valeb/Projekt/Bilder/DSC_0028.JPG

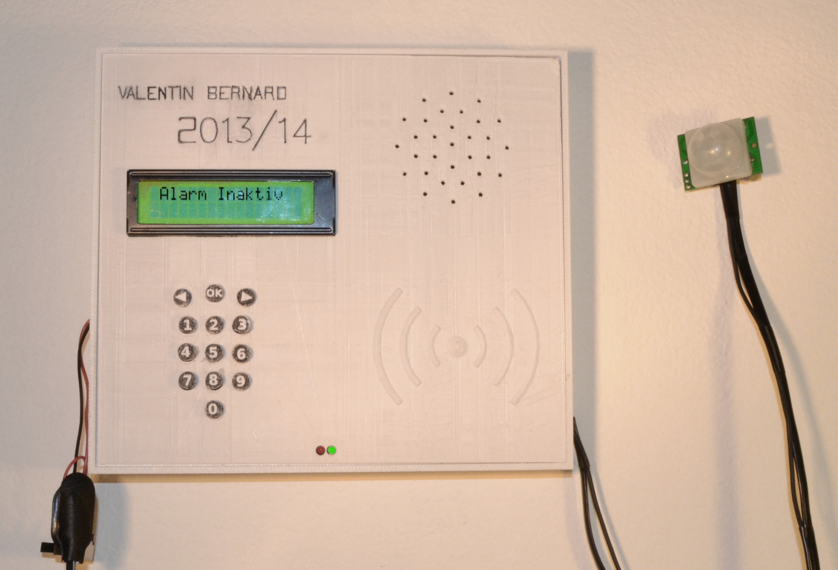
Bilder/DSC_0028.JPG
