valeb/Projekt/Bilder/MFRC522_Kit.JPG

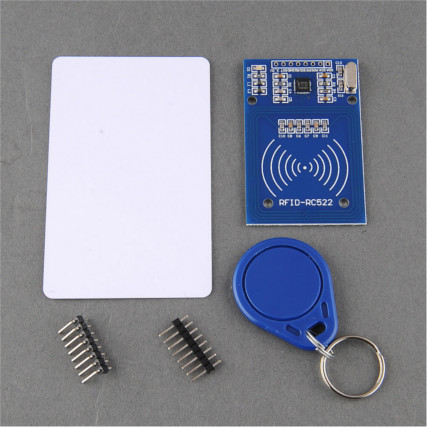
Bilder/MFRC522_Kit.JPG
