valeb/Projekt/README.md

Projekt
=======

Maturaprojekt von Valetnin Bernard, 5AEL Gewerbeoberschule Meran, SJ 2013/14
Alarmanlage mit RFID-Deaktivierung
