valeb/Projekt/Links.txt

RFID teuer: http://id-innovations.com/httpdocs/Modules%28non%20write%29.htm

RFID billig: http://www.dhgate.com/product/hot-sale-rc522-card-read-antenna-rfid-reader/169091775.html#s1-3-1|2641187833

Audio Generieren: http://www.engineersgarage.com/embedded/pic-microcontroller-projects/How-to-Generate-Sound-Using-PWM-With-PIC-Microcontroller

Bewegungsmelder: http://www.dhgate.com/product/wholesale-arduino-sensitive-pir-body-movement/131228033.html#s1-3-1|3856376912

Lichtschranke: http://www.conrad.de/ce/de/product/191710/Conrad-IR-Lichtschranke-Sender-EmpfaengerBausatz-12-15-VDC-Reichweite-max-5-m;jsessionid=CFABC5CF739E0C19DD2BF7DB4CFFCC95.ASTPCEN02
