valeb/Projekt/Dokumentation/Dokumentation.odt

Projektdokumentation:

Alarmanlage mit RFID-Tag

Ein Projekt von Valentin Bernard
GOB Meran 2013/14

# Projektbeschreibung

## Ziel des Projekts

Im Rahmen des Fachs Technisches Zeichnen und Projektieren muss jeder Schüler der Elektronik-Fachrichtung der Gewerbeoberschule Meran in der fünften Klasse ein selbst gewähltes Abschluss- projekt realisieren. Ich habe mich für eine Alarmanlage entschieden.

Ziel des Projekts war es, eine Anlage zu entwickeln, welche das Eindringen einer Person in einen Raum erkennt und dies akustisch meldet. Dabei sollte sich die Anlage per Knopfdruck von jedem aktivieren lassen, aber nur die Eingabe eines Passcodes oder das Annähern eines RFID-Tags sollten sie deaktivieren können.

## Erster Entwurf

### Hardware

Im erstem Entwurf war eine Anlage, bestehend aus einer Zentrale und diversen angeschlossenen Sensoren vorgesehen. Als Sensoren waren handelsübliche Infrarot-Bewegungsmelder oder Lichtschranken vorgesehen..

Die Zentrale sollte aus einer Platine in einem 3D-gedruckten Gehäuse bestehen, welche mehrere Eingänge für Sensoren, ein Tastenfeld für die Eingabe des Deaktivierungscodes (1-9 und „Enter“), einen Taster für die Aktivierung der Anlage, ein RFID-Lesegerät, einen Lautsprecher sowie eine rote und eine grüne LED zur Statusanzeige beinhalten sollte. Ein LCD-Bildschirm war lediglich als Zusatzfunktion geplant.

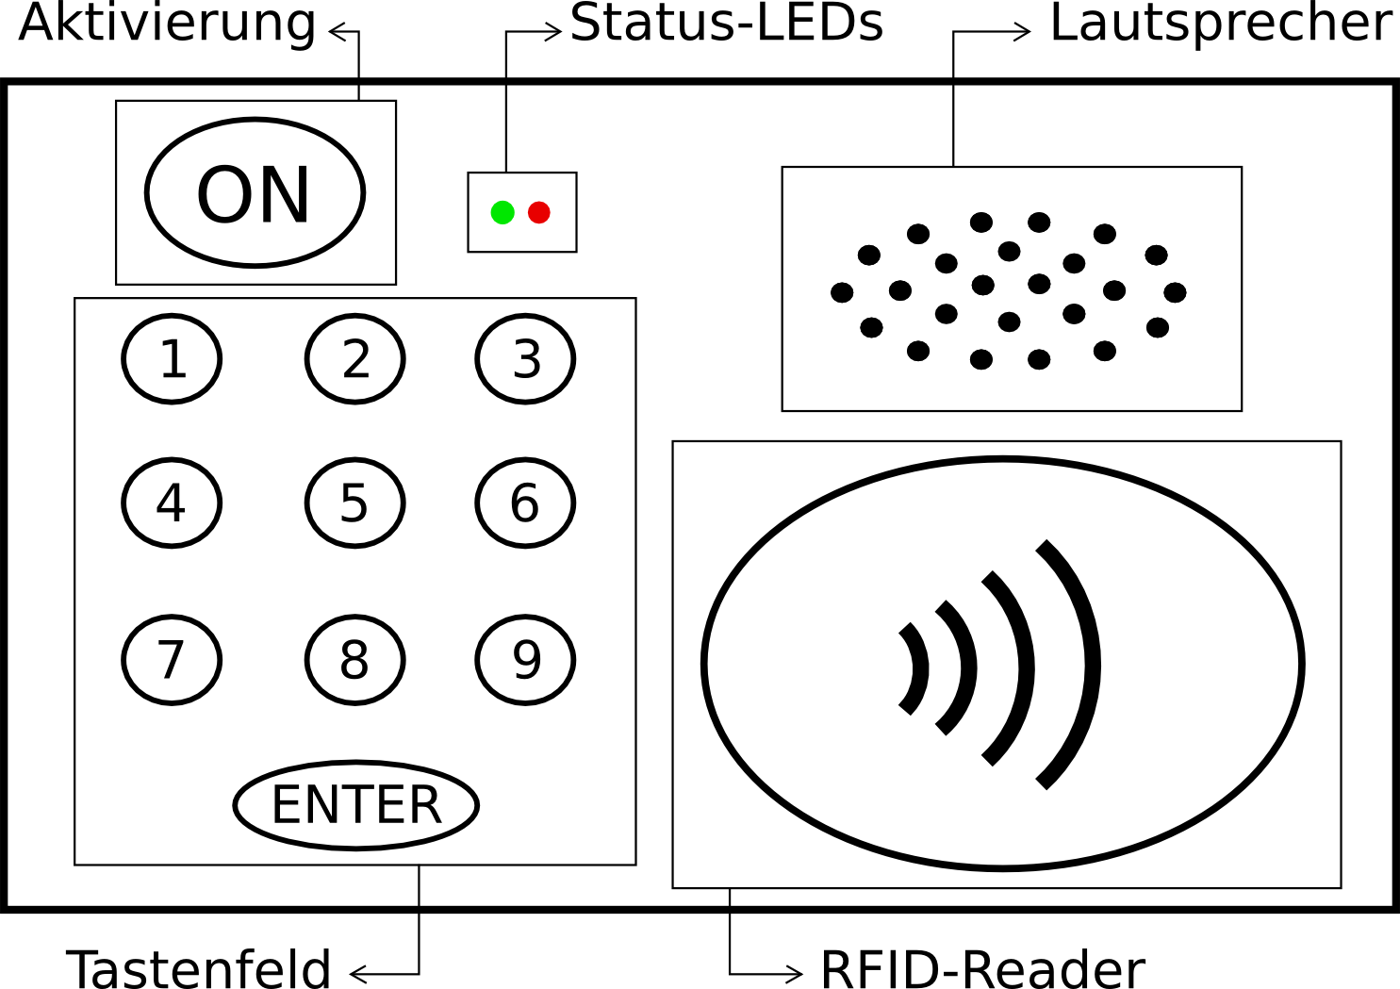
[picture p3: figure]

Abbildung 1: Erster Hardware-Entwurf

### Software

Die Alarmanlage sollte, nach der Aktivierung durch einen Knopfdruck, ständig sämtliche Sensoreingänge kontrollieren. Sobald ein Sensor aktiviert wird, sollte ein Alarm ausgegeben werden. Nach 5 Minuten ohne Sensorsignal sollte sich der Alarm wieder ausschalten, um unnötige Lärmbelästigung zu vermeiden.

Die Deaktivierung der Anlage sollte über die Eingabe eines selbst gewählten Passworts oder über ein RFID-Tag erfolgen, welches vom eingebauten RFID-Lesegerät erkannt wird. Das gewählte Passwort sollte nach Ausfall der Stromversorgung erhalten bleiben.

Die Status-LEDs sollten den Zustand der Anlage anzeigen: Rot für „Aktiv“, grün für „Inaktiv“. Dies war im ersten Entwurf die einzige Form der Visualisierung des Zustands.

### Zusatzfunktionen

Im ersten Entwurf war vorgesehen, nach Realisierung der Grundfunktionen weitere Zusatzfunktionen zu implementiert sofern dafür noch Zeit zur Verfügung stand. Die angedachten Funktonen waren: die Aktivierung des Alarms nach mehrmaliger Falscheingabe des Codes, Deaktivierung über Funk oder sogar die Versendung eines Alarm-SMS über ein GSM-Modul.

## Realisiertes Projekt

Die realisierte Anlage entspricht in großen Teilen dem ersten Entwurf, jedoch unterscheidet sie sich in einigen Details, auf welche im Folgenden grob eingegangen wird.

### Funktionsbeschreibung

Die Funktion der Anlage entspricht der Aufgabenstellung. Die Anlage erkennt, solange sie aktiviert ist, das Eintreten einer Person oder eines Tiers in einen Raum mit Hilfe eines Bewegungsmelders und gibt darauf hin über einen Lautsprecher einen relativ lauten akustischen Alarm aus. Die Aktivierung erfolgt, wie vorgesehen, per Knopfdruck, und die Deaktivierung erfolgt per Eingabe des selbst gewählten Passwortes. Die Deaktivierung mit RFID-Tag funktioniert aus bisher ungeklärten Gründen noch nicht, Näheres dazu im Kapitel „Software – RDIF“(S.??). Die Anlage benötigt eine externe Gleichstromversorgung von 9-12V.

Von den Zusatzfunktionen wurde bisher keine implementiert, jedoch könnte mit der bestehenden Hardware die Funktion „Aktivierung durch Falscheingabe“ realisiert werden. Nachdem nur ein Prototyp der Platine gefertigt wurde, ist es unmöglich weitere Funktionen hinzuzufügen, da diese eine Erweiterung der Hardware voraussetzen.

### Hardware

Die Hardware der Anlage unterscheidet sich in einigen Punkten vom ersten Entwurf. Ein Unterschied besteht darin, das lediglich ein Sensoranschluss auf der Platine vorgesehen ist, nämlich der für den Infrarot-Bewegungsmelder. Außerdem wurde Der LCD-Bildschirm bereits in die erste Version integriert, um eine zusätzliche Vereinfachung der Bedienung zu erzielen. Weitere kleinere Änderungen betreffen die Ergänzung einer Vor- und einer Zurück-Taste sowie die Verschmelzung des Aktivieren-Knopfs mit der OK-Taste. Der Rest der Hardware entspricht dem ersten Entwurf.

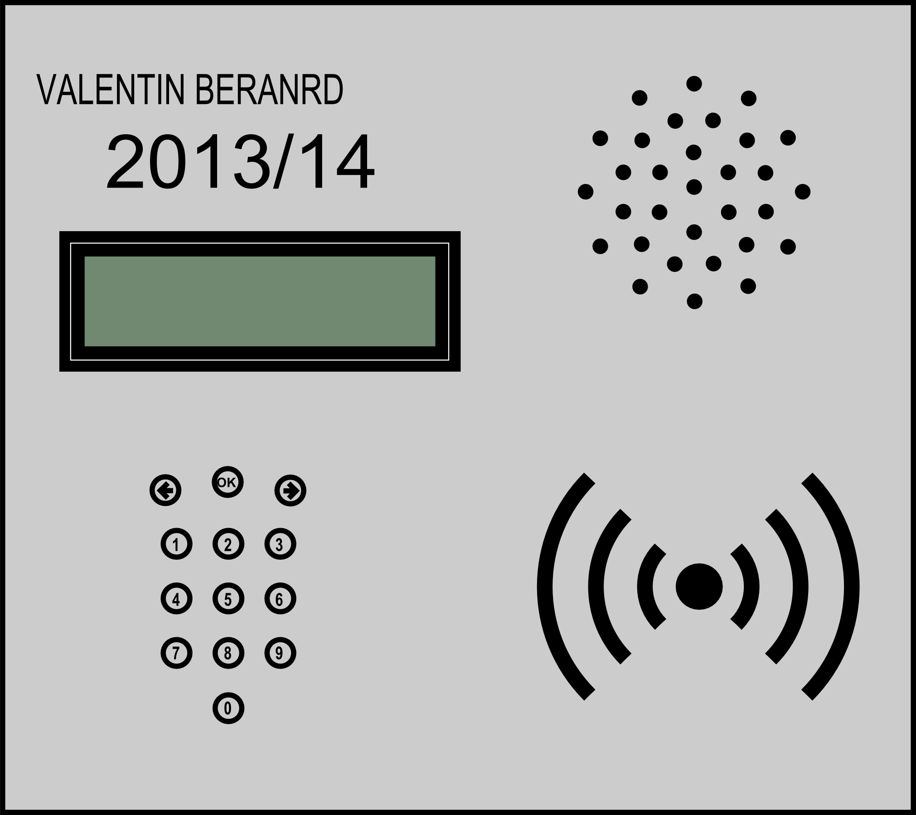
[picture p4: figure]

Abbildung 2: Gehäusedeckel

Abbildung 3: Platinen und Lautsprecher

Abbildung 3: Gehäusedeckel

### Software

Die Alarmanlage wertet, solange sie aktiv ist, ständig den angeschlossenen Bewegungsmelder aus. Wird dieser ausgelöst wird über den eingebauten Lautsprecher ein Alarm ausgegeben welcher wie geplant nach 5 Minuten ohne Bewegung verstummt.

Die Deaktivierung über das Passwort sowie die Möglichkeit der Abänderung desselben wurde erfolgreich implementiert, jedoch wird das Passwort bei Unterbrechung der Stromversorgung auf den Standartwert zurückgesetzt. Die Deaktivierung über ein RFID-Tag bereit einige Probleme, doch die Kommunikation mit dem Lesegerät über die SPI-Schnittstelle funktioniert einwandfrei. Das Problem liegt nur noch beim Übermitteln der richtigen Befehle an das Lesegerät.

# Technische Details

## Hardware

### Schaltplan

Der Schaltplan für das Projekt wurde mit Eagle™ 6.5.0 erstellt. Die meisten Bauteile waren in der Standardbibliothek zu finden, für den Mikrocontroller wurde zusätzlich eine Bibliothek von Motorola verwendet.

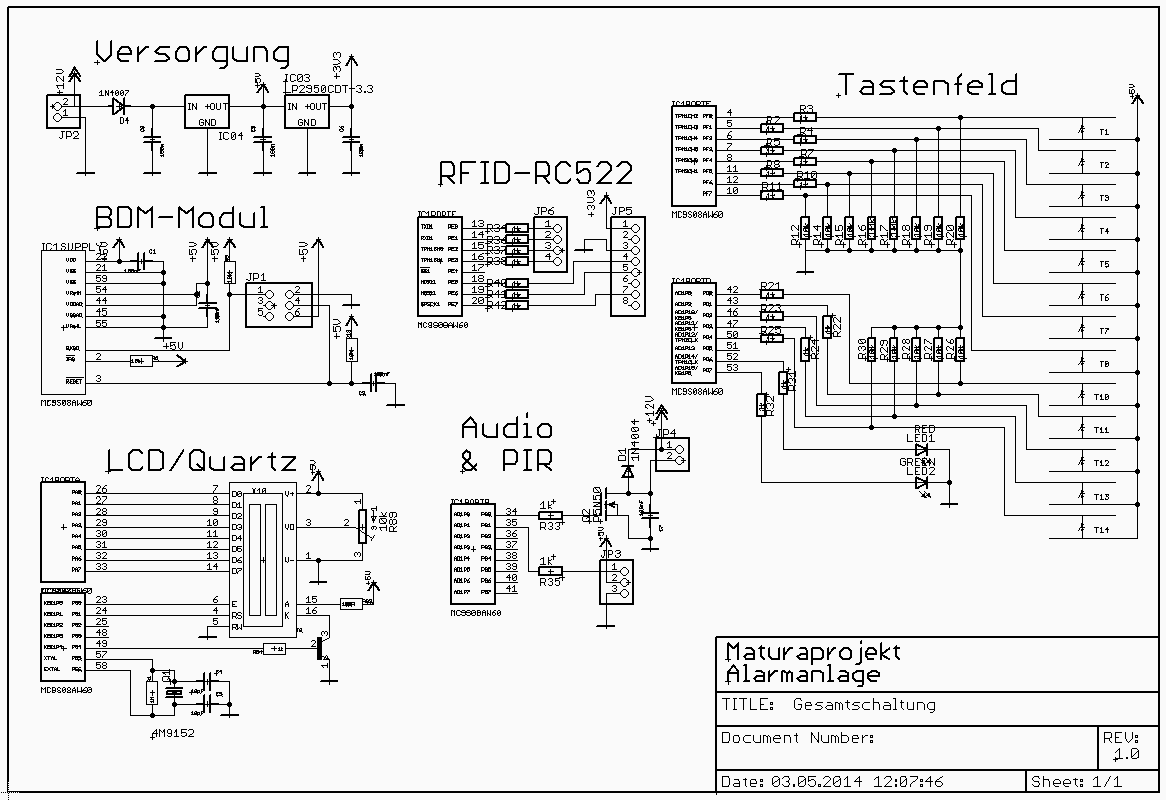
[picture p5: figure]

Abbildung 4: Vollständiger Schaltplan Ein Ausdruck in besserer Qualität befindet sich in den Anlagen

Die Planung der Schaltung erwies sich bei diesem Projekt als nicht sonderlich aufwendig, da der selbe Controller und das selbe LCD-Display verwendet werden wie auf dem Demoboard, weshalb die entsprechenden Schaltblöcke direkt vom Demoboard übernommen werden konnten. Der Rest der Schaltung besteht großteils aus Tastern und Steckerleisten. Der einzige Schaltblock der einige Entwicklungsarbeit erforderte war jener zur Ausgabe des Alarms über einen Lautsprecher.

### Schaltung Lautsprecher

Die Schaltung für die Ausgabe des Alarms besteht aus einem Mosfet, einem Freilaufdiode und einer Klemme mit 2 Anschlüssen für den Lautsprecher. Außerdem wurde ein Kondensator zur Abrundung des Rechtecksignals eingebaut.

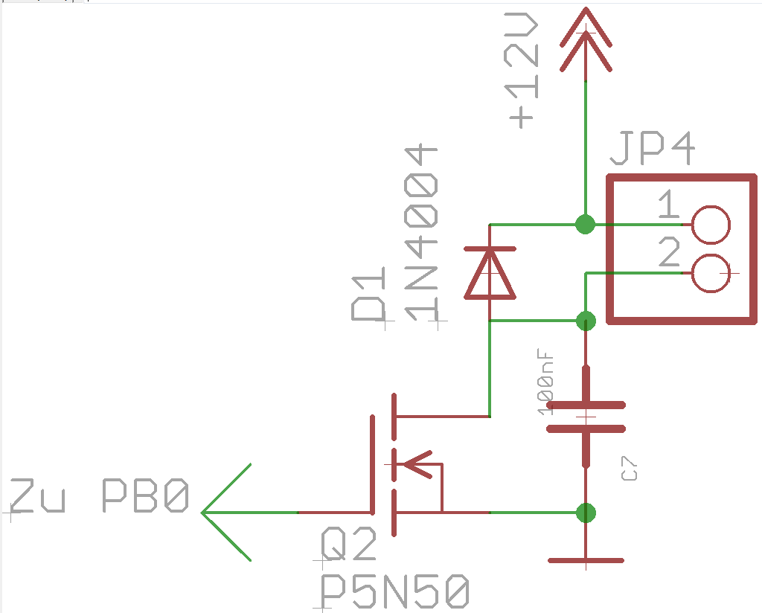
[picture p6: figure]

Abbildung 5: Noch mal machen

Als Mosfet ist im Moment der P5N50D eingezeichnet, jedoch ist dies nicht das geeignete Bauteil. Benötigt wird ein Logic-Level-Mosfet wie z.B der P60N06L. Da dieser die selbe Pinbelegung wie der P5N50D aufweist kann er ohne Änderung der Platine direkt eingebaut werden.

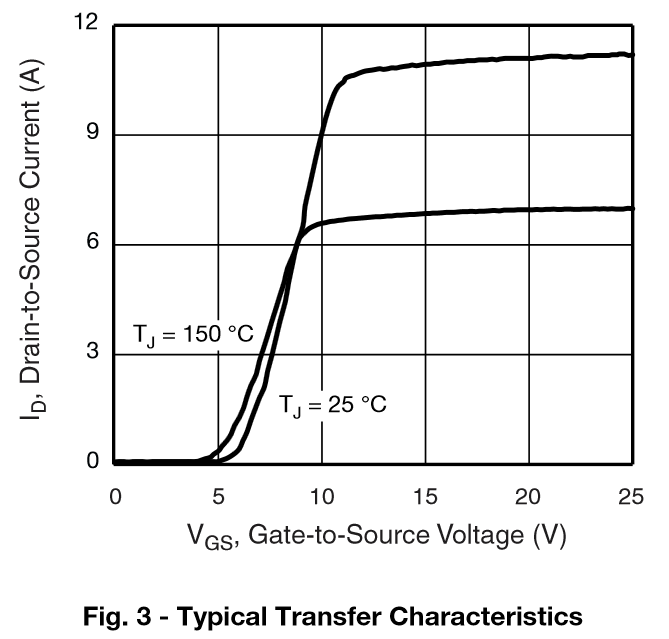
[picture p7: figure]

Abbildung 6: P5N50D

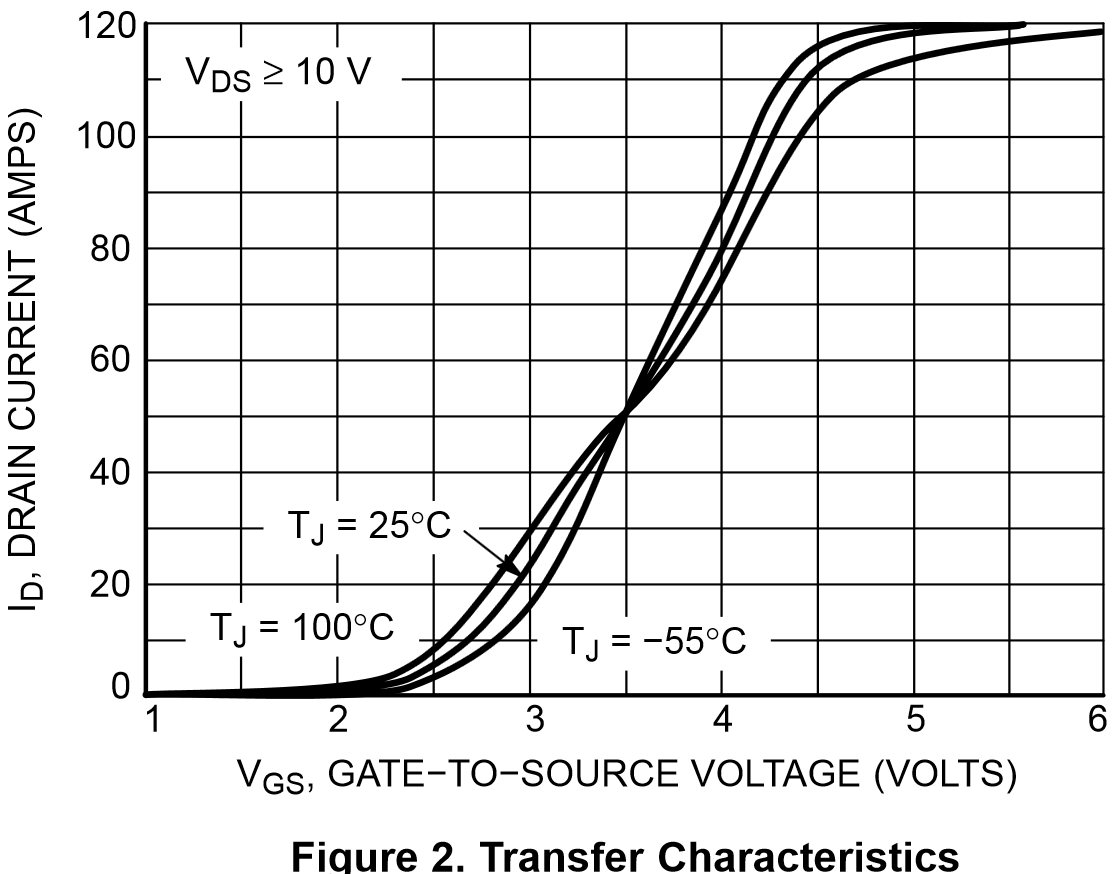
[picture p8: figure]

Abbildung 7: P60N06L

Aus den Transfer-Charakteristiken ist ganz klar ersichtlich dass der P5N50D für diese Schaltung ungeeignet ist, da der Mikrocontroller ledicglich eine Spannung von 5V am Gate anlegt. Der P60N06L ist hingegen ideal für den Zweck.

Die eingezeichnete Diode 1N4004 ist ebenfalls nicht das aktuell verwendete Bauteil. Stadtessen wird die Shottky-Diode 1N5819 verwendet, da diese im Gegensatz zur 1N4004 bei Frequenzen in Hörbereich besser funktioniert. Jedoch sollte die Schaltung auch mit der 1N4004 funktionieren.

Der verwendete Lautsprecher ist ein alter ausgebauter Lautsprecher mit einen Innenwiderstand von 8Ω und einer Nennleistung von 3W. Eigentlich kann aber jeder beliebige Lautsprecher verwendet werden, wenn seine Kennwerte in ungefähr dem selben Bereich liegen.

### Bauteile

Sämtliche für die Erstellung des Projekts nötigen Bauteile können online bestellt werden. Zum Großteil sind es Standardbauteile wie Widerstände, Kondensatoren, Taster, Steckerleisten usw. Die Spannungsversorgung wird von einem 5V und einen 3,3V-Spannungsregler übernommen, dazu wird eine externe 9-12V Quelle benötigt.

#### Mikrocontroller

Als Mikrocontroller wird der Motorola MC9S08AW32 zusammen mit einem 4,9252MHz Schwingquarz verwendet. Der Controller hat eine ausreichende Anzahl von Ports und seine Rechenleistung ist für dieses Projekt mehr als ausreichend.

#### LCD-Display

Der verwendete LCD-Bildschirm MBCF162D6B ist zweizeilig und alphanumerisch und wird über acht Datenleitungen, 2 Versorgungsleitungen und 4 Steuerleitungen angesteuert.

#### Bewegungsmelder

Der verwendete Bewegungsmelder ist ein Passiv-Infrarot-Bewegungsmelder. Er benötigt eine Versorgungsspannung von 5V und gibt bei jeder Aktivierung einen 5V-Puls mit fester Länge aus.

#### RFID-Lesegerät

Das verwendete RFID-Lesegreät basiert auf dem RFID-Chip MFRC522 von MIFARE®. Auf der verwendeten Reader-Platine ist die Antenne bereits aufgebaut und die SPI-Schnittstelle des RFID-Chips kann direkt verwendet werden.

Das Gerät wurde gewählt da es in einem für Arduino konzipierten Kit erhältlich ist, welches neben der Reader-Platine auch noch ein RFID-Tag sowie eine RFID-Karte beinhaltet. Das ganze Kit kostet je nach Bezugsquelle 4-7€, also inklusive Lieferung um die 11€.

Der verwendete Chip, der MFRC522, ist ein read/write-IC für 13,56MHz-RFID. Er benötigt eine 3,3V-Stromversorgung und ist in der Lage mit wenig externen Beschaltung eine RFID-Antenne zu betreiben. Der Chip unterstützt diverse Interfaces, nämlich I²C, UART und SPI, jedoch sind auf der gekauften Platine nur für SPI die Aus-und Eingänge an die Steckleiste geführt.

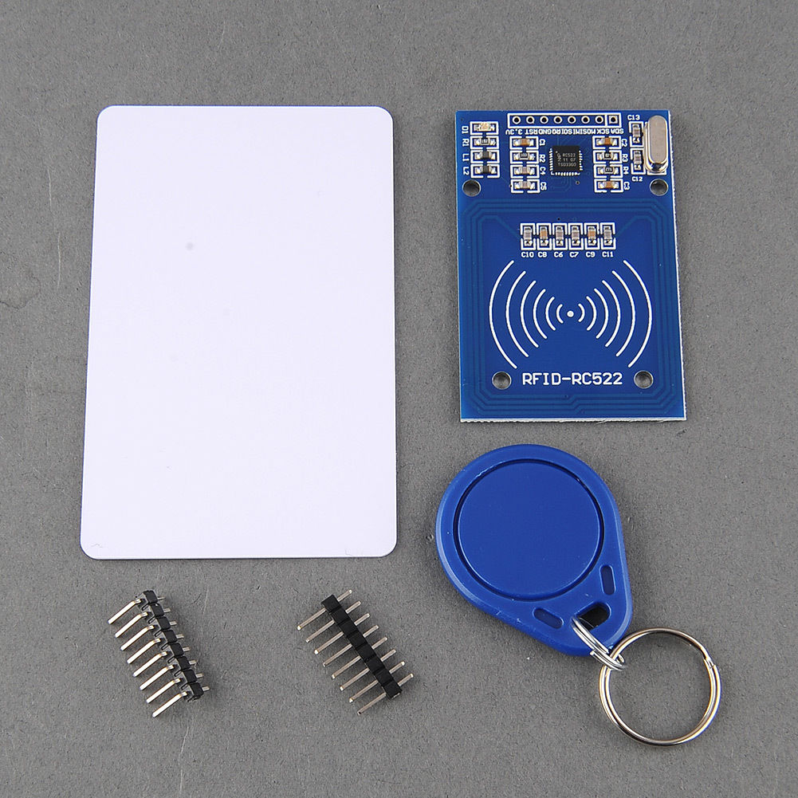
[picture p9: figure]

Abbildung 8: Inhalt des RFID-Kits

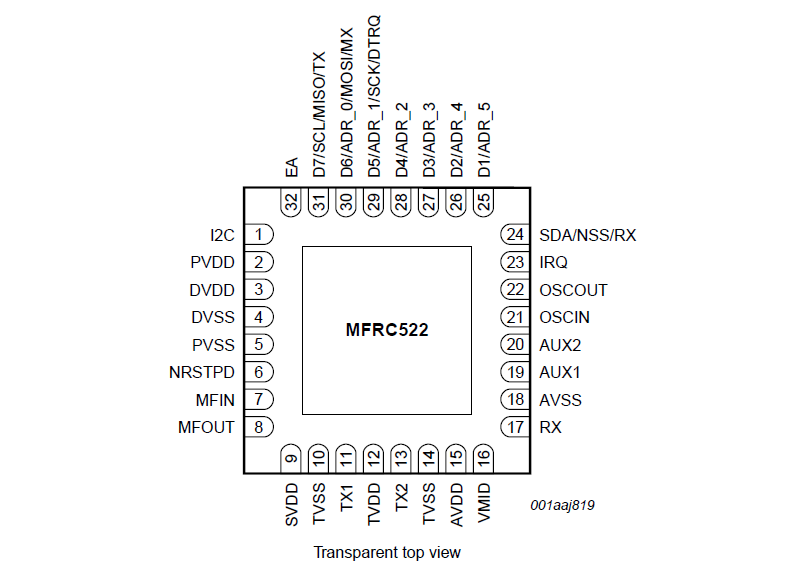
[picture p10: figure]

Abbildung 9: Pinning Configuration MFRC522

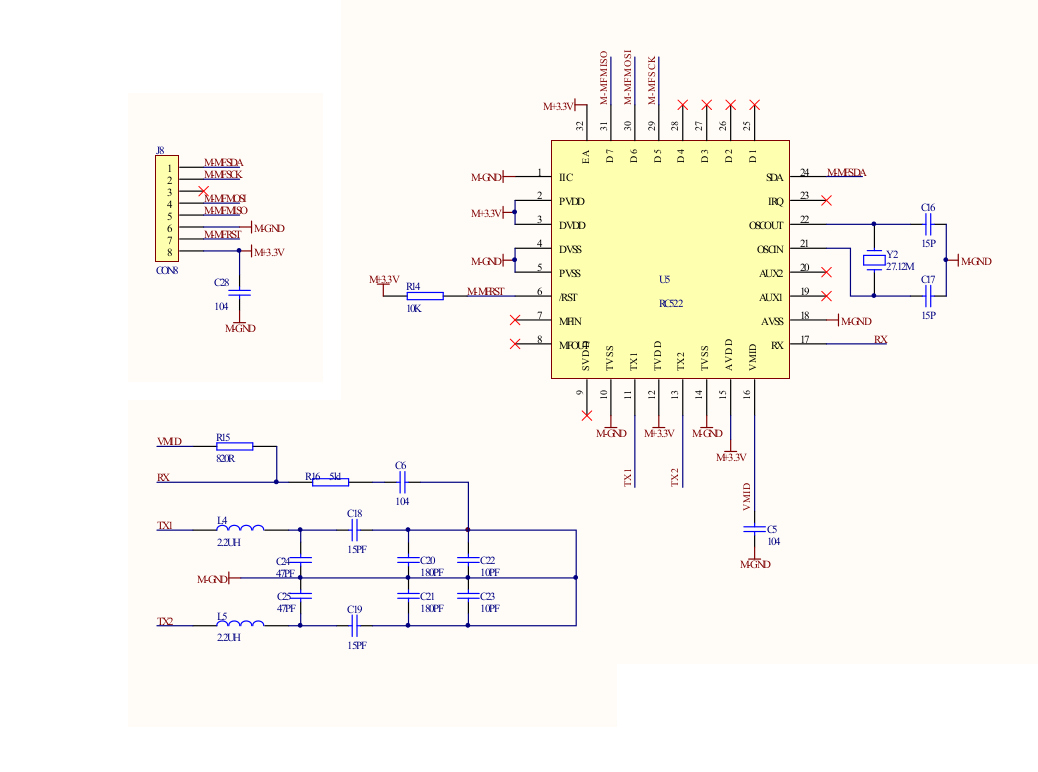
[picture p11: figure]

Abbildung 10: RFID-Lesegerät Vollständige Schaltung

### Vollständige Bauteilliste

### Board

Ebenfalls mit Eagle™ 6.5.0 wurde aus dem Schaltplan das Board, also die Platine erstellt. Diese misst 4025x3300mil, also 10,224x8,382cm. Die Board-Datei wurde anschließend eingeschickt und maschinell gefertigt.

(Foto Board)

#### Fehler in der ersten Version

Diese Version hat einige minimale Fehler, welche auf der Platine durch geschicktes Löten und Verkabeln ausgebessert wurden. Es wurde ein falsches Packpage für den 3,3V-Spannungsregler verwendet, wodurch dieser schräg aufgelötet werden musste.

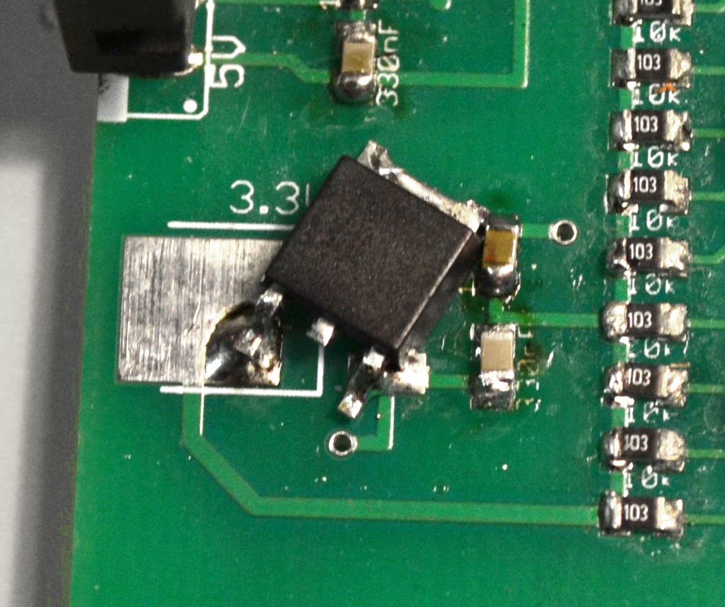
[picture p12: figure]

Abbildung 11: Kreativ aufgelöteter 3,3V-Regler

Auch wurde wegen eines Fehlers in dem im Internet gefundenen Schaltplan des RFID-Lesegeräts die Stiftleiste die zum Gerät führt falsch verbunden. Daher konnte zur Verbindung mit dem Lesegerät nicht wie vorgesehen ein Flachbandkabel verwendet werden. Stadtessen musste das Lesegerät durch ein selbst erstelltes überkreuztes Kabel verbunden werden.

Außerdem wurde für den Chip-Select-Anschluss des Lesegeräts kein Anschluss auf dem Stecker vorgesehen da beabsichtigt wurde diesen direkt auf 'Low' zu legen (Masse). Später stellte sich heraus dass der Chip-Select-Pin zwischen jeder Datenübertragung auf 'High' gesetzt werden muss. Zum Glück konnte jedoch einer der sicherheitshalber zusätzlich ausgeführten Ausgänge des Mikrocontrollers verwendet werden.

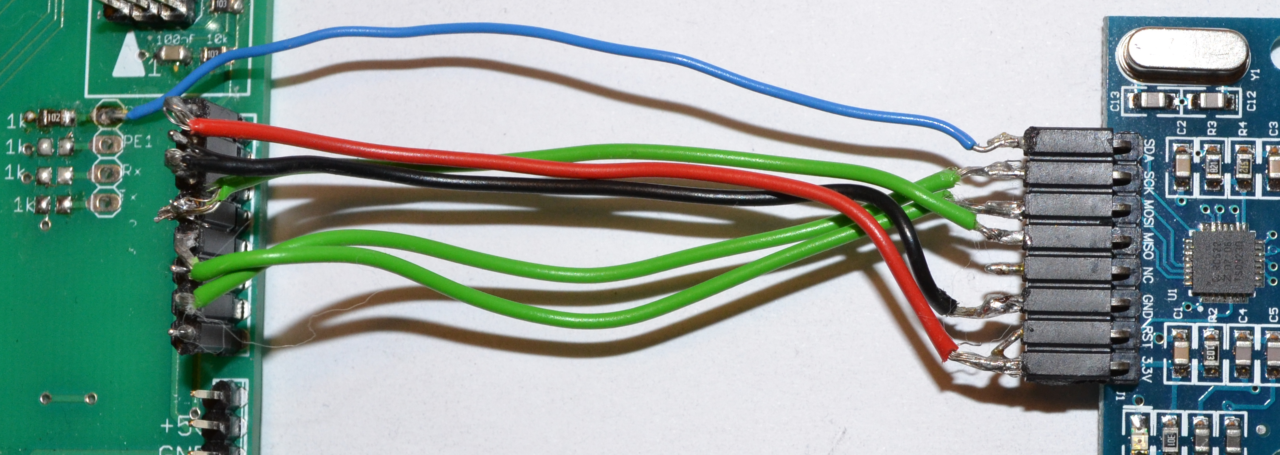
[picture p13: figure]

Abbildung 12: Verkabelung und Zusatzleitung für Chip-Select (Blau)

#### Board Version zwei

Aufgrund des geringen Einflusses der Fehler auf die Funktionstüchtigkeit des Projekts wurde entschieden, keine zweite Version der Platine zu fertigen. In einer zweiten Version hätten neben der Behebung der beschriebenen Fehler die Schaltung um ein GSM- oder ein Funkmodul erweitert werden können, um eine der im ersten Entwurf vorgesehenen Zusatzfunktionen zu realisieren. Aus Zeitmangel wurde darauf verzichtet.

### Gehäuse

Das Gehäuse der Alarmanlage wurde mit der CAD-Software VariCAD™ gezeichnet und mit dem schuleigenen 3D-Drucker gefertigt. Innerhalb der Hülle befinden sich die Platine, der Lautsprecher und das RFID-Lesegreät. Der Bewegungsmelder wird zusätzlich angeschlossen.

(Bilder Hülle 3D)

## Software

Die gesamte Software für die Anlage wurde in der Programmiersprache Assembler geschrieben. Dazu wurde die Programmierumgebung Codewarrior™ von Freescale verwendet. Natürlich wäre eine Programmierung in C ebenso möglich gewesen.

### Grundstruktur

Das Programm besteht aus einer Schrittkette mit drei Schritten: „Inaktiv“, „Aktiv“ und „Alarm“. Zusätzlich kann vom Schritt „Inaktiv“ in den Schritt „Change_PW“ gesprungen werden, um das Passwort zu ändern.

Im Schritt „Inaktiv“ kann die Schaltung per Knopfdruck aktiviert werden. Außerdem kommt man durch drücken der Vor-Taste in den Schritt „Change_PW“. Solange die Anlage inaktiv ist blinkt die grüne LED.

Sobald die Anlage in den Schritt „Aktiv“ wechselt, wird ununterbrochen der Bewegungsmelder ausgemessen, um bei eventueller Auslösung desselben in den Schritt „Alarm“ zu springen. Außerdem kann man durch eine Passworteingabe oder durch das Annähern des RFID-Tags in den Schritt „Inaktiv“ zurückkehren. Im aktiven Zustand blinkt die rote LED.

In letzten Schritt, „Alarm“, wird über den eingebauten Lautsprecher der Alarm ausgegeben. Auch hier kann über das Passwort oder das RFD-Tag zu „Inaktiv“ zurückgesprungen werden. Zusätzlich kehrt die Anlage automatisch in den Schritt „Aktiv“ zurück wenn der Bewegungsmelder 5 Minuten lang kein Signal gibt. Die rote LED leuchtet bei ausgelöstem Alarm durchgehend.

(Foto Schrittkette)

### Bewegungsmelder

Die Routine zum Auslesen des Bewegungsmelders wird in den Schritten „Aktiv“ und „Alarm“ aufgerufen. Sie wertet die vom Sensor ausgegebenen Pulse aus und gibt durch Setzen von drei Flags bekannt, wenn eine Bewegung erfasst wurde.

Damit der Alarm nicht durch einen eventuell fehlerhaft ausgegebenen Puls des Bewegungsmelders ausgelöst wird, ist es zur Aktivierung des Alarms nötig, dass mindestens 3 Pulse in Folge auftreten. Dabei wird bei jedem hereinkommenden Puls eines der drei Flags gesetzt. Wenn alle drei Flags gesetzt sind, löst die Software den Alarm aus. Vergeht zu viel Zeit zwischen zwei Pulsen werden alle Flags wieder gelöscht.

### Tonausgabe

Der Alarmton wird über einen Rechteckimpuls ausgegeben, welcher einen Mosfet durchschaltet. Die Frequenz wird von einem Timer-Interrupt festgelegt, in dem die Wartezeit (in Clock-zyklen) bis zum nächsten Interrupt festgelegt werden kann. Bei gegebener Clockfrequenz von 4,9152 MHz lässt sich die Frequenz des Rechteckimpulses aus der eingegeben Zahl der Warte-Zyklen folgendermaßen berechnen:

f = {f rsub{C}} over {2*Zahl} = 4,9152 over {2*Zahl}
Daher ergibt sich die Zahl, welche man zum Erreichen einer bestimmten Frequenz im Timerinterrupt als Wartezeit eingeben muss, aus der Formel

Zahl = {f rsub{C}} over {2*f} = 4,9152 over {2*f}

Der Faktor zwei im Nenner kommt daher, dass das Programm im Timer-Interrupt dem eines Blinklichts entspricht, d.h. bei jedem Interrupt wird das Output-Pin abwechselnd ein-und ausgeschaltet. Die Frequenz des Rechtecks ist damit halb so groß wie die Interrupt-Frequenz.

Die Software zur Tonausgabe arbeitet in einem einstellbaren Rhytmus fortlaufend eine Look-up-Table mit Zahlen ab, welche vom Timerinterrupt als Wartezeiten verwendet werden. Als Alarm werden lediglich zwei Töne abwechselnd ausgegeben, doch das selbe Programm kann auch zur Ausgabe von einfachen Melodien verwendet werden.

(Flussdiagramm?)

### Passwort

Das Programm für die Passwort-Eingabe kann in den Schritten „Aktiv“ und „Ausgelöst“ durch die Taste „OK“ aufgerufen werden. Auf dem LCD-Bildschirm wird bei Eingabe einer Zahl ein Sternchen ausgegeben. Mit einem weiteren klick auf OK bestätigt der Nutzer die Vollendung der Eingabe, worauf entweder in den Schritt „Inaktiv“ zurückgesprungen wird, oder für einige Sekunden der Textzug „FALSCHE EINGABE“ erscheint.

Die Passwort-Überprüfung geht softwaremäßig folgendermaßen von statten: zehn in der E-RAM aufeinander folgende Variablen beinhalten das Passwort. Dabei beinhalten beispielsweise bei einem Passwort mit sechs Stellen die ersten sechs Variablen je eine Zahl des Passwortes, während die restlichen vier $FF enthalten. Bei jeder Zahleneingabe überprüft das Programm die Übereinstimmung der Eingabe mit der Variablen an der jeweiligen Stelle. Sobald ein Fehler festgestellt wird, wird ein Fehler-Flag gesetzt. Beendet der Nutzer durch das OK die Eingabe wird nun überprüft, ob die nächste Variable $FF enthält. Tut sie dies nicht, war die Passworteingabe zu kurz und es wird ebenfalls das Fehler-Flag gesetzt. Ist an dieser Stelle im Programm nun kein Fehler-Flag gesetzt, bedeutet das, dass die Eingabe korrekt war. Die Anlage springt dann in den inaktiven Zustand.

(Flussdiagramm?)

#### Ändern des Passwortes

Zum Ändern des Passwortes muss im „Inaktiv“-Schritt die Vorwärts-Taste gedrückt werden. Die Schrittkette springt daraufhin in den „Passwort ändern“-Schritt, den der Nutzer erst verlassen kann wenn er mindestens ein Passwort der Länge '1' eingegeben hat. Mit OK bestätigt er die Eingabe und kehrt in den „Inaktiv“-Schritt zurück.

Die Passwort-Änderung funktioniert ähnlich wie die Passwort-Kontrolle, nur dass bei jeder Eingabe des Benutzers nicht der eingegebene Wert mit der Variablen verglichen wird, sondern die Variable mit dem eingegebenen Wert überschrieben wird. Bein Klick auf das OK werden die restlichen Variablen mit $FF überschrieben. Damit kann das neue Passwort verwendet werden.

(Flussdiagramm?)

### RFID

Die Erkennung eines RFID-Tags erfolgt über das angeschlossen RFID-Lesegerät, welches mit dem Mikrocontroller über SPI kommuniziert. Dabei wird in den Schritten „Aktiv“ und „Alarm“ an das Gerät eine Anfrage gesendet um zu erfahren ob sich ein RFID-Tag im Bereich der Antenne befindet. Ist dies der Fall, wird die Anlage auf „Inaktiv“ gesetzt.

#### SPI-Initialisierung

Die SPI-Schnittstelle wird als Master bei XYZ kHz konfiguriert, die Übertragung erfolgt Active-High und das Most-Significant-Byte wird als erstes gesendet.

Init_SPI

mov #%01011100,SPI1C1 ; SPI Aktiviert als Master

; ||||||||

; |||||||└───── Shifter directiom. 0 = 7..0

; ||||||└────── SS Output enable = 0

; |||||└─────── Clock Pahse, 0 = Middle o. Cycle

; ||||└──────── Clock Polarity 0 = Active High

; |||└───────── MSTR, 1 = Master

; ||└────────── Transmit Interrupt enable

; |└─────────── SPI enable

; └──────────── Interrupt enable

mov #%00000000,SPI1C2

; ||||||||

; |||||||└───── Bidirectional enable

; ||||||└────── SPI Stop in Wait mode

; |||||└─────── nc

; ||||└──────── Bidirectional, Output enable

; |||└───────── Mode-Fault enable

; ||└────────── nc

; |└─────────── nc

; └──────────── nc

mov #%00110000,SPI1BR ; Stellt den SPI_Clock ein

; ||||||||

; |||||||└───── )

; ||||||└────── > Timer Scaler 2..256 (2)

; |||||└─────── )

; ||||└──────── n.c

; |||└───────── )

; ||└────────── > Timer Prescaler 1..8

; |└─────────── )

; └──────────── n.c

rts

#### SPI-Kommunikation

Die gesamte Kommunikation mit dem RFID-Chip läuft über zwei Software Routinen ab: eine Schreib-und eine Leseroutine.

Die Lese-Routine benötigt lediglich eine Adresse, welche sie entsprechend dem Datenblatt des RFID-Chips in das Lesen-Format umwandelt. Die umgewandelte Adresse wird an den Chip gesandt, worauf dieser den Wert an der gesendeten Adresse zurückschickt.

Write_RFID

brclr 5,SPI1S,Ende_RW

lda Adresse

lsla

AND #%01111110

sta SPI1D

bclr 3,PORTE

S1Delay

brclr 7,SPI1S,S1Delay

lda SPI1D

lda Daten

sta SPI1D

S2Delay

brclr 7,SPI1S,S2Delay

lda SPI1D

bset 3,PORTE

Ende_RW

rts

Die Schreibroutine hingegen benötigt eine Adresse und ein Datenbyte. Wieder wird die Adresse laut Datenblatt umgewandelt, diesmal in das Schreiben-Format. Die Adresse wird als erstes gesendet, anschließend folgt das Datenbyte, worauf im RFID-Chip der Wert an der Adresse mit dem Datenbyte überschrieben wird.

Read_RFID

brclr 5,SPI1S,Ende_RW

lda Adresse

lsla

AND #%01111110

ORA #%10000000

sta SPI1D

bclr 3,PORTE

S3Delay

brclr 7,SPI1S,S3Delay

lda SPI1D

lda #$00

sta SPI1D

S4Delay

brclr 7,SPI1S,S4Delay

lda SPI1D

sta Daten

bset 3,PORTE

rts

Diese beiden Softwareteile, die das Kernstück der Kommunikation bilden, funktionieren einwandfrei. Jedoch ist es bisher nicht möglich vom RFID-Lesegerät irgendwelche Daten zu erhalten die auf die Erkennung des RFID-Tags hinweisen.

Zur Erkennung eines Tags wird 26H in den FOFO-Buffer des RFID-Lesegeräts.....

# Kostenberechnung
