valeb/Projekt/Dokumentation/Gantt-Diagramm-Plan.pdf

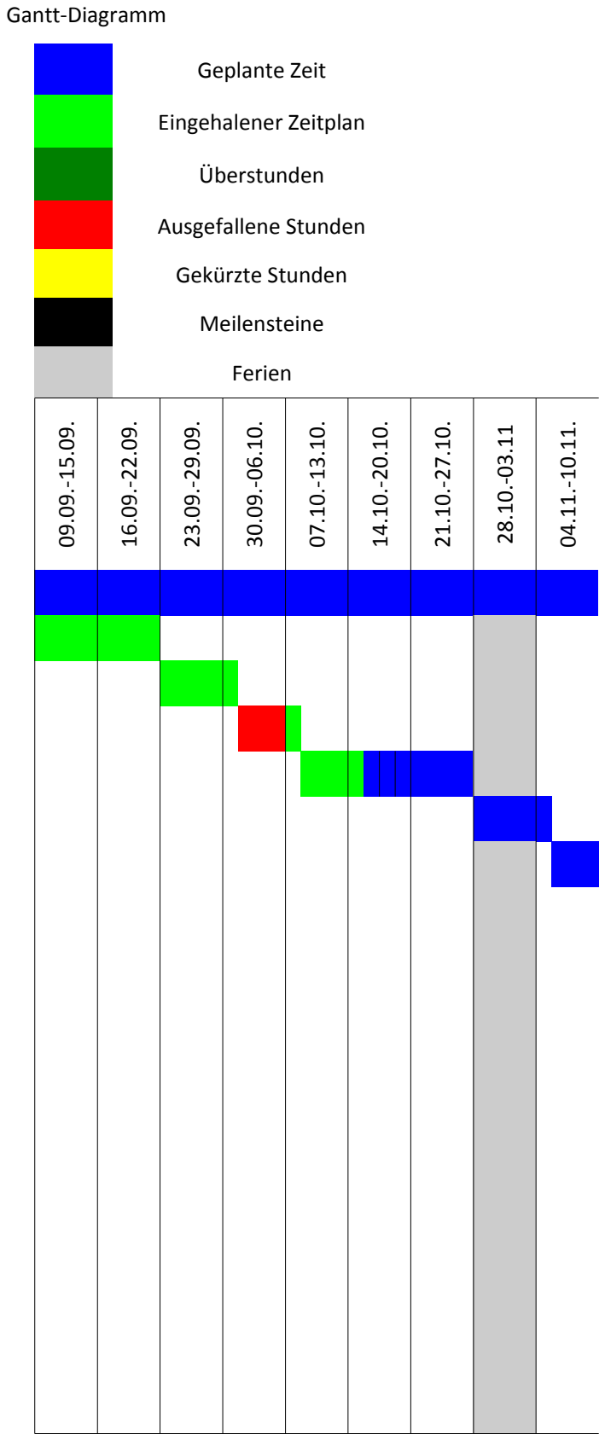
[picture p14: figure]
Gantt-Diagramm; Geplante Zeit; Überstunden; Ausgefallene Stunden; Gekürzte Stunden; Meilensteine; Ferien; Eingehalener Zeitplan

Projekt Alarmanlage | 0

Projekt
Grundplanung

Audioverstärker-Schaltung

Spannungsversorgung
Schaltung Taster-LEDs
Zusatzfunktionen planen

Sensoren Auswerten
Alarm Ausgeben
Anlage Aktivieren und Deaktivieren

Platine löten und testen
Fehler ausbessern
Passwort eingeben und ändern Softwarefehler ausbessern
Testphase

Bautelbestellung
Gantt-Diagramm

RFID-Tag Schaltung

Platine routen

RFID-Tag auslesen

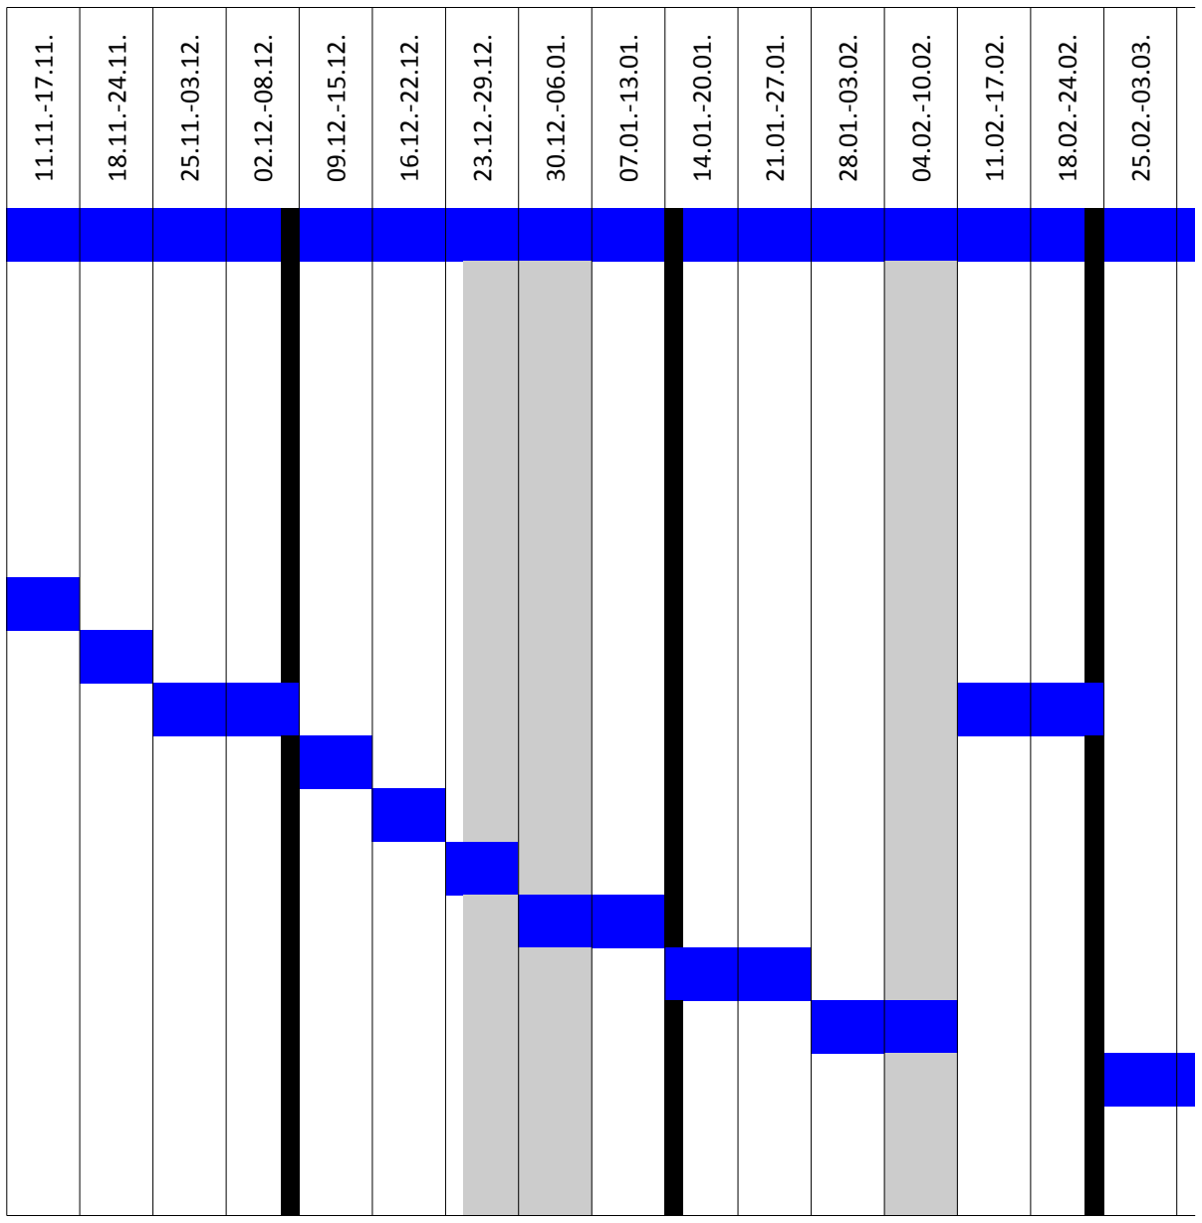
[picture p15: figure]

Abgabe Platine 1
1. Prototyp im

Haus
Abgabe Platine 2

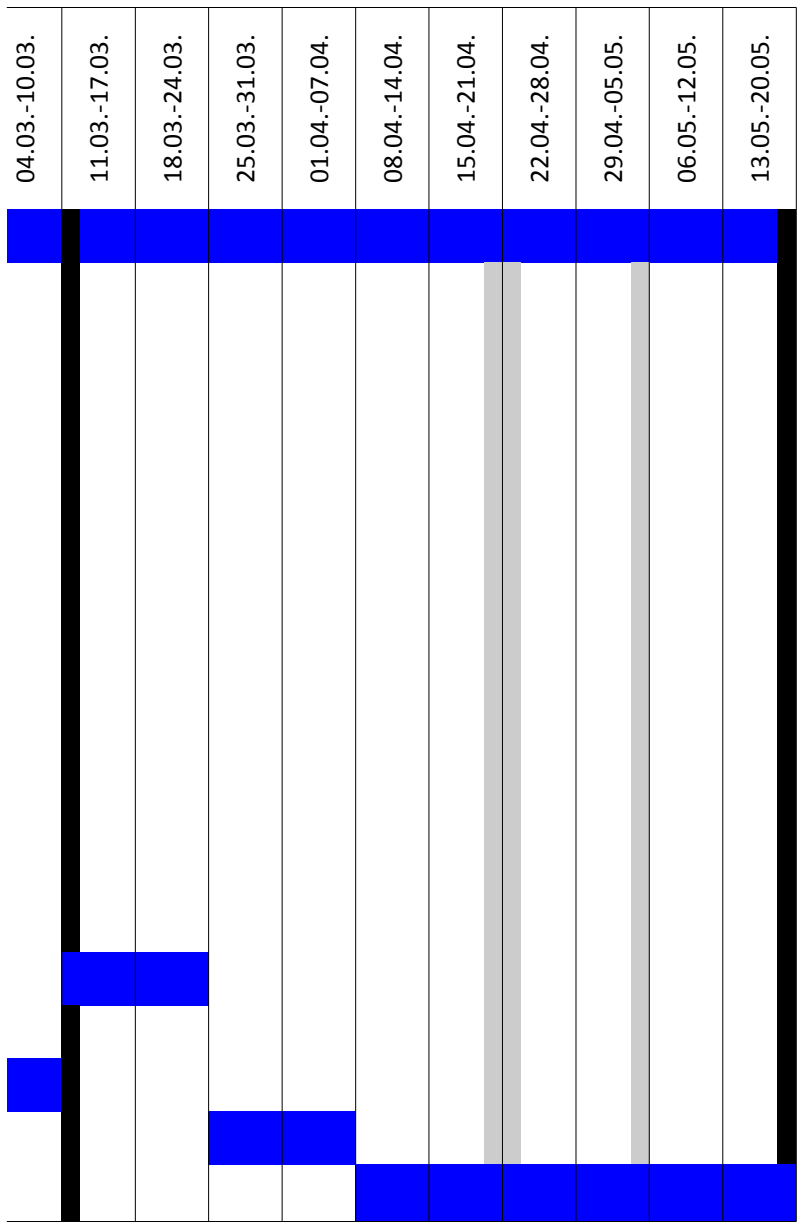
[picture p16: figure]

2. Prototyp im

Haus
Abgabe Projekt!
