valeb/Projekt/Bilder/Deckel3D.png

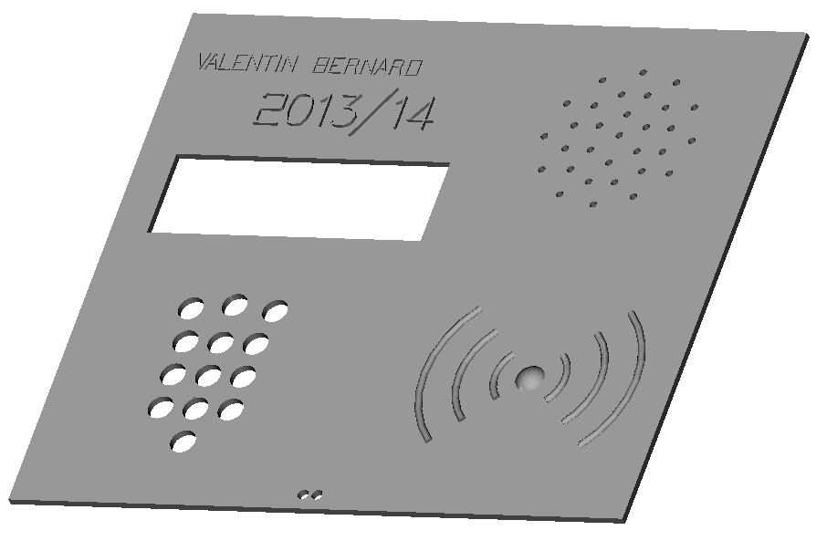
Bilder/Deckel3D.png
