valeb/Projekt/Bilder/Deckel3D_2.png

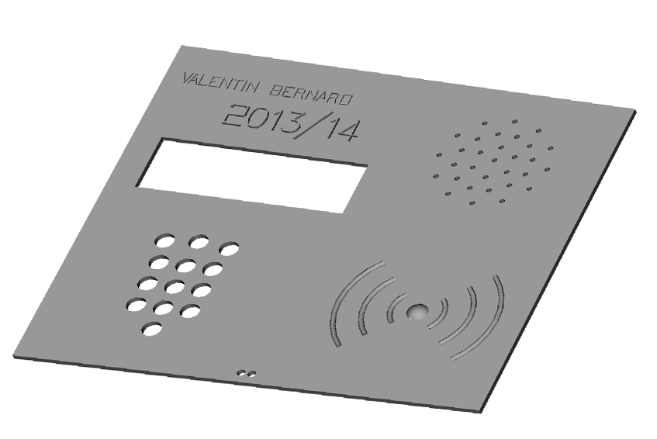
Bilder/Deckel3D_2.png
