valeb/Projekt/Bilder/Diagramm Designer/Blockschaltbild.png

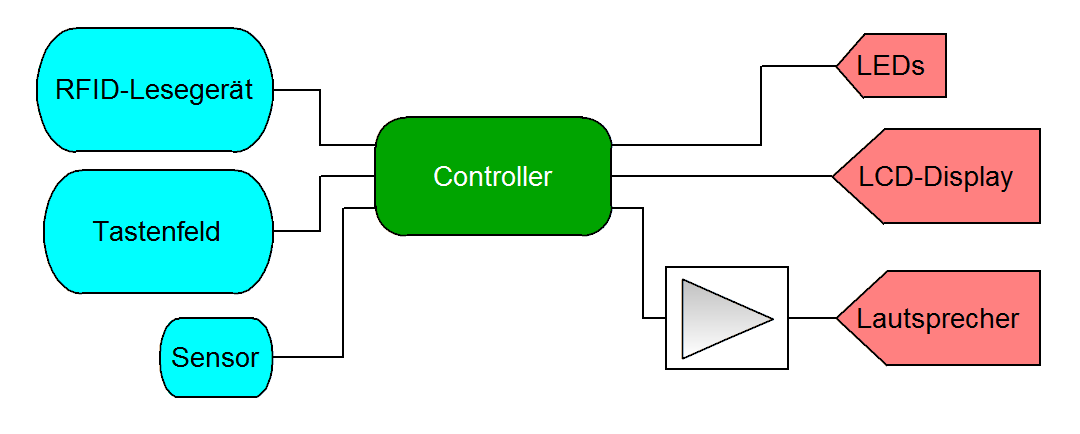
Bilder/Diagramm Designer/Blockschaltbild.png
