valeb/Projekt/Bilder/Diagramm Designer/Passwort.png

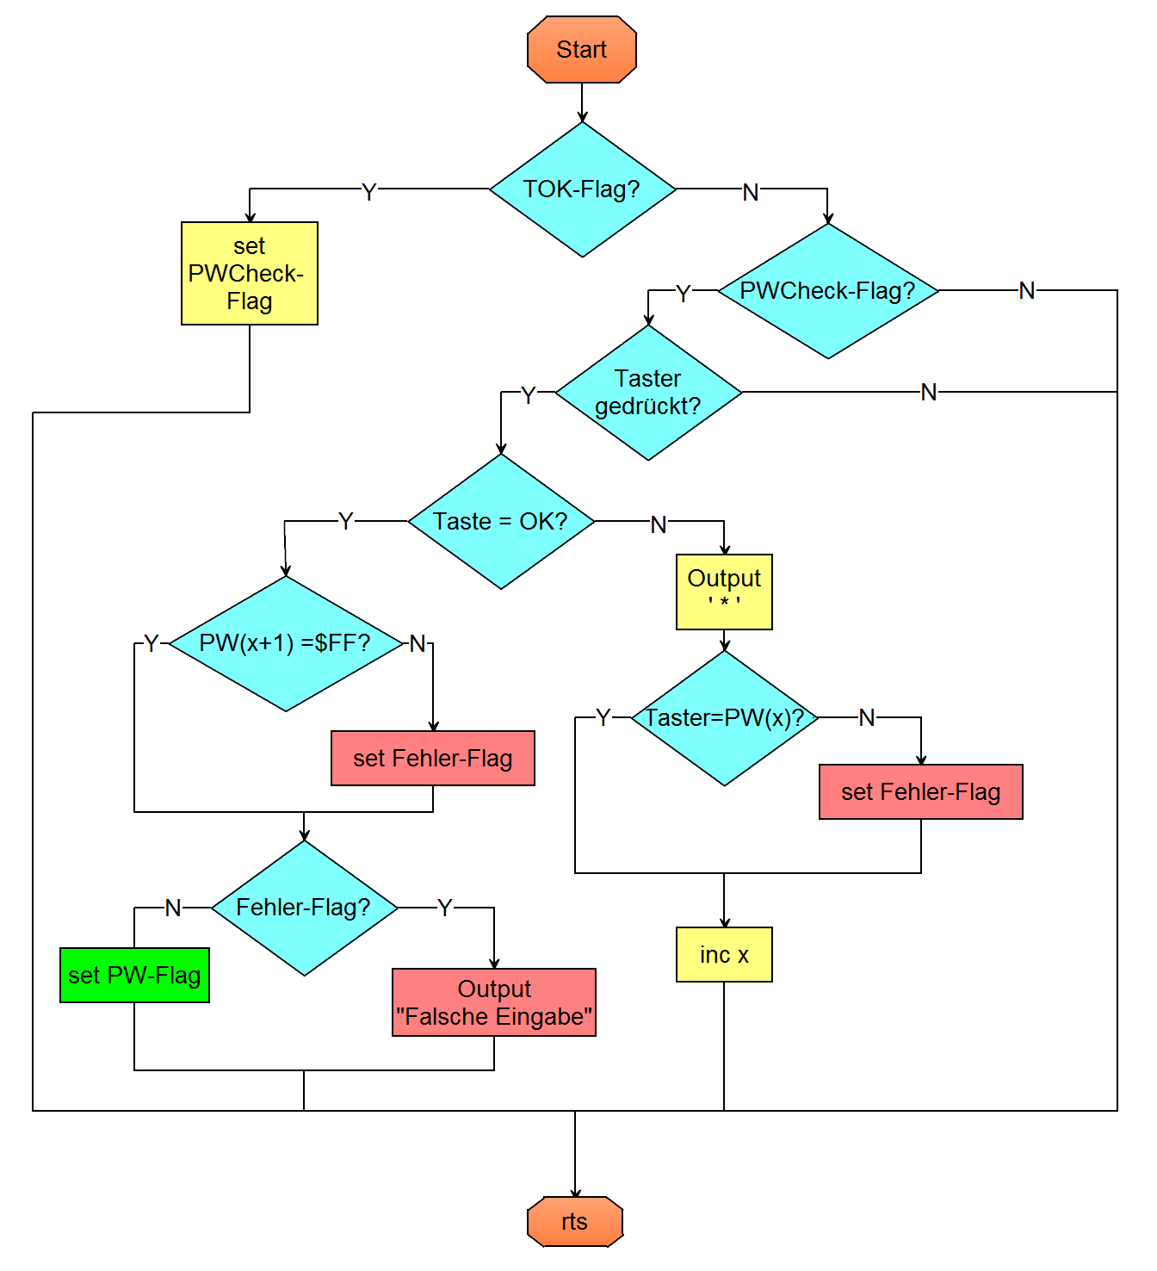
Bilder/Diagramm Designer/Passwort.png
