valeb/Projekt/Bilder/Diagramm Designer/Schrittkette.png

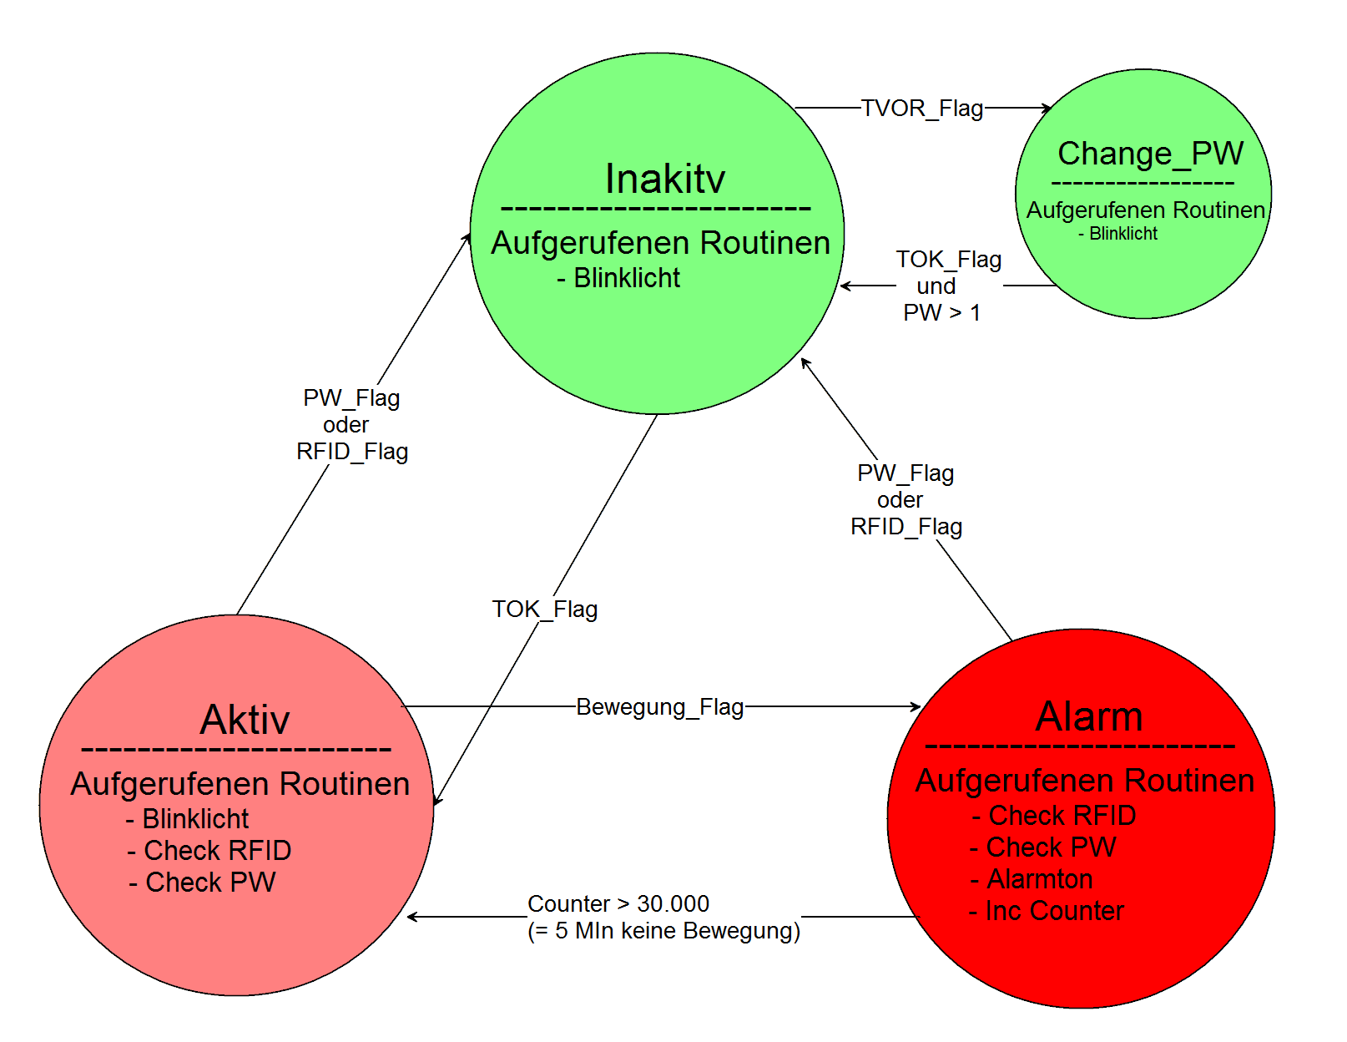
Bilder/Diagramm Designer/Schrittkette.png
