valeb/Projekt/Bilder/Diagramm Designer/Versorgungt.png

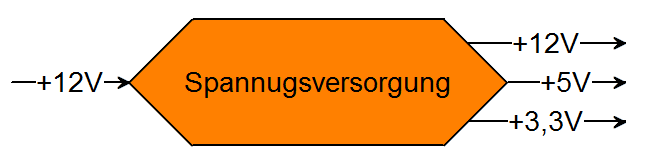
Bilder/Diagramm Designer/Versorgungt.png
