valeb/Projekt/Bilder/DSC_0081.JPG

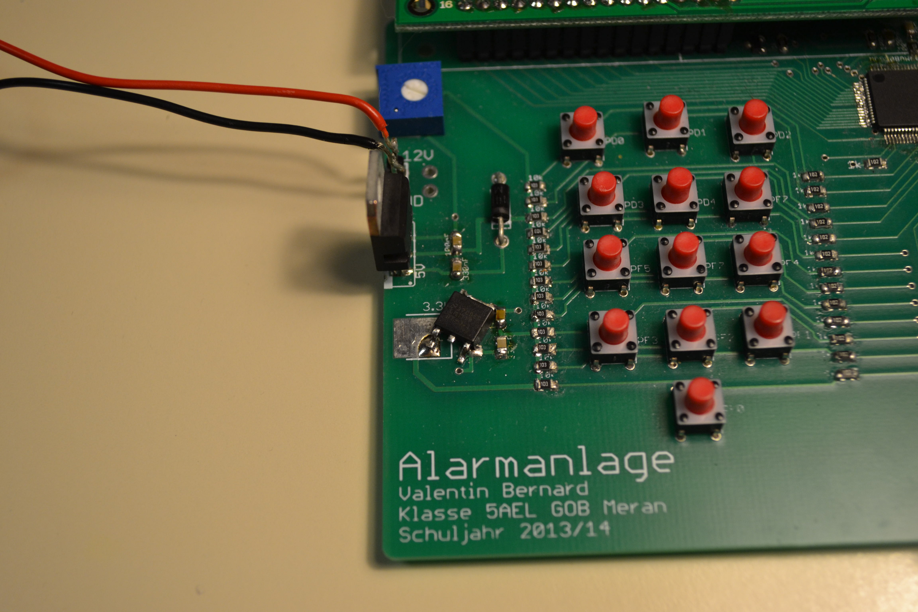
Bilder/DSC_0081.JPG
