valeb/Projekt/Bilder/DSC_0082.JPG

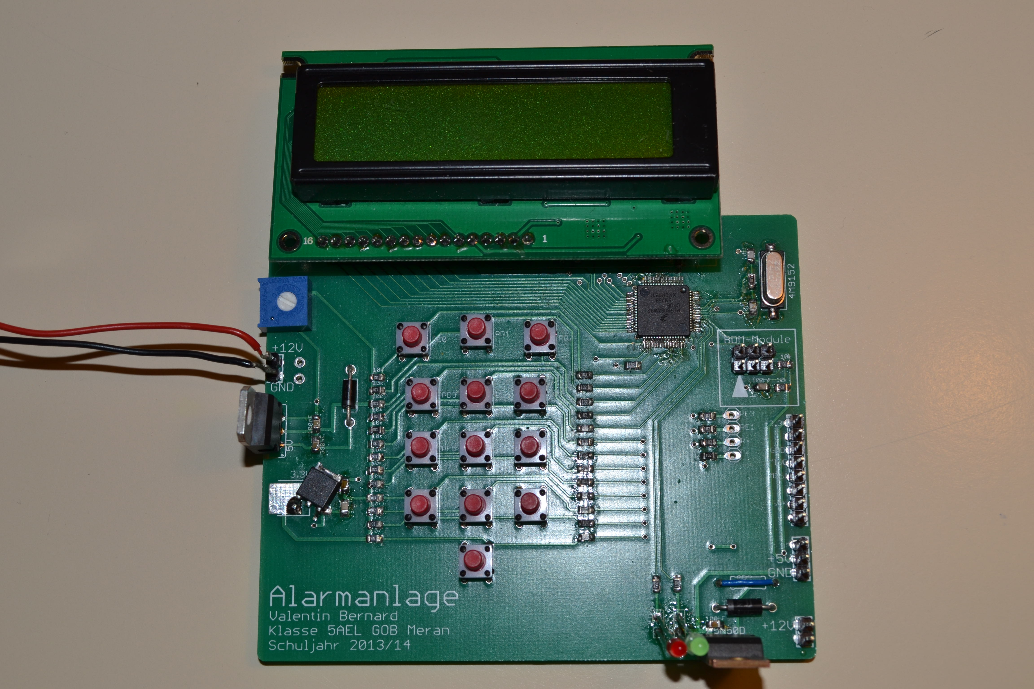
Bilder/DSC_0082.JPG
