valeb/Projekt/Bilder/DSC_0083.JPG

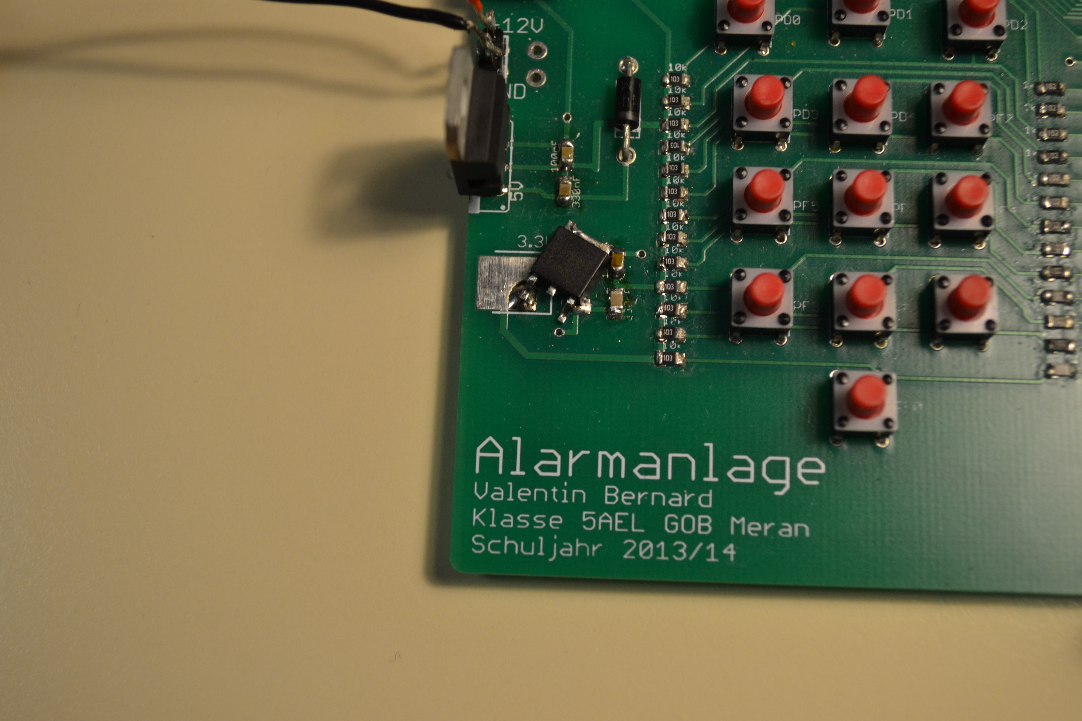
Bilder/DSC_0083.JPG
