valeb/Projekt/Bilder/Endversion.JPG

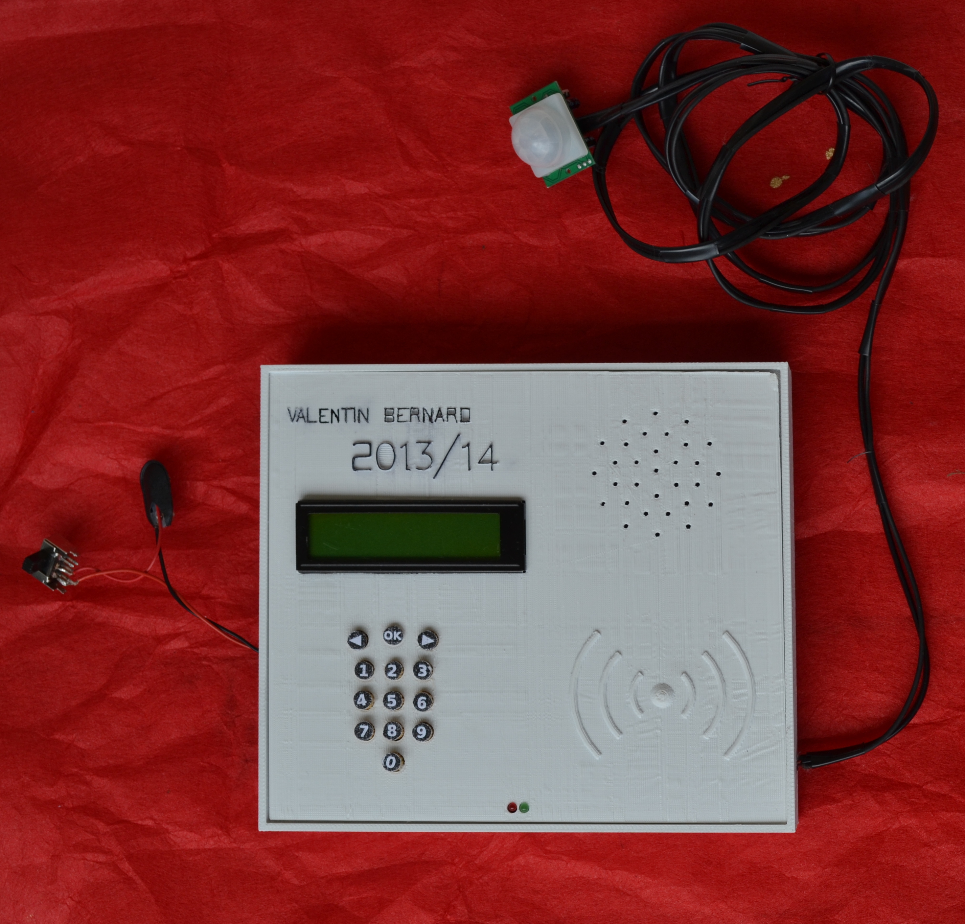
Bilder/Endversion.JPG
