valeb/Projekt/Bilder/Gantt.png

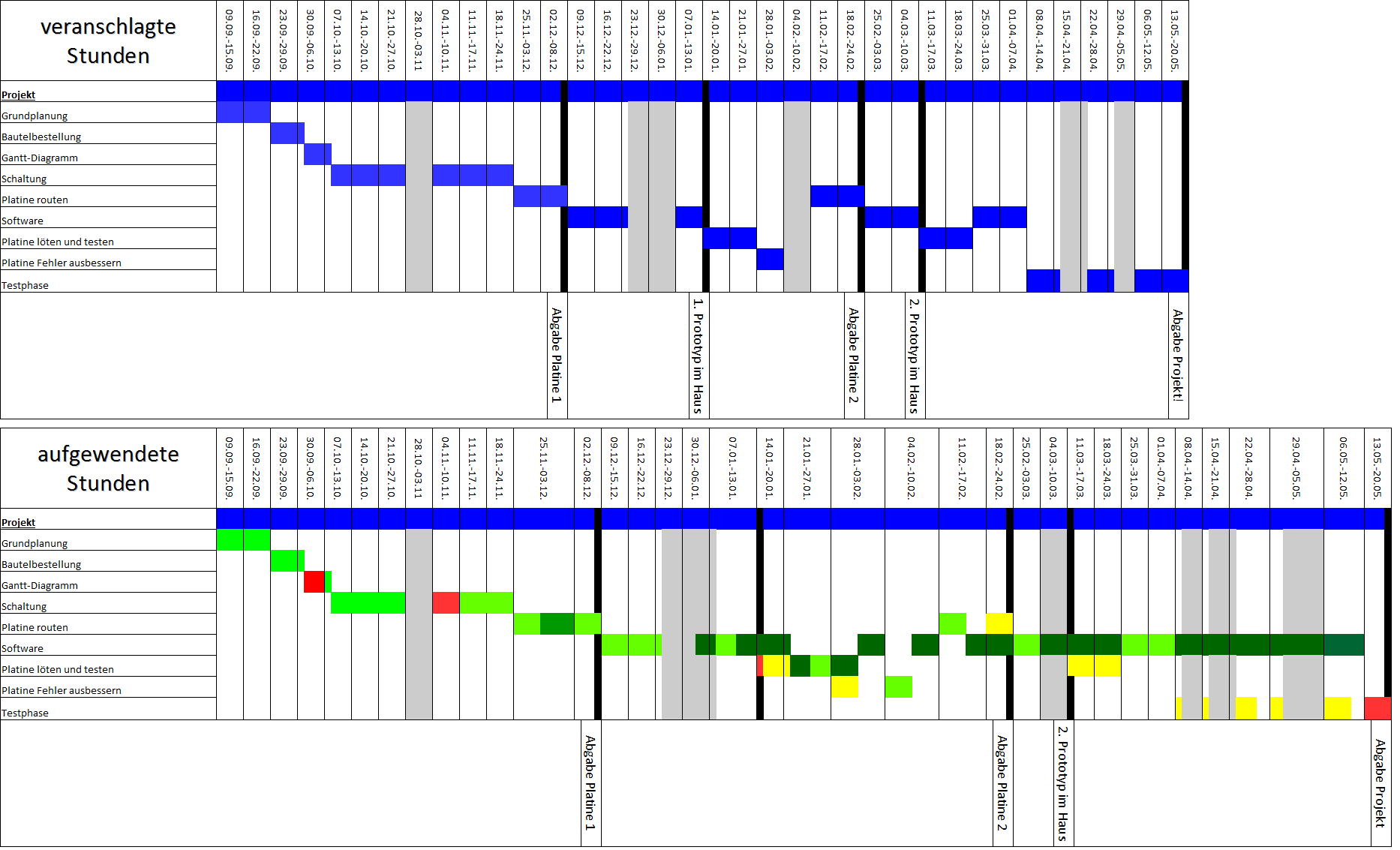
Bilder/Gantt.png
