valeb/Projekt/Bilder/Hülle3D.png

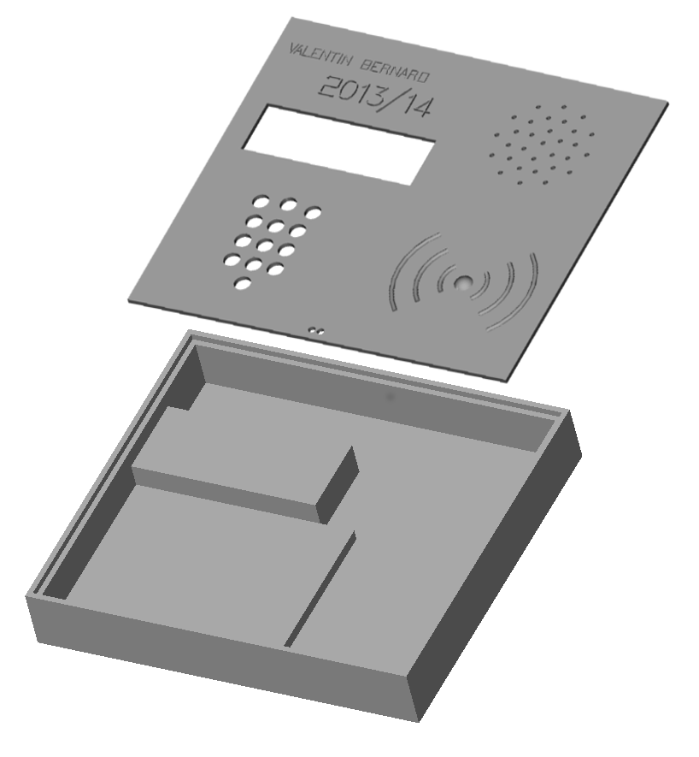
Bilder/Hülle3D.png
