valeb/Projekt/Bilder/Kosten.png

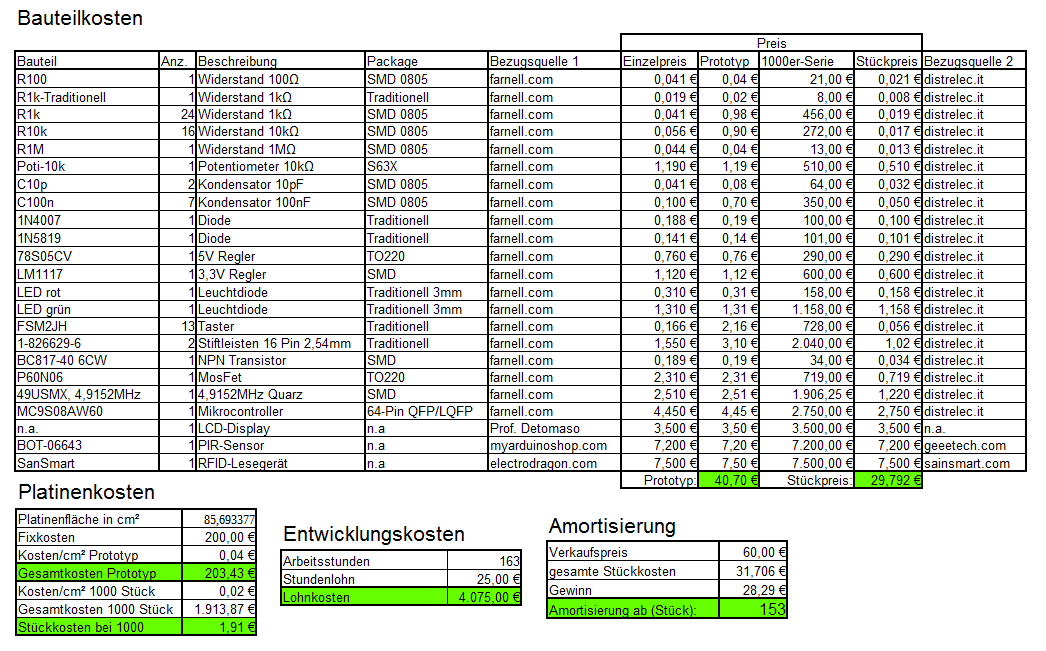
Bilder/Kosten.png
