valeb/Projekt/Bilder/Kostenrechnung.png

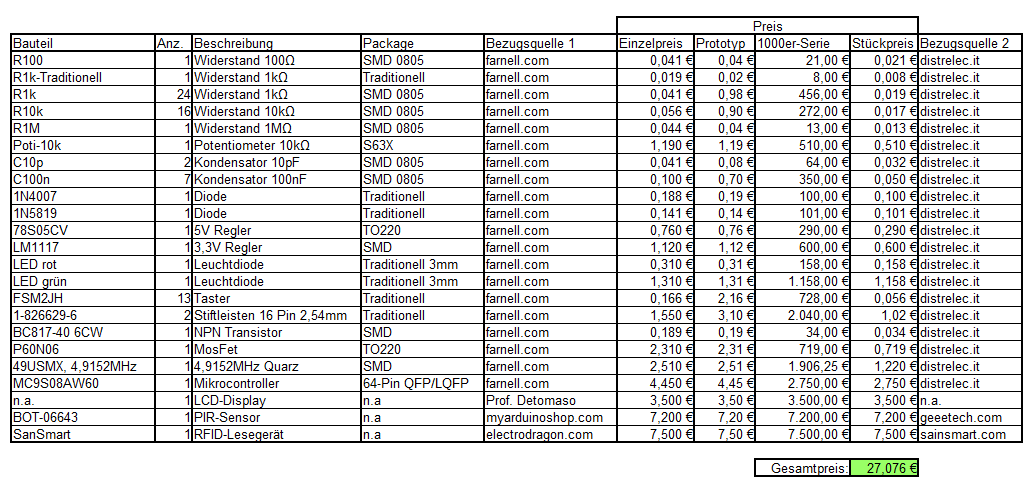
Bilder/Kostenrechnung.png
