valeb/Projekt/Bilder/Lausprecher.JPG

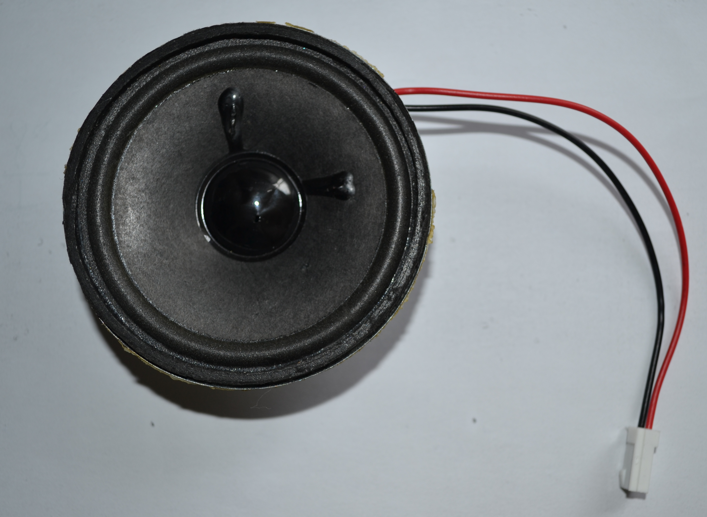
Bilder/Lausprecher.JPG
