valeb/Projekt/Bilder/Lesegerät.JPG

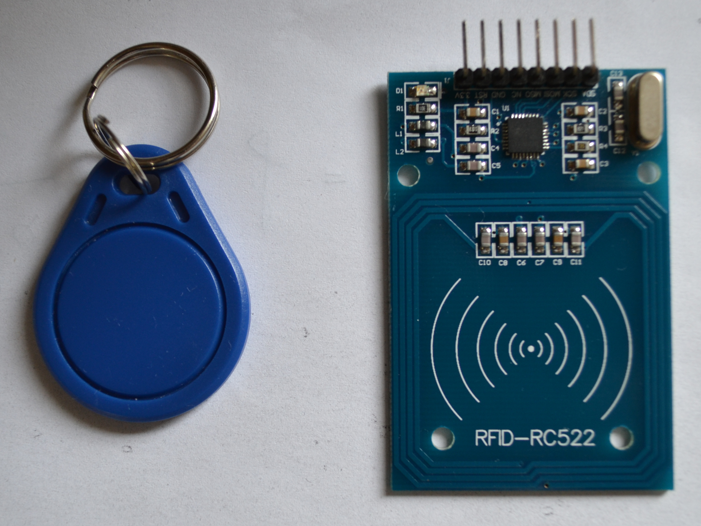
Bilder/Lesegerät.JPG
