valeb/Projekt/Bilder/MFRC522.png

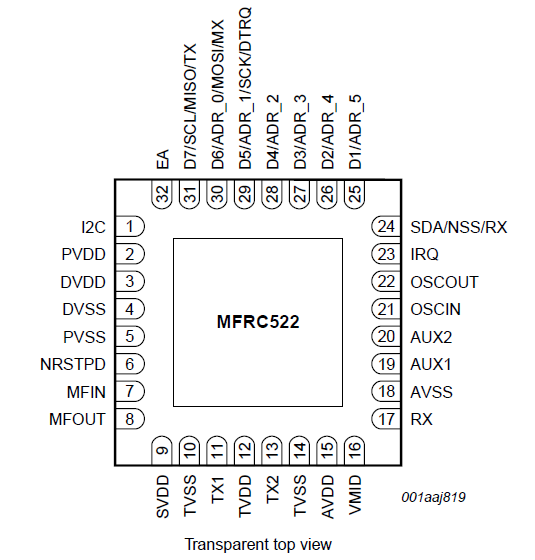
Bilder/MFRC522.png
