valeb/Projekt/Bilder/P70N04_Transfer.png

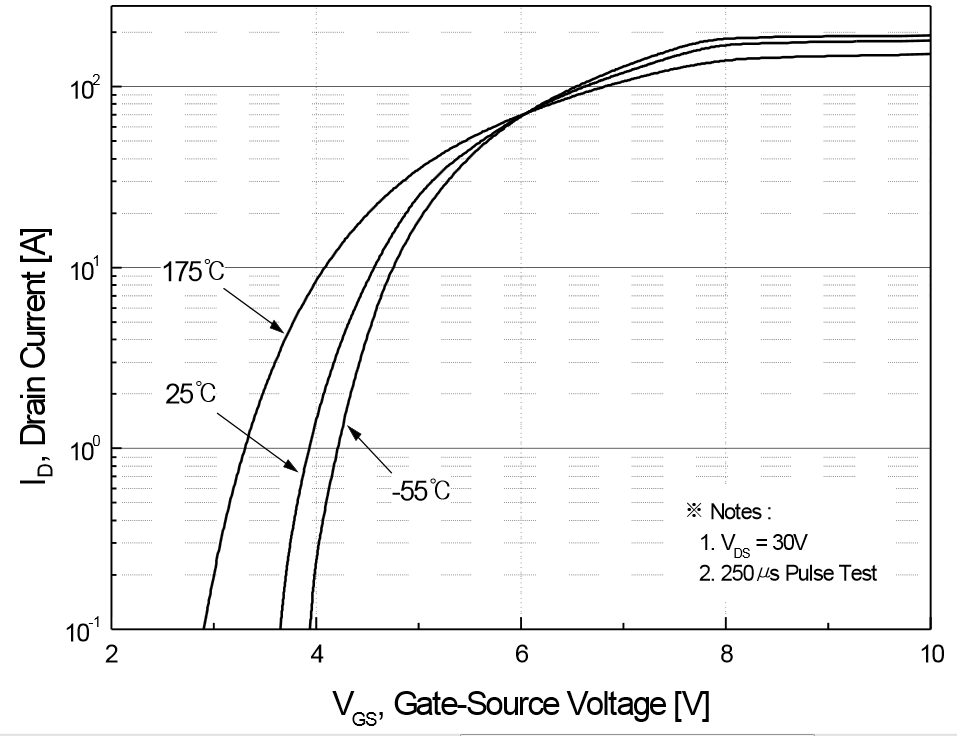
Bilder/P70N04_Transfer.png
