valeb/Projekt/Bilder/PIR.JPG

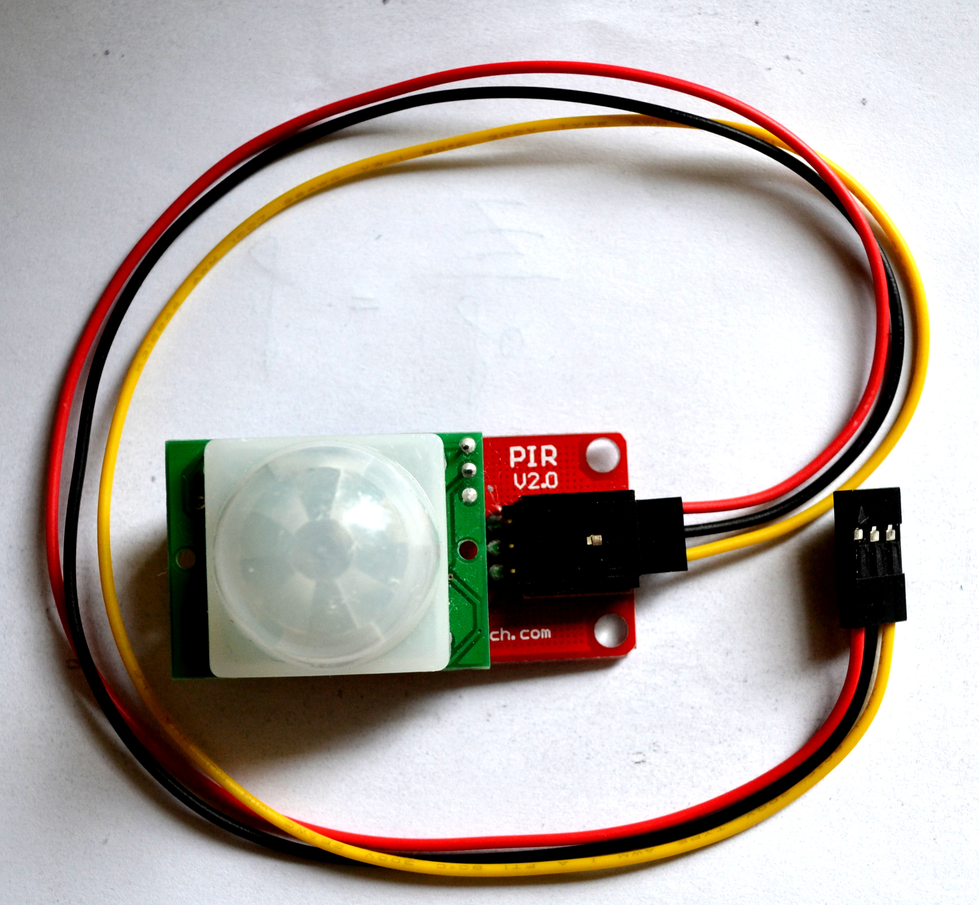
Bilder/PIR.JPG
