valeb/Projekt/Bilder/Schaltung_Audio.png

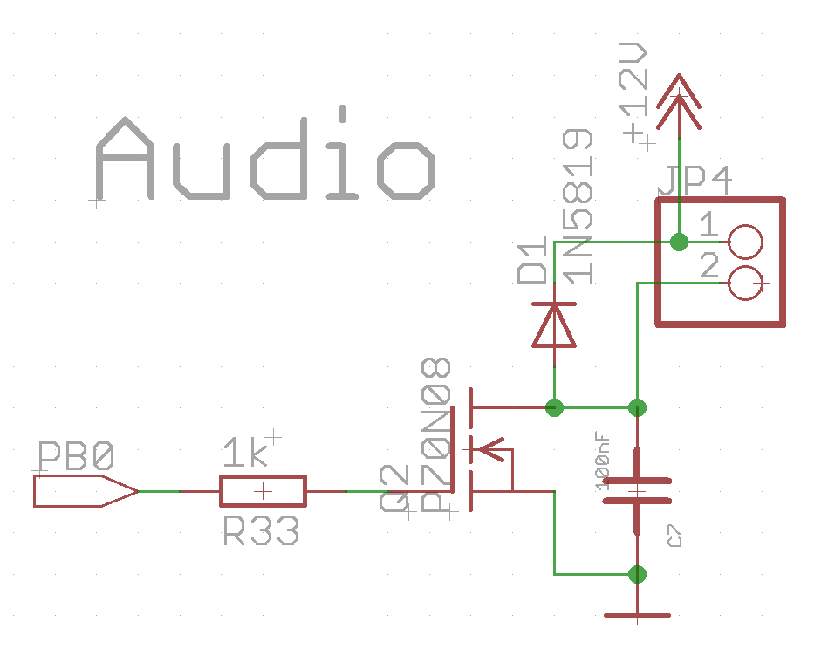
Bilder/Schaltung_Audio.png
