valeb/Projekt/Bilder/Schaltung_Controller.png

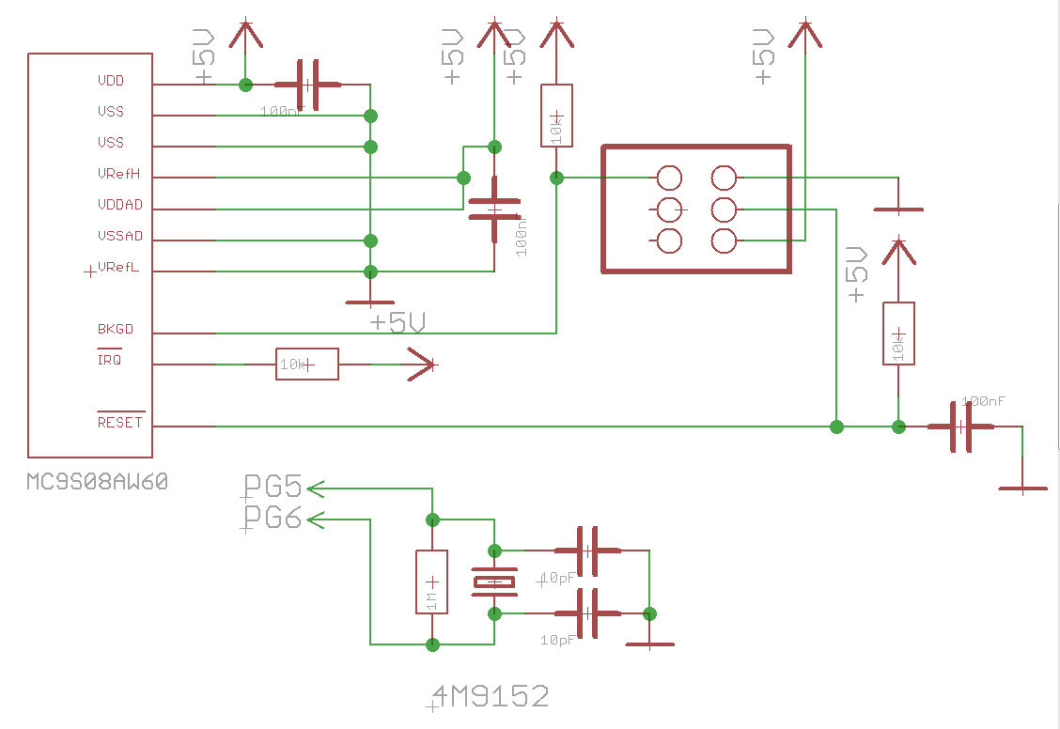
Bilder/Schaltung_Controller.png
