valeb/Projekt/Bilder/Schaltung_LCD.png

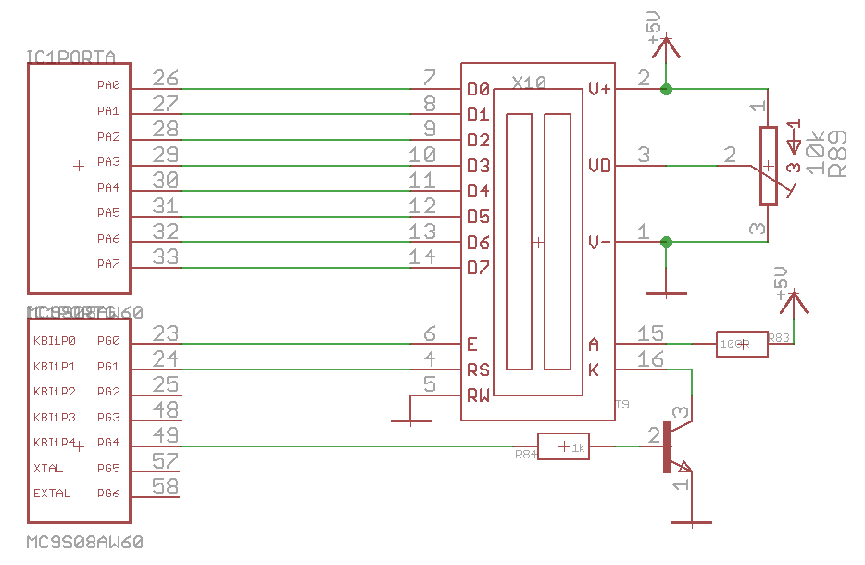
Bilder/Schaltung_LCD.png
