valeb/Projekt/Bilder/Schaltung_PIR.png

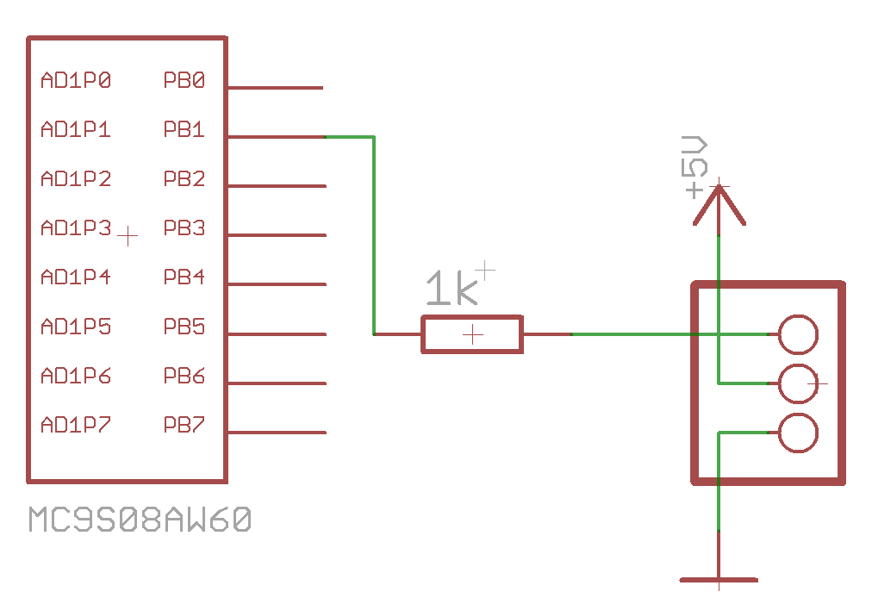
Bilder/Schaltung_PIR.png
