valeb/Projekt/Bilder/Schaltung_RFID.png

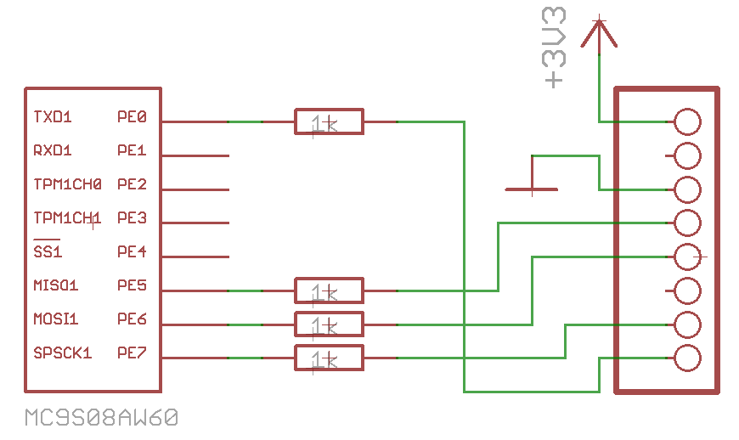
Bilder/Schaltung_RFID.png
