valeb/Projekt/Bilder/Schaltung_Taster.png

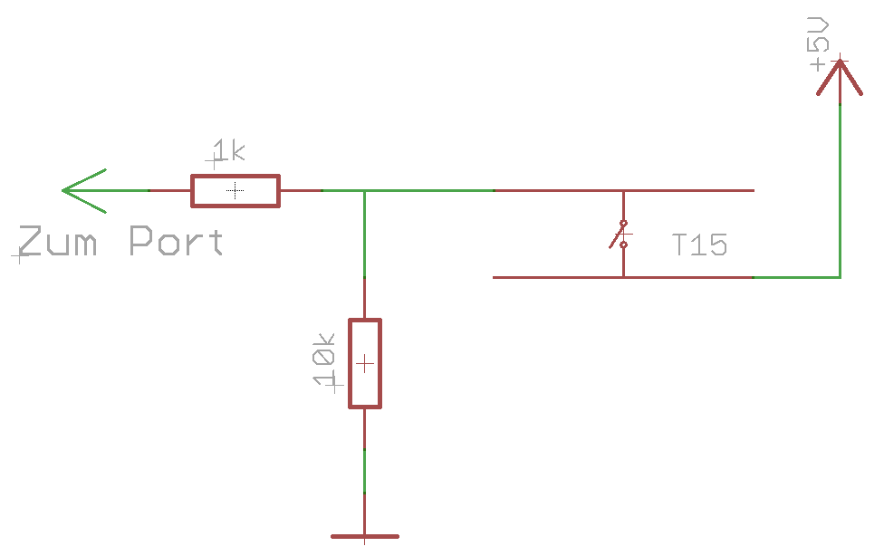
Bilder/Schaltung_Taster.png
