valeb/Projekt/Bilder/Schaltung_Versorgung.png

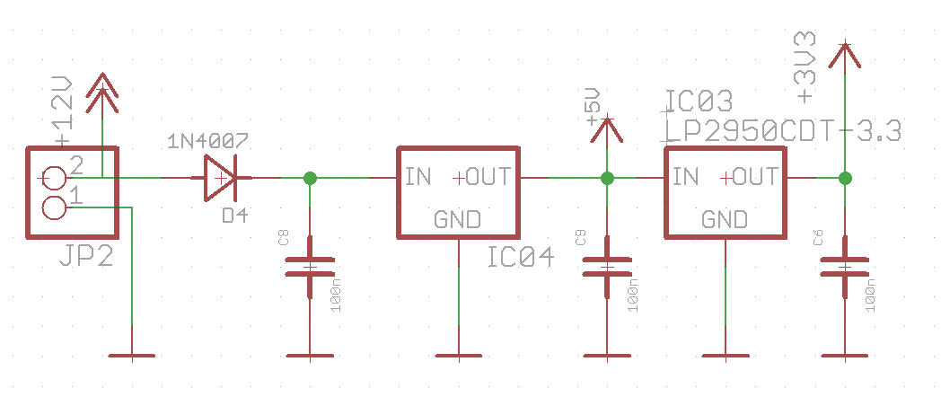
Bilder/Schaltung_Versorgung.png
