valeb/Projekt/Dokumentation/Bauteilliste.ods

Bauteilkosten
 |  |  |  |  |  |  |  |  |  |  | Entwicklungskosten |  | Amortisierung
 |  |  |  |  | Preis
Bauteil | Anz. | Beschreibung | Package | Bezugsquelle 1 | Einzelpreis | Prototyp | 1000er-Serie | Stückpreis | Bezugsquelle 2 |  | Arbeitsstunden | 163 | Verkaufspreis | 60,00 €
R100 | 1 | Widerstand 100Ω | SMD 0805 | farnell.com | 0,041 € | 0,04 € | 21,00 € | 0,021 € | distrelec.it | 0,021 € | Stundenlohn | 25,00 € | gesamte Stückkosten | 31,706 €
R1k-Traditionell | 1 | Widerstand 1kΩ | Traditionell | farnell.com | 0,019 € | 0,02 € | 8,00 € | 0,008 € | distrelec.it | 0,008 € | Lohnkosten | 4.075,00 € | Gewinn | 28,29 €
R1k | 24 | Widerstand 1kΩ | SMD 0805 | farnell.com | 0,041 € | 0,98 € | 456,00 € | 0,019 € | distrelec.it | 0,456 € |  |  | Amortisierung ab (Stück): | 153
R10k | 16 | Widerstand 10kΩ | SMD 0805 | farnell.com | 0,056 € | 0,90 € | 272,00 € | 0,017 € | distrelec.it | 0,272 €
R1M | 1 | Widerstand 1MΩ | SMD 0805 | farnell.com | 0,044 € | 0,04 € | 13,00 € | 0,013 € | distrelec.it | 0,013 € | Platinenkosten
Poti-10k | 1 | Potentiometer 10kΩ | S63X | farnell.com | 1,190 € | 1,19 € | 510,00 € | 0,510 € | distrelec.it | 0,510 €
C10p | 2 | Kondensator 10pF | SMD 0805 | farnell.com | 0,041 € | 0,08 € | 64,00 € | 0,032 € | distrelec.it | 0,064 € | Platinenfläche in cm² | 85,693377
C100n | 7 | Kondensator 100nF | SMD 0805 | farnell.com | 0,100 € | 0,70 € | 350,00 € | 0,050 € | distrelec.it | 0,350 € | Fixkosten | 200,00 €
1N4007 | 1 | Diode | Traditionell | farnell.com | 0,188 € | 0,19 € | 100,00 € | 0,100 € | distrelec.it | 0,100 € | Kosten/cm² Prototyp | 0,04 €
1N5819 | 1 | Diode | Traditionell | farnell.com | 0,141 € | 0,14 € | 101,00 € | 0,101 € | distrelec.it | 0,101 € | Gesamtkosten Prototyp | 203,43 €
78S05CV | 1 | 5V Regler | TO220 | farnell.com | 0,760 € | 0,76 € | 290,00 € | 0,290 € | distrelec.it | 0,290 € | Kosten/cm² 1000 Stück | 0,02 €
LM1117 | 1 | 3,3V Regler | SMD | farnell.com | 1,120 € | 1,12 € | 600,00 € | 0,600 € | distrelec.it | 0,600 € | Gesamtkosten 1000 Stück | 1.913,87 €
LED rot | 1 | Leuchtdiode | Traditionell 3mm | farnell.com | 0,310 € | 0,31 € | 158,00 € | 0,158 € | distrelec.it | 0,158 € | Stückkosten bei 1000 | 1,91 €
LED grün | 1 | Leuchtdiode | Traditionell 3mm | farnell.com | 1,310 € | 1,31 € | 1.158,00 € | 1,158 € | distrelec.it | 1,158 €
FSM2JH | 13 | Taster | Traditionell | farnell.com | 0,166 € | 2,16 € | 728,00 € | 0,056 € | distrelec.it | 0,728 €
1-826629-6 | 2 | Stiftleisten 16 Pin 2,54mm | Traditionell | farnell.com | 1,550 € | 3,10 € | 2.040,00 € | 1,02 € | distrelec.it | 2,040 €
BC817-40 6CW | 1 | NPN Transistor | SMD | farnell.com | 0,189 € | 0,19 € | 34,00 € | 0,034 € | distrelec.it | 0,034 €
P60N06 | 1 | MosFet | TO220 | farnell.com | 2,310 € | 2,31 € | 719,00 € | 0,719 € | distrelec.it | 0,719 €
49USMX, 4,9152MHz | 1 | 4,9152MHz Quarz | SMD | farnell.com | 2,510 € | 2,51 € | 1.906,25 € | 1,220 € | distrelec.it | 1,220 €
MC9S08AW60 | 1 | Mikrocontroller | 64-Pin QFP/LQFP | farnell.com | 4,450 € | 4,45 € | 2.750,00 € | 2,750 € | distrelec.it | 2,750 €
n.a. | 1 | LCD-Display | n.a | Prof. Detomaso | 3,500 € | 3,50 € | 3.500,00 € | 3,500 € | n.a. | 3,500 €
BOT-06643 | 1 | PIR-Sensor | n.a | myarduinoshop.com | 7,200 € | 7,20 € | 7.200,00 € | 7,200 € | geeetech.com | 7,200 €
SanSmart | 1 | RFID-Lesegerät | n.a | electrodragon.com | 7,500 € | 7,50 € | 7.500,00 € | 7,500 € | sainsmart.com | 7,500 €
 |  |  |  |  | Prototyp: | 40,70 € | Stückpreis: | 29,792 €
