valeb/Projekt/Hülle_Bernard/HБlle_Bernard.stl

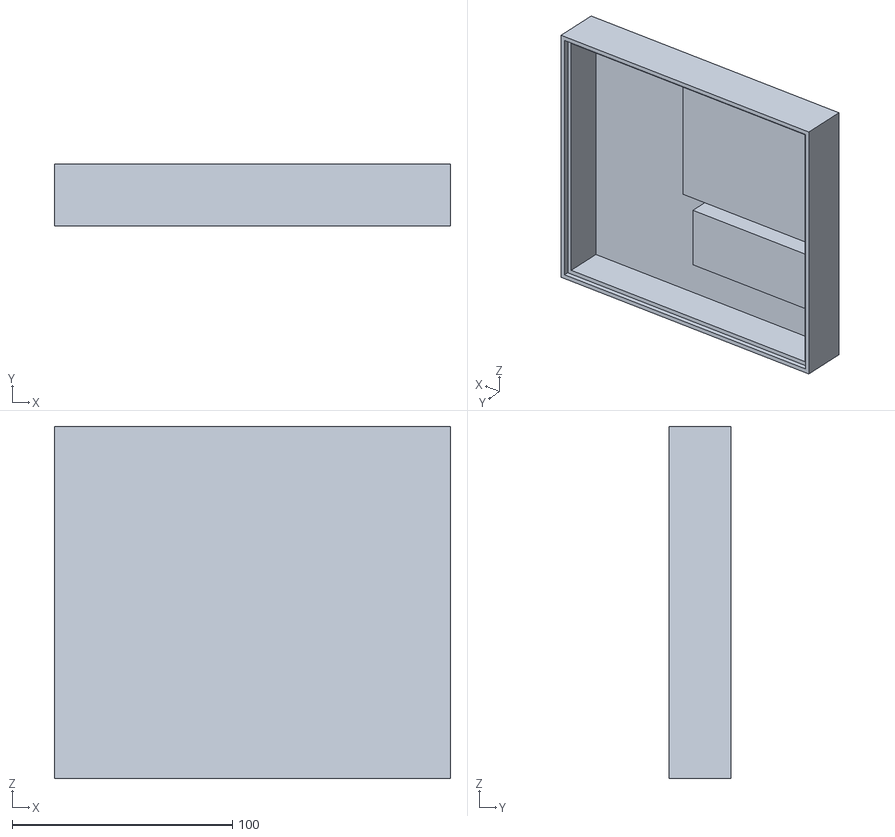
[picture p43: CAD file, 2014-04-27]
Hülle_Bernard/HБlle_Bernard.stl
180.0 x 28.0 x 160.0
