valeb/Projekt/Hülle_Bernard/AdlerSTL.stl

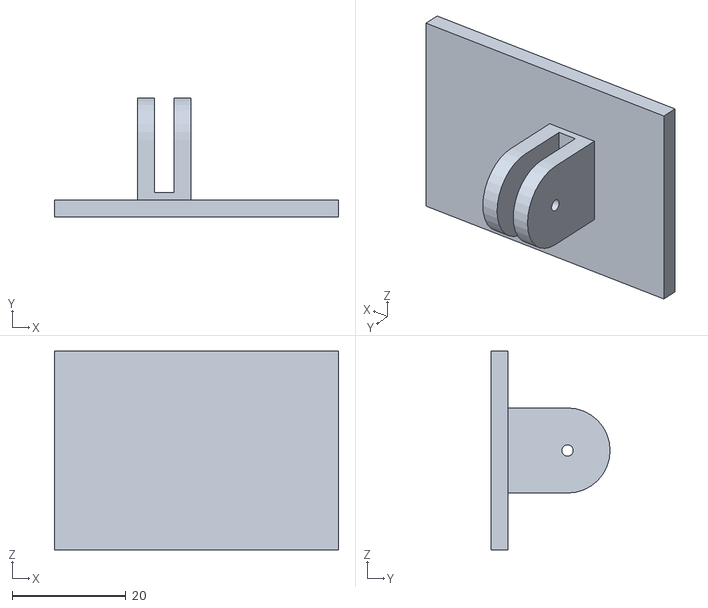
[picture p44: CAD file, 2014-04-27]
Hülle_Bernard/AdlerSTL.stl
50.0 x 21.0 x 35.0
