valeb/Projekt/Hülle_Bernard/Deckel_Bernard.stl

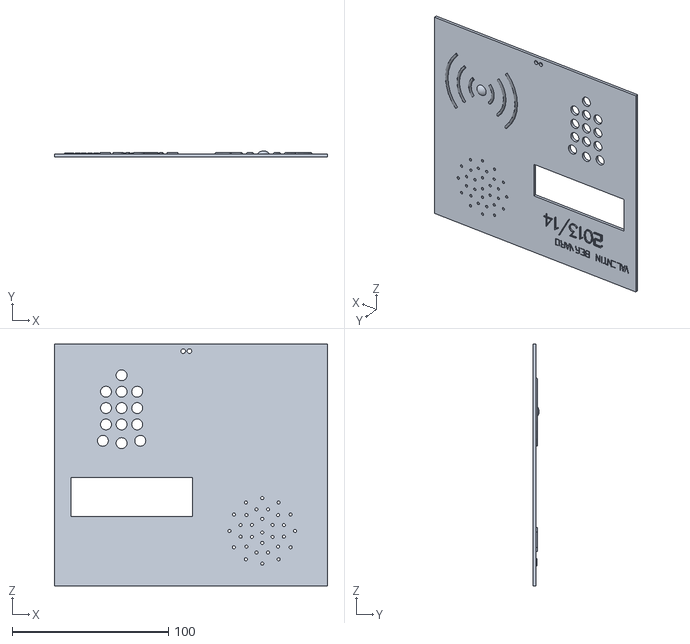
[picture p45: CAD file, 2014-04-27]
Hülle_Bernard/Deckel_Bernard.stl
175.0 x 4.00 x 155.0
