valeb/Projekt/Hülle_Bernard/Deckel.fcstd

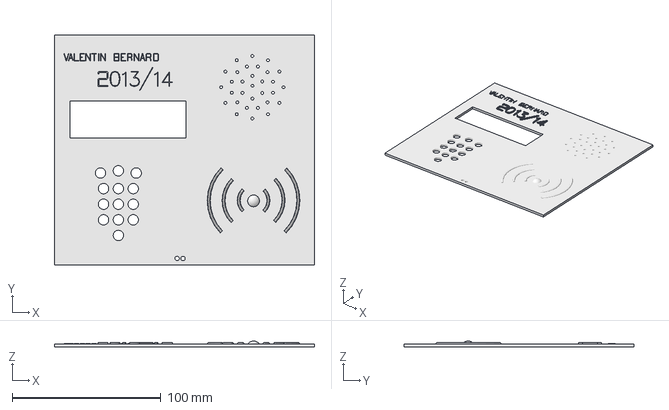
[picture p46: CAD file, 2014-04-27]
Hülle_Bernard/Deckel.fcstd
175.0 x 155.0 x 4.00 mm
