valeb/Projekt/(list of files, cad)

Other CAD files:
Datenblätter/RFID-MC522/Ú¦¦ÕÁîþöÁÕ¡ÉÕ¦äÚóæµ¿íÕØùÞÁäµûÖ/MFRC522_STC_NO12864/program_no12864/make/main.obj
Datenblätter/RFID-MC522/Ú¦¦ÕÁîþöÁÕ¡ÉÕ¦äÚóæµ¿íÕØùÞÁäµûÖ/MFRC522_STC_NO12864/program_no12864/make/key.obj
Datenblätter/RFID-MC522/Ú¦¦ÕÁîþöÁÕ¡ÉÕ¦äÚóæµ¿íÕØùÞÁäµûÖ/MFRC522_STC_NO12864/program_no12864/make/rc522.obj
Datenblätter/RFID-MC522/Ú¦¦ÕÁîþöÁÕ¡ÉÕ¦äÚóæµ¿íÕØùÞÁäµûÖ/MFRC522_STC_NO12864/program_no12864/make/STARTUP.OBJ
Hülle_Bernard/Huelle_Bernard_2.stl
Hülle_Bernard/Deckel_Bernard_2.stl
Codewarrior/Testsoftware/RFID-MC522 - Kopie/Ú¦¦ÕÁîþöÁÕ¡ÉÕ¦äÚóæµ¿íÕØùÞÁäµûÖ/MFRC522_STC_NO12864/program_no12864/make/main.obj
Codewarrior/Testsoftware/RFID-MC522 - Kopie/Ú¦¦ÕÁîþöÁÕ¡ÉÕ¦äÚóæµ¿íÕØùÞÁäµûÖ/MFRC522_STC_NO12864/program_no12864/make/STARTUP.OBJ
Codewarrior/Testsoftware/RFID-MC522 - Kopie/Ú¦¦ÕÁîþöÁÕ¡ÉÕ¦äÚóæµ¿íÕØùÞÁäµûÖ/MFRC522_STC_NO12864/program_no12864/make/rc522.obj
Codewarrior/Testsoftware/RFID-MC522 - Kopie/Ú¦¦ÕÁîþöÁÕ¡ÉÕ¦äÚóæµ¿íÕØùÞÁäµûÖ/MFRC522_STC_NO12864/program_no12864/make/key.obj
