valeb/Projekt/Datenblätter/RFID-MC522/Ú¦¦ÕÁîþöÁÕ¡ÉÕ¦äÚóæµ¿íÕØùÞÁäµûÖ/RC522_STM32/PDA_Test_RC522/user/PDA_Test_RC522.htm

# Static Call Graph for image H:\RC522_STM32\PDA_Test_RC522\user\PDA_Test_RC522.axf

#<CALLGRAPH># ARM Linker, 4.1 [Build 481]: Last Updated: Wed Oct 03 11:46:39 2012

### Maximum Stack Usage = 176 bytes + Unknown(Functions without stacksize, Cycles, Untraceable Function Pointers)

### Call chain for Maximum Stack Depth:

__rt_entry_main ⇒ main ⇒ ctrlprocess ⇒ PcdAnticoll ⇒ PcdComMF522 ⇒ ClearBitMask ⇒ WriteRawRC ⇒ SPIWriteByte

### Functions with no stack information

- __user_initial_stackheap

### Mutually Recursive functions

- NMI_Handler ⇒ NMI_Handler
- HardFault_Handler ⇒ HardFault_Handler
- MemManage_Handler ⇒ MemManage_Handler
- BusFault_Handler ⇒ BusFault_Handler
- UsageFault_Handler ⇒ UsageFault_Handler
- SVC_Handler ⇒ SVC_Handler
- DebugMon_Handler ⇒ DebugMon_Handler
- PendSV_Handler ⇒ PendSV_Handler
- SysTick_Handler ⇒ SysTick_Handler
- ADC_IRQHandler ⇒ ADC_IRQHandler

### Function Pointers

- Reset_Handler from stm32f10x.o(.text) referenced from stm32f10x.o(RESET)
- NMI_Handler from stm32f10x.o(.text) referenced from stm32f10x.o(RESET)
- HardFault_Handler from stm32f10x.o(.text) referenced from stm32f10x.o(RESET)
- MemManage_Handler from stm32f10x.o(.text) referenced from stm32f10x.o(RESET)
- BusFault_Handler from stm32f10x.o(.text) referenced from stm32f10x.o(RESET)
- UsageFault_Handler from stm32f10x.o(.text) referenced from stm32f10x.o(RESET)
- SVC_Handler from stm32f10x.o(.text) referenced from stm32f10x.o(RESET)
- DebugMon_Handler from stm32f10x.o(.text) referenced from stm32f10x.o(RESET)
- PendSV_Handler from stm32f10x.o(.text) referenced from stm32f10x.o(RESET)
- SysTick_Handler from stm32f10x.o(.text) referenced from stm32f10x.o(RESET)
- WWDG_IRQHandler from stm32f10x.o(.text) referenced from stm32f10x.o(RESET)
- PVD_IRQHandler from stm32f10x.o(.text) referenced from stm32f10x.o(RESET)
- TAMPER_IRQHandler from stm32f10x.o(.text) referenced from stm32f10x.o(RESET)
- RTC_IRQHandler from stm32f10x.o(.text) referenced from stm32f10x.o(RESET)
- FLASH_IRQHandler from stm32f10x.o(.text) referenced from stm32f10x.o(RESET)
- RCC_IRQHandler from stm32f10x.o(.text) referenced from stm32f10x.o(RESET)
- EXTI0_IRQHandler from stm32f10x.o(.text) referenced from stm32f10x.o(RESET)
- EXTI1_IRQHandler from stm32f10x.o(.text) referenced from stm32f10x.o(RESET)
- EXTI2_IRQHandler from stm32f10x.o(.text) referenced from stm32f10x.o(RESET)
- EXTI3_IRQHandler from stm32f10x.o(.text) referenced from stm32f10x.o(RESET)
- EXTI4_IRQHandler from stm32f10x.o(.text) referenced from stm32f10x.o(RESET)
- DMAChannel1_IRQHandler from stm32f10x.o(.text) referenced from stm32f10x.o(RESET)
- DMAChannel2_IRQHandler from stm32f10x.o(.text) referenced from stm32f10x.o(RESET)
- DMAChannel3_IRQHandler from stm32f10x.o(.text) referenced from stm32f10x.o(RESET)
- DMAChannel4_IRQHandler from stm32f10x.o(.text) referenced from stm32f10x.o(RESET)
- DMAChannel5_IRQHandler from stm32f10x.o(.text) referenced from stm32f10x.o(RESET)
- DMAChannel6_IRQHandler from stm32f10x.o(.text) referenced from stm32f10x.o(RESET)
- DMAChannel7_IRQHandler from stm32f10x.o(.text) referenced from stm32f10x.o(RESET)
- ADC_IRQHandler from stm32f10x.o(.text) referenced from stm32f10x.o(RESET)
- USB_HP_CAN_TX_IRQHandler from stm32f10x.o(.text) referenced from stm32f10x.o(RESET)
- USB_LP_CAN_RX0_IRQHandler from stm32f10x.o(.text) referenced from stm32f10x.o(RESET)
- CAN_RX1_IRQHandler from stm32f10x.o(.text) referenced from stm32f10x.o(RESET)
- CAN_SCE_IRQHandler from stm32f10x.o(.text) referenced from stm32f10x.o(RESET)
- EXTI9_5_IRQHandler from stm32f10x.o(.text) referenced from stm32f10x.o(RESET)
- TIM1_BRK_IRQHandler from stm32f10x.o(.text) referenced from stm32f10x.o(RESET)
- TIM1_UP_IRQHandler from stm32f10x.o(.text) referenced from stm32f10x.o(RESET)
- TIM1_TRG_COM_IRQHandler from stm32f10x.o(.text) referenced from stm32f10x.o(RESET)
- TIM1_CC_IRQHandler from stm32f10x.o(.text) referenced from stm32f10x.o(RESET)
- TIM2_IRQHandler from stm32f10x.o(.text) referenced from stm32f10x.o(RESET)
- TIM3_IRQHandler from stm32f10x.o(.text) referenced from stm32f10x.o(RESET)
- TIM4_IRQHandler from stm32f10x.o(.text) referenced from stm32f10x.o(RESET)
- I2C1_EV_IRQHandler from stm32f10x.o(.text) referenced from stm32f10x.o(RESET)
- I2C1_ER_IRQHandler from stm32f10x.o(.text) referenced from stm32f10x.o(RESET)
- I2C2_EV_IRQHandler from stm32f10x.o(.text) referenced from stm32f10x.o(RESET)
- I2C2_ER_IRQHandler from stm32f10x.o(.text) referenced from stm32f10x.o(RESET)
- SPI1_IRQHandler from stm32f10x.o(.text) referenced from stm32f10x.o(RESET)
- SPI2_IRQHandler from stm32f10x.o(.text) referenced from stm32f10x.o(RESET)
- USART1_IRQHandler from stm32f10x.o(.text) referenced from stm32f10x.o(RESET)
- USART2_IRQHandler from stm32f10x.o(.text) referenced from stm32f10x.o(RESET)
- USART3_IRQHandler from stm32f10x.o(.text) referenced from stm32f10x.o(RESET)
- EXTI15_10_IRQHandler from stm32f10x.o(.text) referenced from stm32f10x.o(RESET)
- RTCAlarm_IRQHandler from stm32f10x.o(.text) referenced from stm32f10x.o(RESET)
- USBWakeUp_IRQHandler from stm32f10x.o(.text) referenced from stm32f10x.o(RESET)
- __main from __main.o(!!!main) referenced from stm32f10x.o(.text)

### Global Symbols

__main (Thumb, 8 bytes, Stack size 0 bytes, __main.o(!!!main))

[Calls]

- >> __scatterload
- >> __rt_entry

__scatterload (Thumb, 0 bytes, Stack size unknown bytes, __scatter.o(!!!scatter))

[Called By]

- >> __main

__scatterload_rt2 (Thumb, 44 bytes, Stack size unknown bytes, __scatter.o(!!!scatter), UNUSED)

[Calls]

- >> __rt_entry

__scatterload_rt2_thumb_only (Thumb, 0 bytes, Stack size unknown bytes, __scatter.o(!!!scatter), UNUSED)

__scatterload_null (Thumb, 0 bytes, Stack size unknown bytes, __scatter.o(!!!scatter), UNUSED)

__scatterload_copy (Thumb, 26 bytes, Stack size unknown bytes, __scatter_copy.o(!!handler_copy), UNUSED)

[Calls]

- >> __scatterload_copy

[Called By]

- >> __scatterload_copy

__scatterload_zeroinit (Thumb, 28 bytes, Stack size unknown bytes, __scatter_zi.o(!!handler_zi), UNUSED)

__rt_lib_init (Thumb, 0 bytes, Stack size unknown bytes, libinit.o(.ARM.Collect$$libinit$$00000000))

[Stack]

- Max Depth = 8 + Unknown Stack Size
- Call Chain = __rt_lib_init ⇒ _fp_init

[Calls]

- >> _fp_init

[Called By]

- >> __rt_entry_li

__rt_lib_init_alloca_1 (Thumb, 0 bytes, Stack size unknown bytes, libinit2.o(.ARM.Collect$$libinit$$0000002A))

__rt_lib_init_argv_1 (Thumb, 0 bytes, Stack size unknown bytes, libinit2.o(.ARM.Collect$$libinit$$00000028))

__rt_lib_init_atexit_1 (Thumb, 0 bytes, Stack size unknown bytes, libinit2.o(.ARM.Collect$$libinit$$00000017))

__rt_lib_init_clock_1 (Thumb, 0 bytes, Stack size unknown bytes, libinit2.o(.ARM.Collect$$libinit$$0000001D))

__rt_lib_init_cpp_1 (Thumb, 0 bytes, Stack size unknown bytes, libinit2.o(.ARM.Collect$$libinit$$0000002E))

__rt_lib_init_exceptions_1 (Thumb, 0 bytes, Stack size unknown bytes, libinit2.o(.ARM.Collect$$libinit$$0000002C))

__rt_lib_init_fp_trap_1 (Thumb, 0 bytes, Stack size unknown bytes, libinit2.o(.ARM.Collect$$libinit$$0000001B))

__rt_lib_init_getenv_1 (Thumb, 0 bytes, Stack size unknown bytes, libinit2.o(.ARM.Collect$$libinit$$0000001F))

__rt_lib_init_heap_1 (Thumb, 0 bytes, Stack size unknown bytes, libinit2.o(.ARM.Collect$$libinit$$00000006))

__rt_lib_init_lc_collate_1 (Thumb, 0 bytes, Stack size unknown bytes, libinit2.o(.ARM.Collect$$libinit$$0000000D))

__rt_lib_init_lc_ctype_1 (Thumb, 0 bytes, Stack size unknown bytes, libinit2.o(.ARM.Collect$$libinit$$0000000F))

__rt_lib_init_lc_monetary_1 (Thumb, 0 bytes, Stack size unknown bytes, libinit2.o(.ARM.Collect$$libinit$$00000011))

__rt_lib_init_lc_numeric_1 (Thumb, 0 bytes, Stack size unknown bytes, libinit2.o(.ARM.Collect$$libinit$$00000013))

__rt_lib_init_lc_time_1 (Thumb, 0 bytes, Stack size unknown bytes, libinit2.o(.ARM.Collect$$libinit$$00000015))

__rt_lib_init_rand_1 (Thumb, 0 bytes, Stack size unknown bytes, libinit2.o(.ARM.Collect$$libinit$$0000000A))

__rt_lib_init_return (Thumb, 0 bytes, Stack size unknown bytes, libinit2.o(.ARM.Collect$$libinit$$0000002F))

__rt_lib_init_signal_1 (Thumb, 0 bytes, Stack size unknown bytes, libinit2.o(.ARM.Collect$$libinit$$00000019))

__rt_lib_init_stdio_1 (Thumb, 0 bytes, Stack size unknown bytes, libinit2.o(.ARM.Collect$$libinit$$00000021))

__rt_lib_init_user_alloc_1 (Thumb, 0 bytes, Stack size unknown bytes, libinit2.o(.ARM.Collect$$libinit$$00000008))

__rt_lib_shutdown (Thumb, 0 bytes, Stack size unknown bytes, libshutdown.o(.ARM.Collect$$libshutdown$$00000000))

[Called By]

- >> __rt_exit_ls

__rt_lib_shutdown_fp_trap_1 (Thumb, 0 bytes, Stack size unknown bytes, libshutdown2.o(.ARM.Collect$$libshutdown$$00000006))

__rt_lib_shutdown_heap_1 (Thumb, 0 bytes, Stack size unknown bytes, libshutdown2.o(.ARM.Collect$$libshutdown$$0000000E))

__rt_lib_shutdown_return (Thumb, 0 bytes, Stack size unknown bytes, libshutdown2.o(.ARM.Collect$$libshutdown$$0000000F))

__rt_lib_shutdown_signal_1 (Thumb, 0 bytes, Stack size unknown bytes, libshutdown2.o(.ARM.Collect$$libshutdown$$00000009))

__rt_lib_shutdown_stdio_1 (Thumb, 0 bytes, Stack size unknown bytes, libshutdown2.o(.ARM.Collect$$libshutdown$$00000003))

__rt_lib_shutdown_user_alloc_1 (Thumb, 0 bytes, Stack size unknown bytes, libshutdown2.o(.ARM.Collect$$libshutdown$$0000000B))

__rt_entry (Thumb, 0 bytes, Stack size unknown bytes, rtentry.o(.ARM.Collect$$rtentry$$00000000))

[Called By]

- >> __scatterload_rt2
- >> __main

__rt_entry_presh_1 (Thumb, 0 bytes, Stack size unknown bytes, rtentry2.o(.ARM.Collect$$rtentry$$00000002))

__rt_entry_sh (Thumb, 0 bytes, Stack size unknown bytes, rtentry4.o(.ARM.Collect$$rtentry$$00000004))

[Stack]

- Max Depth = 8 + Unknown Stack Size
- Call Chain = __rt_entry_sh ⇒ __user_setup_stackheap

[Calls]

- >> __user_setup_stackheap

__rt_entry_li (Thumb, 0 bytes, Stack size unknown bytes, rtentry2.o(.ARM.Collect$$rtentry$$0000000A))

[Stack]

- Max Depth = 8 + Unknown Stack Size
- Call Chain = __rt_entry_li ⇒ __rt_lib_init ⇒ _fp_init

[Calls]

- >> __rt_lib_init

__rt_entry_postsh_1 (Thumb, 0 bytes, Stack size unknown bytes, rtentry2.o(.ARM.Collect$$rtentry$$00000009))

__rt_entry_main (Thumb, 0 bytes, Stack size unknown bytes, rtentry2.o(.ARM.Collect$$rtentry$$0000000D))

[Stack]

- Max Depth = 176 + Unknown Stack Size
- Call Chain = __rt_entry_main ⇒ main ⇒ ctrlprocess ⇒ PcdAnticoll ⇒ PcdComMF522 ⇒ ClearBitMask ⇒ WriteRawRC ⇒ SPIWriteByte

[Calls]

- >> exit
- >> main

__rt_entry_postli_1 (Thumb, 0 bytes, Stack size unknown bytes, rtentry2.o(.ARM.Collect$$rtentry$$0000000C))

__rt_exit (Thumb, 0 bytes, Stack size unknown bytes, rtexit.o(.ARM.Collect$$rtexit$$00000000))

[Called By]

- >> exit

__rt_exit_ls (Thumb, 0 bytes, Stack size unknown bytes, rtexit2.o(.ARM.Collect$$rtexit$$00000003))

[Calls]

- >> __rt_lib_shutdown

__rt_exit_prels_1 (Thumb, 0 bytes, Stack size unknown bytes, rtexit2.o(.ARM.Collect$$rtexit$$00000002))

__rt_exit_exit (Thumb, 0 bytes, Stack size unknown bytes, rtexit2.o(.ARM.Collect$$rtexit$$00000004))

[Calls]

- >> _sys_exit

Reset_Handler (Thumb, 4 bytes, Stack size 0 bytes, stm32f10x.o(.text))

NMI_Handler (Thumb, 2 bytes, Stack size 0 bytes, stm32f10x.o(.text))

[Calls]

- >> NMI_Handler

[Called By]

- >> NMI_Handler

[Address Reference Count : 1]

- stm32f10x.o(RESET)

HardFault_Handler (Thumb, 2 bytes, Stack size 0 bytes, stm32f10x.o(.text))

[Calls]

- >> HardFault_Handler

[Called By]

- >> HardFault_Handler

[Address Reference Count : 1]

- stm32f10x.o(RESET)

MemManage_Handler (Thumb, 2 bytes, Stack size 0 bytes, stm32f10x.o(.text))

[Calls]

- >> MemManage_Handler

[Called By]

- >> MemManage_Handler

[Address Reference Count : 1]

- stm32f10x.o(RESET)

BusFault_Handler (Thumb, 2 bytes, Stack size 0 bytes, stm32f10x.o(.text))

[Calls]

- >> BusFault_Handler

[Called By]

- >> BusFault_Handler

[Address Reference Count : 1]

- stm32f10x.o(RESET)

UsageFault_Handler (Thumb, 2 bytes, Stack size 0 bytes, stm32f10x.o(.text))

[Calls]

- >> UsageFault_Handler

[Called By]

- >> UsageFault_Handler

[Address Reference Count : 1]

- stm32f10x.o(RESET)

SVC_Handler (Thumb, 2 bytes, Stack size 0 bytes, stm32f10x.o(.text))

[Calls]

- >> SVC_Handler

[Called By]

- >> SVC_Handler

[Address Reference Count : 1]

- stm32f10x.o(RESET)

DebugMon_Handler (Thumb, 2 bytes, Stack size 0 bytes, stm32f10x.o(.text))

[Calls]

- >> DebugMon_Handler

[Called By]

- >> DebugMon_Handler

[Address Reference Count : 1]

- stm32f10x.o(RESET)

PendSV_Handler (Thumb, 2 bytes, Stack size 0 bytes, stm32f10x.o(.text))

[Calls]

- >> PendSV_Handler

[Called By]

- >> PendSV_Handler

[Address Reference Count : 1]

- stm32f10x.o(RESET)

SysTick_Handler (Thumb, 2 bytes, Stack size 0 bytes, stm32f10x.o(.text))

[Calls]

- >> SysTick_Handler

[Called By]

- >> SysTick_Handler

[Address Reference Count : 1]

- stm32f10x.o(RESET)

ADC_IRQHandler (Thumb, 0 bytes, Stack size 0 bytes, stm32f10x.o(.text))

[Calls]

- >> ADC_IRQHandler

[Called By]

- >> ADC_IRQHandler

[Address Reference Count : 1]

- stm32f10x.o(RESET)

CAN_RX1_IRQHandler (Thumb, 0 bytes, Stack size 0 bytes, stm32f10x.o(.text))
[Address Reference Count : 1]

- stm32f10x.o(RESET)

CAN_SCE_IRQHandler (Thumb, 0 bytes, Stack size 0 bytes, stm32f10x.o(.text))
[Address Reference Count : 1]

- stm32f10x.o(RESET)

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

- stm32f10x.o(RESET)

TIM4_IRQHandler (Thumb, 0 bytes, Stack size 0 bytes, stm32f10x.o(.text))
[Address Reference Count : 1]

- stm32f10x.o(RESET)

USART1_IRQHandler (Thumb, 0 bytes, Stack size 0 bytes, stm32f10x.o(.text))
[Address Reference Count : 1]

- stm32f10x.o(RESET)

USART2_IRQHandler (Thumb, 0 bytes, Stack size 0 bytes, stm32f10x.o(.text))
[Address Reference Count : 1]

- stm32f10x.o(RESET)

USART3_IRQHandler (Thumb, 0 bytes, Stack size 0 bytes, stm32f10x.o(.text))
[Address Reference Count : 1]

- stm32f10x.o(RESET)

USBWakeUp_IRQHandler (Thumb, 0 bytes, Stack size 0 bytes, stm32f10x.o(.text))
[Address Reference Count : 1]

- stm32f10x.o(RESET)

USB_HP_CAN_TX_IRQHandler (Thumb, 0 bytes, Stack size 0 bytes, stm32f10x.o(.text))
[Address Reference Count : 1]

- stm32f10x.o(RESET)

USB_LP_CAN_RX0_IRQHandler (Thumb, 0 bytes, Stack size 0 bytes, stm32f10x.o(.text))
[Address Reference Count : 1]

- stm32f10x.o(RESET)

WWDG_IRQHandler (Thumb, 0 bytes, Stack size 0 bytes, stm32f10x.o(.text))
[Address Reference Count : 1]

- stm32f10x.o(RESET)

__user_initial_stackheap (Thumb, 0 bytes, Stack size unknown bytes, stm32f10x.o(.text))

[Called By]

- >> __user_setup_stackheap

NVIC_PriorityGroupConfig (Thumb, 10 bytes, Stack size 0 bytes, main.o(.text), UNUSED)

NVIC_Init (Thumb, 92 bytes, Stack size 16 bytes, main.o(.text), UNUSED)

NVIC_SetVectorTable (Thumb, 12 bytes, Stack size 0 bytes, main.o(.text), UNUSED)

NVIC_SystemLPConfig (Thumb, 24 bytes, Stack size 0 bytes, main.o(.text), UNUSED)

SysTick_CLKSourceConfig (Thumb, 24 bytes, Stack size 0 bytes, main.o(.text), UNUSED)

RCC_DeInit (Thumb, 50 bytes, Stack size 0 bytes, main.o(.text), UNUSED)

[Called By]

- >> RCC_Configuration

RCC_HSEConfig (Thumb, 48 bytes, Stack size 0 bytes, main.o(.text), UNUSED)

RCC_GetFlagStatus (Thumb, 42 bytes, Stack size 0 bytes, main.o(.text), UNUSED)

[Called By]

- >> RCC_Configuration
- >> RCC_WaitForHSEStartUp

RCC_WaitForHSEStartUp (Thumb, 38 bytes, Stack size 12 bytes, main.o(.text), UNUSED)

[Calls]

- >> RCC_GetFlagStatus

RCC_AdjustHSICalibrationValue (Thumb, 16 bytes, Stack size 0 bytes, main.o(.text), UNUSED)

RCC_HSICmd (Thumb, 6 bytes, Stack size 0 bytes, main.o(.text), UNUSED)

[Called By]

- >> RCC_Configuration

RCC_PLLConfig (Thumb, 16 bytes, Stack size 0 bytes, main.o(.text), UNUSED)

[Called By]

- >> RCC_Configuration

RCC_PLLCmd (Thumb, 6 bytes, Stack size 0 bytes, main.o(.text), UNUSED)

[Called By]

- >> RCC_Configuration

RCC_SYSCLKConfig (Thumb, 14 bytes, Stack size 0 bytes, main.o(.text), UNUSED)

[Called By]

- >> RCC_Configuration

RCC_GetSYSCLKSource (Thumb, 10 bytes, Stack size 0 bytes, main.o(.text), UNUSED)

[Called By]

- >> RCC_Configuration

RCC_HCLKConfig (Thumb, 14 bytes, Stack size 0 bytes, main.o(.text), UNUSED)

[Called By]

- >> RCC_Configuration

RCC_PCLK1Config (Thumb, 14 bytes, Stack size 0 bytes, main.o(.text), UNUSED)

[Called By]

- >> RCC_Configuration

RCC_PCLK2Config (Thumb, 16 bytes, Stack size 0 bytes, main.o(.text), UNUSED)

[Called By]

- >> RCC_Configuration

RCC_ITConfig (Thumb, 18 bytes, Stack size 0 bytes, main.o(.text), UNUSED)

RCC_USBCLKConfig (Thumb, 6 bytes, Stack size 0 bytes, main.o(.text), UNUSED)

RCC_ADCCLKConfig (Thumb, 14 bytes, Stack size 0 bytes, main.o(.text), UNUSED)

RCC_LSEConfig (Thumb, 26 bytes, Stack size 0 bytes, main.o(.text), UNUSED)

RCC_LSICmd (Thumb, 6 bytes, Stack size 0 bytes, main.o(.text), UNUSED)

RCC_RTCCLKConfig (Thumb, 10 bytes, Stack size 0 bytes, main.o(.text), UNUSED)

RCC_RTCCLKCmd (Thumb, 6 bytes, Stack size 0 bytes, main.o(.text), UNUSED)

RCC_GetClocksFreq (Thumb, 134 bytes, Stack size 8 bytes, main.o(.text), UNUSED)

RCC_AHBPeriphClockCmd (Thumb, 18 bytes, Stack size 0 bytes, main.o(.text), UNUSED)

RCC_APB2PeriphClockCmd (Thumb, 18 bytes, Stack size 0 bytes, main.o(.text))

[Called By]

- >> RC522_IO_Init

RCC_APB1PeriphClockCmd (Thumb, 18 bytes, Stack size 0 bytes, main.o(.text), UNUSED)

RCC_APB2PeriphResetCmd (Thumb, 18 bytes, Stack size 0 bytes, main.o(.text), UNUSED)

[Called By]

- >> TIM_DeInit
- >> GPIO_AFIODeInit
- >> GPIO_DeInit

RCC_APB1PeriphResetCmd (Thumb, 18 bytes, Stack size 0 bytes, main.o(.text), UNUSED)

[Called By]

- >> TIM_DeInit

RCC_BackupResetCmd (Thumb, 6 bytes, Stack size 0 bytes, main.o(.text), UNUSED)

RCC_ClockSecuritySystemCmd (Thumb, 6 bytes, Stack size 0 bytes, main.o(.text), UNUSED)

RCC_MCOConfig (Thumb, 6 bytes, Stack size 0 bytes, main.o(.text), UNUSED)

RCC_ClearFlag (Thumb, 12 bytes, Stack size 0 bytes, main.o(.text), UNUSED)

RCC_GetITStatus (Thumb, 16 bytes, Stack size 0 bytes, main.o(.text), UNUSED)

RCC_ClearITPendingBit (Thumb, 6 bytes, Stack size 0 bytes, main.o(.text), UNUSED)

GPIO_DeInit (Thumb, 150 bytes, Stack size 4 bytes, main.o(.text), UNUSED)

[Calls]

- >> RCC_APB2PeriphResetCmd

GPIO_AFIODeInit (Thumb, 20 bytes, Stack size 4 bytes, main.o(.text), UNUSED)

[Calls]

- >> RCC_APB2PeriphResetCmd

GPIO_Init (Thumb, 252 bytes, Stack size 20 bytes, main.o(.text))

[Stack]

- Max Depth = 20
- Call Chain = GPIO_Init

[Called By]

- >> RC522_IO_Init

GPIO_StructInit (Thumb, 16 bytes, Stack size 0 bytes, main.o(.text), UNUSED)

GPIO_ReadInputDataBit (Thumb, 14 bytes, Stack size 0 bytes, main.o(.text))

[Called By]

- >> SPIReadByte

GPIO_ReadInputData (Thumb, 6 bytes, Stack size 0 bytes, main.o(.text), UNUSED)

GPIO_ReadOutputDataBit (Thumb, 14 bytes, Stack size 0 bytes, main.o(.text), UNUSED)

GPIO_ReadOutputData (Thumb, 6 bytes, Stack size 0 bytes, main.o(.text), UNUSED)

GPIO_SetBits (Thumb, 4 bytes, Stack size 0 bytes, main.o(.text))

[Called By]

- >> PcdReset
- >> ReadRawRC
- >> SPIReadByte
- >> WriteRawRC
- >> SPIWriteByte

GPIO_ResetBits (Thumb, 4 bytes, Stack size 0 bytes, main.o(.text))

[Called By]

- >> PcdReset
- >> ReadRawRC
- >> SPIReadByte
- >> WriteRawRC
- >> SPIWriteByte

GPIO_WriteBit (Thumb, 10 bytes, Stack size 0 bytes, main.o(.text), UNUSED)

GPIO_Write (Thumb, 4 bytes, Stack size 0 bytes, main.o(.text), UNUSED)

GPIO_PinLockConfig (Thumb, 16 bytes, Stack size 0 bytes, main.o(.text), UNUSED)

GPIO_EventOutputConfig (Thumb, 22 bytes, Stack size 8 bytes, main.o(.text), UNUSED)

GPIO_EventOutputCmd (Thumb, 6 bytes, Stack size 0 bytes, main.o(.text), UNUSED)

GPIO_PinRemapConfig (Thumb, 82 bytes, Stack size 20 bytes, main.o(.text), UNUSED)

GPIO_EXTILineConfig (Thumb, 34 bytes, Stack size 8 bytes, main.o(.text), UNUSED)

GPIO_ETH_MediaInterfaceConfig (Thumb, 6 bytes, Stack size 0 bytes, main.o(.text), UNUSED)

FLASH_SetLatency (Thumb, 14 bytes, Stack size 0 bytes, main.o(.text), UNUSED)

[Called By]

- >> RCC_Configuration

FLASH_HalfCycleAccessCmd (Thumb, 18 bytes, Stack size 0 bytes, main.o(.text), UNUSED)

FLASH_PrefetchBufferCmd (Thumb, 18 bytes, Stack size 0 bytes, main.o(.text), UNUSED)

[Called By]

- >> RCC_Configuration

FLASH_Unlock (Thumb, 12 bytes, Stack size 0 bytes, main.o(.text), UNUSED)

FLASH_UnlockBank1 (Thumb, 12 bytes, Stack size 0 bytes, main.o(.text), UNUSED)

FLASH_Lock (Thumb, 12 bytes, Stack size 0 bytes, main.o(.text), UNUSED)

FLASH_LockBank1 (Thumb, 12 bytes, Stack size 0 bytes, main.o(.text), UNUSED)

FLASH_GetBank1Status (Thumb, 34 bytes, Stack size 0 bytes, main.o(.text), UNUSED)

[Called By]

- >> FLASH_WaitForLastBank1Operation
- >> FLASH_WaitForLastOperation

FLASH_WaitForLastOperation (Thumb, 34 bytes, Stack size 4 bytes, main.o(.text), UNUSED)

[Calls]

- >> FLASH_GetBank1Status

[Called By]

- >> FLASH_UserOptionByteConfig
- >> FLASH_ReadOutProtection
- >> FLASH_EnableWriteProtection
- >> FLASH_ProgramOptionByteData
- >> FLASH_ProgramHalfWord
- >> FLASH_ProgramWord
- >> FLASH_EraseOptionBytes
- >> FLASH_EraseAllPages
- >> FLASH_ErasePage

FLASH_ErasePage (Thumb, 56 bytes, Stack size 16 bytes, main.o(.text), UNUSED)

[Calls]

- >> FLASH_WaitForLastOperation

FLASH_EraseAllPages (Thumb, 52 bytes, Stack size 12 bytes, main.o(.text), UNUSED)

[Calls]

- >> FLASH_WaitForLastOperation

FLASH_WaitForLastBank1Operation (Thumb, 34 bytes, Stack size 4 bytes, main.o(.text), UNUSED)

[Calls]

- >> FLASH_GetBank1Status

[Called By]

- >> FLASH_EraseAllBank1Pages

FLASH_EraseAllBank1Pages (Thumb, 52 bytes, Stack size 12 bytes, main.o(.text), UNUSED)

[Calls]

- >> FLASH_WaitForLastBank1Operation

FLASH_GetReadOutProtectionStatus (Thumb, 14 bytes, Stack size 0 bytes, main.o(.text), UNUSED)

[Called By]

- >> FLASH_EraseOptionBytes

FLASH_EraseOptionBytes (Thumb, 108 bytes, Stack size 16 bytes, main.o(.text), UNUSED)

[Calls]

- >> FLASH_GetReadOutProtectionStatus
- >> FLASH_WaitForLastOperation

FLASH_ProgramWord (Thumb, 64 bytes, Stack size 20 bytes, main.o(.text), UNUSED)

[Calls]

- >> FLASH_WaitForLastOperation

FLASH_ProgramHalfWord (Thumb, 48 bytes, Stack size 20 bytes, main.o(.text), UNUSED)

[Calls]

- >> FLASH_WaitForLastOperation

FLASH_ProgramOptionByteData (Thumb, 62 bytes, Stack size 20 bytes, main.o(.text), UNUSED)

[Calls]

- >> FLASH_WaitForLastOperation

FLASH_EnableWriteProtection (Thumb, 154 bytes, Stack size 28 bytes, main.o(.text), UNUSED)

[Calls]

- >> FLASH_WaitForLastOperation

FLASH_ReadOutProtection (Thumb, 154 bytes, Stack size 16 bytes, main.o(.text), UNUSED)

[Calls]

- >> FLASH_WaitForLastOperation

FLASH_UserOptionByteConfig (Thumb, 74 bytes, Stack size 20 bytes, main.o(.text), UNUSED)

[Calls]

- >> FLASH_WaitForLastOperation

FLASH_GetUserOptionByte (Thumb, 8 bytes, Stack size 0 bytes, main.o(.text), UNUSED)

FLASH_GetWriteProtectionOptionByte (Thumb, 6 bytes, Stack size 0 bytes, main.o(.text), UNUSED)

FLASH_GetPrefetchBufferStatus (Thumb, 14 bytes, Stack size 0 bytes, main.o(.text), UNUSED)

FLASH_ITConfig (Thumb, 18 bytes, Stack size 0 bytes, main.o(.text), UNUSED)

FLASH_GetFlagStatus (Thumb, 28 bytes, Stack size 0 bytes, main.o(.text), UNUSED)

FLASH_ClearFlag (Thumb, 6 bytes, Stack size 0 bytes, main.o(.text), UNUSED)

FLASH_GetStatus (Thumb, 34 bytes, Stack size 0 bytes, main.o(.text), UNUSED)

TIM_DeInit (Thumb, 304 bytes, Stack size 4 bytes, main.o(.text), UNUSED)

[Calls]

- >> RCC_APB1PeriphResetCmd
- >> RCC_APB2PeriphResetCmd

TIM_TimeBaseInit (Thumb, 114 bytes, Stack size 12 bytes, main.o(.text), UNUSED)

TIM_OC1Init (Thumb, 106 bytes, Stack size 12 bytes, main.o(.text), UNUSED)

TIM_OC2Init (Thumb, 116 bytes, Stack size 12 bytes, main.o(.text), UNUSED)

TIM_OC3Init (Thumb, 112 bytes, Stack size 12 bytes, main.o(.text), UNUSED)

TIM_OC4Init (Thumb, 174 bytes, Stack size 12 bytes, main.o(.text), UNUSED)

TIM_SetIC4Prescaler (Thumb, 18 bytes, Stack size 0 bytes, main.o(.text), UNUSED)

[Called By]

- >> TIM_ICInit

TIM_SetIC3Prescaler (Thumb, 16 bytes, Stack size 0 bytes, main.o(.text), UNUSED)

[Called By]

- >> TIM_ICInit

TIM_SetIC2Prescaler (Thumb, 18 bytes, Stack size 0 bytes, main.o(.text), UNUSED)

[Called By]

- >> TIM_PWMIConfig
- >> TIM_ICInit

TIM_SetIC1Prescaler (Thumb, 16 bytes, Stack size 0 bytes, main.o(.text), UNUSED)

[Called By]

- >> TIM_PWMIConfig
- >> TIM_ICInit

TIM_ICInit (Thumb, 268 bytes, Stack size 40 bytes, main.o(.text), UNUSED)

[Calls]

- >> TIM_SetIC1Prescaler
- >> TIM_SetIC2Prescaler
- >> TIM_SetIC3Prescaler
- >> TIM_SetIC4Prescaler
- >> TI1_Config
- >> TI2_Config

TIM_PWMIConfig (Thumb, 104 bytes, Stack size 24 bytes, main.o(.text), UNUSED)

[Calls]

- >> TIM_SetIC1Prescaler
- >> TIM_SetIC2Prescaler
- >> TI1_Config
- >> TI2_Config

TIM_BDTRConfig (Thumb, 34 bytes, Stack size 8 bytes, main.o(.text), UNUSED)

TIM_TimeBaseStructInit (Thumb, 18 bytes, Stack size 0 bytes, main.o(.text), UNUSED)

TIM_OCStructInit (Thumb, 20 bytes, Stack size 0 bytes, main.o(.text), UNUSED)

TIM_ICStructInit (Thumb, 16 bytes, Stack size 0 bytes, main.o(.text), UNUSED)

TIM_BDTRStructInit (Thumb, 18 bytes, Stack size 0 bytes, main.o(.text), UNUSED)

TIM_Cmd (Thumb, 20 bytes, Stack size 0 bytes, main.o(.text), UNUSED)

TIM_CtrlPWMOutputs (Thumb, 22 bytes, Stack size 0 bytes, main.o(.text), UNUSED)

TIM_ITConfig (Thumb, 16 bytes, Stack size 0 bytes, main.o(.text), UNUSED)

TIM_GenerateEvent (Thumb, 4 bytes, Stack size 0 bytes, main.o(.text), UNUSED)

TIM_DMAConfig (Thumb, 8 bytes, Stack size 0 bytes, main.o(.text), UNUSED)

TIM_DMACmd (Thumb, 16 bytes, Stack size 0 bytes, main.o(.text), UNUSED)

TIM_InternalClockConfig (Thumb, 10 bytes, Stack size 0 bytes, main.o(.text), UNUSED)

TIM_SelectInputTrigger (Thumb, 12 bytes, Stack size 0 bytes, main.o(.text), UNUSED)

TIM_ITRxExternalClockConfig (Thumb, 20 bytes, Stack size 0 bytes, main.o(.text), UNUSED)

TIM_TIxExternalClockConfig (Thumb, 46 bytes, Stack size 16 bytes, main.o(.text), UNUSED)

[Calls]

- >> TI1_Config
- >> TI2_Config

TIM_ETRConfig (Thumb, 18 bytes, Stack size 8 bytes, main.o(.text), UNUSED)

[Called By]

- >> TIM_ETRClockMode2Config
- >> TIM_ETRClockMode1Config

TIM_ETRClockMode1Config (Thumb, 18 bytes, Stack size 8 bytes, main.o(.text), UNUSED)

[Calls]

- >> TIM_ETRConfig

TIM_ETRClockMode2Config (Thumb, 40 bytes, Stack size 8 bytes, main.o(.text), UNUSED)

[Calls]

- >> TIM_ETRConfig

TIM_PrescalerConfig (Thumb, 6 bytes, Stack size 0 bytes, main.o(.text), UNUSED)

TIM_CounterModeConfig (Thumb, 12 bytes, Stack size 0 bytes, main.o(.text), UNUSED)

TIM_EncoderInterfaceConfig (Thumb, 44 bytes, Stack size 16 bytes, main.o(.text), UNUSED)

TIM_ForcedOC1Config (Thumb, 12 bytes, Stack size 0 bytes, main.o(.text), UNUSED)

TIM_ForcedOC2Config (Thumb, 14 bytes, Stack size 0 bytes, main.o(.text), UNUSED)

TIM_ForcedOC3Config (Thumb, 12 bytes, Stack size 0 bytes, main.o(.text), UNUSED)

TIM_ForcedOC4Config (Thumb, 14 bytes, Stack size 0 bytes, main.o(.text), UNUSED)

TIM_ARRPreloadConfig (Thumb, 20 bytes, Stack size 0 bytes, main.o(.text), UNUSED)

TIM_SelectCOM (Thumb, 20 bytes, Stack size 0 bytes, main.o(.text), UNUSED)

TIM_SelectCCDMA (Thumb, 20 bytes, Stack size 0 bytes, main.o(.text), UNUSED)

TIM_CCPreloadControl (Thumb, 20 bytes, Stack size 0 bytes, main.o(.text), UNUSED)

TIM_OC1PreloadConfig (Thumb, 12 bytes, Stack size 0 bytes, main.o(.text), UNUSED)

TIM_OC2PreloadConfig (Thumb, 14 bytes, Stack size 0 bytes, main.o(.text), UNUSED)

TIM_OC3PreloadConfig (Thumb, 12 bytes, Stack size 0 bytes, main.o(.text), UNUSED)

TIM_OC4PreloadConfig (Thumb, 14 bytes, Stack size 0 bytes, main.o(.text), UNUSED)

TIM_OC1FastConfig (Thumb, 12 bytes, Stack size 0 bytes, main.o(.text), UNUSED)

TIM_OC2FastConfig (Thumb, 14 bytes, Stack size 0 bytes, main.o(.text), UNUSED)

TIM_OC3FastConfig (Thumb, 12 bytes, Stack size 0 bytes, main.o(.text), UNUSED)

TIM_OC4FastConfig (Thumb, 14 bytes, Stack size 0 bytes, main.o(.text), UNUSED)

TIM_ClearOC1Ref (Thumb, 12 bytes, Stack size 0 bytes, main.o(.text), UNUSED)

TIM_ClearOC2Ref (Thumb, 14 bytes, Stack size 0 bytes, main.o(.text), UNUSED)

TIM_ClearOC3Ref (Thumb, 12 bytes, Stack size 0 bytes, main.o(.text), UNUSED)

TIM_ClearOC4Ref (Thumb, 14 bytes, Stack size 0 bytes, main.o(.text), UNUSED)

TIM_OC1PolarityConfig (Thumb, 12 bytes, Stack size 0 bytes, main.o(.text), UNUSED)

TIM_OC1NPolarityConfig (Thumb, 12 bytes, Stack size 0 bytes, main.o(.text), UNUSED)

TIM_OC2PolarityConfig (Thumb, 14 bytes, Stack size 0 bytes, main.o(.text), UNUSED)

TIM_OC2NPolarityConfig (Thumb, 14 bytes, Stack size 0 bytes, main.o(.text), UNUSED)

TIM_OC3PolarityConfig (Thumb, 14 bytes, Stack size 0 bytes, main.o(.text), UNUSED)

TIM_OC3NPolarityConfig (Thumb, 14 bytes, Stack size 0 bytes, main.o(.text), UNUSED)

TIM_OC4PolarityConfig (Thumb, 14 bytes, Stack size 0 bytes, main.o(.text), UNUSED)

TIM_CCxCmd (Thumb, 22 bytes, Stack size 8 bytes, main.o(.text), UNUSED)

TIM_CCxNCmd (Thumb, 22 bytes, Stack size 8 bytes, main.o(.text), UNUSED)

TIM_SelectOCxM (Thumb, 66 bytes, Stack size 12 bytes, main.o(.text), UNUSED)

TIM_UpdateDisableConfig (Thumb, 20 bytes, Stack size 0 bytes, main.o(.text), UNUSED)

TIM_UpdateRequestConfig (Thumb, 20 bytes, Stack size 0 bytes, main.o(.text), UNUSED)

TIM_SelectHallSensor (Thumb, 20 bytes, Stack size 0 bytes, main.o(.text), UNUSED)

TIM_SelectOnePulseMode (Thumb, 16 bytes, Stack size 0 bytes, main.o(.text), UNUSED)

TIM_SelectOutputTrigger (Thumb, 16 bytes, Stack size 0 bytes, main.o(.text), UNUSED)

TIM_SelectSlaveMode (Thumb, 16 bytes, Stack size 0 bytes, main.o(.text), UNUSED)

TIM_SelectMasterSlaveMode (Thumb, 16 bytes, Stack size 0 bytes, main.o(.text), UNUSED)

TIM_SetCounter (Thumb, 4 bytes, Stack size 0 bytes, main.o(.text), UNUSED)

TIM_SetAutoreload (Thumb, 4 bytes, Stack size 0 bytes, main.o(.text), UNUSED)

TIM_SetCompare1 (Thumb, 4 bytes, Stack size 0 bytes, main.o(.text), UNUSED)

TIM_SetCompare2 (Thumb, 4 bytes, Stack size 0 bytes, main.o(.text), UNUSED)

TIM_SetCompare3 (Thumb, 4 bytes, Stack size 0 bytes, main.o(.text), UNUSED)

TIM_SetCompare4 (Thumb, 6 bytes, Stack size 0 bytes, main.o(.text), UNUSED)

TIM_SetClockDivision (Thumb, 16 bytes, Stack size 0 bytes, main.o(.text), UNUSED)

TIM_GetCapture1 (Thumb, 4 bytes, Stack size 0 bytes, main.o(.text), UNUSED)

TIM_GetCapture2 (Thumb, 4 bytes, Stack size 0 bytes, main.o(.text), UNUSED)

TIM_GetCapture3 (Thumb, 4 bytes, Stack size 0 bytes, main.o(.text), UNUSED)

TIM_GetCapture4 (Thumb, 6 bytes, Stack size 0 bytes, main.o(.text), UNUSED)

TIM_GetCounter (Thumb, 4 bytes, Stack size 0 bytes, main.o(.text), UNUSED)

TIM_GetPrescaler (Thumb, 4 bytes, Stack size 0 bytes, main.o(.text), UNUSED)

TIM_GetFlagStatus (Thumb, 14 bytes, Stack size 0 bytes, main.o(.text), UNUSED)

TIM_ClearFlag (Thumb, 6 bytes, Stack size 0 bytes, main.o(.text), UNUSED)

TIM_GetITStatus (Thumb, 24 bytes, Stack size 0 bytes, main.o(.text), UNUSED)

TIM_ClearITPendingBit (Thumb, 6 bytes, Stack size 0 bytes, main.o(.text), UNUSED)

ctrlprocess (Thumb, 160 bytes, Stack size 8 bytes, main.o(.text))

[Stack]

- Max Depth = 176
- Call Chain = ctrlprocess ⇒ PcdAnticoll ⇒ PcdComMF522 ⇒ ClearBitMask ⇒ WriteRawRC ⇒ SPIWriteByte

[Calls]

- >> PcdWrite
- >> PcdSelect
- >> PcdRequest
- >> PcdRead
- >> PcdHalt
- >> PcdAuthState
- >> PcdAnticoll

[Called By]

- >> main

main (Thumb, 22 bytes, Stack size 0 bytes, main.o(.text))

[Stack]

- Max Depth = 176
- Call Chain = main ⇒ ctrlprocess ⇒ PcdAnticoll ⇒ PcdComMF522 ⇒ ClearBitMask ⇒ WriteRawRC ⇒ SPIWriteByte

[Calls]

- >> delay_init
- >> Stm32_Clock_Init
- >> InitRc522
- >> ctrlprocess

[Called By]

- >> __rt_entry_main

RCC_Configuration (Thumb, 96 bytes, Stack size 8 bytes, sys.o(.text), UNUSED)

[Calls]

- >> FLASH_PrefetchBufferCmd
- >> FLASH_SetLatency
- >> RCC_PCLK2Config
- >> RCC_PCLK1Config
- >> RCC_HCLKConfig
- >> RCC_GetSYSCLKSource
- >> RCC_SYSCLKConfig
- >> RCC_PLLCmd
- >> RCC_PLLConfig
- >> RCC_HSICmd
- >> RCC_GetFlagStatus
- >> RCC_DeInit

Stm32_Clock_Init (Thumb, 90 bytes, Stack size 0 bytes, sys.o(.text))

[Called By]

- >> main

delay_init (Thumb, 28 bytes, Stack size 0 bytes, sys.o(.text))

[Called By]

- >> main

delay_ms (Thumb, 36 bytes, Stack size 0 bytes, sys.o(.text), UNUSED)

delay_us (Thumb, 36 bytes, Stack size 0 bytes, sys.o(.text), UNUSED)

RC522_delay_ns (Thumb, 32 bytes, Stack size 0 bytes, rc522.o(.text))

[Called By]

- >> PcdReset
- >> M500PcdConfigISOType

RC522_IO_Init (Thumb, 62 bytes, Stack size 16 bytes, rc522.o(.text))

[Stack]

- Max Depth = 36
- Call Chain = RC522_IO_Init ⇒ GPIO_Init

[Calls]

- >> GPIO_Init
- >> RCC_APB2PeriphClockCmd

[Called By]

- >> InitRc522

SPIWriteByte (Thumb, 66 bytes, Stack size 24 bytes, rc522.o(.text))

[Stack]

- Max Depth = 24
- Call Chain = SPIWriteByte

[Calls]

- >> GPIO_ResetBits
- >> GPIO_SetBits

[Called By]

- >> ReadRawRC
- >> WriteRawRC

WriteRawRC (Thumb, 50 bytes, Stack size 24 bytes, rc522.o(.text))

[Stack]

- Max Depth = 48
- Call Chain = WriteRawRC ⇒ SPIWriteByte

[Calls]

- >> SPIWriteByte
- >> GPIO_ResetBits
- >> GPIO_SetBits

[Called By]

- >> CalulateCRC
- >> PcdComMF522
- >> PcdReset
- >> M500PcdConfigISOType
- >> ClearBitMask
- >> SetBitMask
- >> PcdRequest
- >> PcdAnticoll

SPIReadByte (Thumb, 64 bytes, Stack size 24 bytes, rc522.o(.text))

[Stack]

- Max Depth = 24
- Call Chain = SPIReadByte

[Calls]

- >> GPIO_ResetBits
- >> GPIO_SetBits
- >> GPIO_ReadInputDataBit

[Called By]

- >> ReadRawRC

ReadRawRC (Thumb, 50 bytes, Stack size 16 bytes, rc522.o(.text))

[Stack]

- Max Depth = 40
- Call Chain = ReadRawRC ⇒ SPIReadByte

[Calls]

- >> SPIReadByte
- >> SPIWriteByte
- >> GPIO_ResetBits
- >> GPIO_SetBits

[Called By]

- >> CalulateCRC
- >> PcdComMF522
- >> ClearBitMask
- >> PcdAntennaOn
- >> SetBitMask
- >> PcdAuthState

SetBitMask (Thumb, 22 bytes, Stack size 16 bytes, rc522.o(.text))

[Stack]

- Max Depth = 64
- Call Chain = SetBitMask ⇒ WriteRawRC ⇒ SPIWriteByte

[Calls]

- >> ReadRawRC
- >> WriteRawRC

[Called By]

- >> CalulateCRC
- >> PcdComMF522
- >> PcdAntennaOn
- >> PcdRequest
- >> PcdAnticoll

PcdAntennaOn (Thumb, 24 bytes, Stack size 8 bytes, rc522.o(.text))

[Stack]

- Max Depth = 72
- Call Chain = PcdAntennaOn ⇒ SetBitMask ⇒ WriteRawRC ⇒ SPIWriteByte

[Calls]

- >> SetBitMask
- >> ReadRawRC

[Called By]

- >> M500PcdConfigISOType
- >> InitRc522

ClearBitMask (Thumb, 22 bytes, Stack size 16 bytes, rc522.o(.text))

[Stack]

- Max Depth = 64
- Call Chain = ClearBitMask ⇒ WriteRawRC ⇒ SPIWriteByte

[Calls]

- >> ReadRawRC
- >> WriteRawRC

[Called By]

- >> CalulateCRC
- >> PcdComMF522
- >> PcdAntennaOff
- >> M500PcdConfigISOType
- >> PcdSelect
- >> PcdRequest
- >> PcdAnticoll

M500PcdConfigISOType (Thumb, 90 bytes, Stack size 8 bytes, rc522.o(.text))

[Stack]

- Max Depth = 80
- Call Chain = M500PcdConfigISOType ⇒ PcdAntennaOn ⇒ SetBitMask ⇒ WriteRawRC ⇒ SPIWriteByte

[Calls]

- >> ClearBitMask
- >> PcdAntennaOn
- >> WriteRawRC
- >> RC522_delay_ns

[Called By]

- >> InitRc522

PcdAntennaOff (Thumb, 6 bytes, Stack size 0 bytes, rc522.o(.text))

[Stack]

- Max Depth = 64
- Call Chain = PcdAntennaOff ⇒ ClearBitMask ⇒ WriteRawRC ⇒ SPIWriteByte

[Calls]

- >> ClearBitMask

[Called By]

- >> InitRc522

PcdReset (Thumb, 112 bytes, Stack size 8 bytes, rc522.o(.text))

[Stack]

- Max Depth = 56
- Call Chain = PcdReset ⇒ WriteRawRC ⇒ SPIWriteByte

[Calls]

- >> WriteRawRC
- >> RC522_delay_ns
- >> GPIO_ResetBits
- >> GPIO_SetBits

[Called By]

- >> InitRc522

InitRc522 (Thumb, 26 bytes, Stack size 8 bytes, rc522.o(.text))

[Stack]

- Max Depth = 88
- Call Chain = InitRc522 ⇒ M500PcdConfigISOType ⇒ PcdAntennaOn ⇒ SetBitMask ⇒ WriteRawRC ⇒ SPIWriteByte

[Calls]

- >> PcdReset
- >> PcdAntennaOff
- >> M500PcdConfigISOType
- >> PcdAntennaOn
- >> RC522_IO_Init

[Called By]

- >> main

PcdComMF522 (Thumb, 276 bytes, Stack size 56 bytes, rc522.o(.text))

[Stack]

- Max Depth = 120
- Call Chain = PcdComMF522 ⇒ ClearBitMask ⇒ WriteRawRC ⇒ SPIWriteByte

[Calls]

- >> ClearBitMask
- >> SetBitMask
- >> ReadRawRC
- >> WriteRawRC

[Called By]

- >> PcdWrite
- >> PcdSelect
- >> PcdRequest
- >> PcdRead
- >> PcdHalt
- >> PcdAuthState
- >> PcdAnticoll

PcdRequest (Thumb, 80 bytes, Stack size 40 bytes, rc522.o(.text))

[Stack]

- Max Depth = 160
- Call Chain = PcdRequest ⇒ PcdComMF522 ⇒ ClearBitMask ⇒ WriteRawRC ⇒ SPIWriteByte

[Calls]

- >> PcdComMF522
- >> ClearBitMask
- >> SetBitMask
- >> WriteRawRC

[Called By]

- >> ctrlprocess

PcdAnticoll (Thumb, 110 bytes, Stack size 48 bytes, rc522.o(.text))

[Stack]

- Max Depth = 168
- Call Chain = PcdAnticoll ⇒ PcdComMF522 ⇒ ClearBitMask ⇒ WriteRawRC ⇒ SPIWriteByte

[Calls]

- >> PcdComMF522
- >> ClearBitMask
- >> SetBitMask
- >> WriteRawRC

[Called By]

- >> ctrlprocess

CalulateCRC (Thumb, 102 bytes, Stack size 24 bytes, rc522.o(.text))

[Stack]

- Max Depth = 88
- Call Chain = CalulateCRC ⇒ ClearBitMask ⇒ WriteRawRC ⇒ SPIWriteByte

[Calls]

- >> ClearBitMask
- >> SetBitMask
- >> ReadRawRC
- >> WriteRawRC

[Called By]

- >> PcdWrite
- >> PcdSelect
- >> PcdRead
- >> PcdHalt

PcdSelect (Thumb, 98 bytes, Stack size 40 bytes, rc522.o(.text))

[Stack]

- Max Depth = 160
- Call Chain = PcdSelect ⇒ PcdComMF522 ⇒ ClearBitMask ⇒ WriteRawRC ⇒ SPIWriteByte

[Calls]

- >> CalulateCRC
- >> PcdComMF522
- >> ClearBitMask

[Called By]

- >> ctrlprocess

PcdAuthState (Thumb, 80 bytes, Stack size 40 bytes, rc522.o(.text))

[Stack]

- Max Depth = 160
- Call Chain = PcdAuthState ⇒ PcdComMF522 ⇒ ClearBitMask ⇒ WriteRawRC ⇒ SPIWriteByte

[Calls]

- >> PcdComMF522
- >> ReadRawRC

[Called By]

- >> ctrlprocess

PcdRead (Thumb, 72 bytes, Stack size 40 bytes, rc522.o(.text))

[Stack]

- Max Depth = 160
- Call Chain = PcdRead ⇒ PcdComMF522 ⇒ ClearBitMask ⇒ WriteRawRC ⇒ SPIWriteByte

[Calls]

- >> CalulateCRC
- >> PcdComMF522

[Called By]

- >> ctrlprocess

PcdWrite (Thumb, 128 bytes, Stack size 40 bytes, rc522.o(.text))

[Stack]

- Max Depth = 160
- Call Chain = PcdWrite ⇒ PcdComMF522 ⇒ ClearBitMask ⇒ WriteRawRC ⇒ SPIWriteByte

[Calls]

- >> CalulateCRC
- >> PcdComMF522

[Called By]

- >> ctrlprocess

PcdHalt (Thumb, 50 bytes, Stack size 32 bytes, rc522.o(.text))

[Stack]

- Max Depth = 152
- Call Chain = PcdHalt ⇒ PcdComMF522 ⇒ ClearBitMask ⇒ WriteRawRC ⇒ SPIWriteByte

[Calls]

- >> CalulateCRC
- >> PcdComMF522

[Called By]

- >> ctrlprocess

__use_two_region_memory (Thumb, 2 bytes, Stack size 0 bytes, heapauxi.o(.text), UNUSED)

__rt_heap_escrow$2region (Thumb, 2 bytes, Stack size 0 bytes, heapauxi.o(.text), UNUSED)

__rt_heap_expand$2region (Thumb, 2 bytes, Stack size 0 bytes, heapauxi.o(.text), UNUSED)

__user_setup_stackheap (Thumb, 74 bytes, Stack size 8 bytes, sys_stackheap_outer.o(.text))

[Stack]

- Max Depth = 8 + Unknown Stack Size
- Call Chain = __user_setup_stackheap

[Calls]

- >> __user_perproc_libspace
- >> __user_initial_stackheap

[Called By]

- >> __rt_entry_sh

exit (Thumb, 12 bytes, Stack size 0 bytes, exit.o(.text))

[Calls]

- >> __rt_exit

[Called By]

- >> __rt_entry_main

__user_libspace (Thumb, 8 bytes, Stack size 0 bytes, libspace.o(.text), UNUSED)

__user_perproc_libspace (Thumb, 0 bytes, Stack size 0 bytes, libspace.o(.text))

[Called By]

- >> __user_setup_stackheap

__user_perthread_libspace (Thumb, 0 bytes, Stack size 0 bytes, libspace.o(.text), UNUSED)

__rt_fp_status_addr (Thumb, 12 bytes, Stack size 0 bytes, rt_fp_status_addr_intlibspace.o(.text))

[Called By]

- >> _fp_init

_sys_exit (Thumb, 8 bytes, Stack size 0 bytes, sys_exit.o(.text))

[Called By]

- >> __rt_exit_exit

__I$use$semihosting (Thumb, 0 bytes, Stack size 0 bytes, use_no_semi.o(.text), UNUSED)

__use_no_semihosting_swi (Thumb, 2 bytes, Stack size 0 bytes, use_no_semi.o(.text), UNUSED)

_fp_init (Thumb, 14 bytes, Stack size 8 bytes, fpinit.o(x$fpl$fpinit))

[Stack]

- Max Depth = 8
- Call Chain = _fp_init

[Calls]

- >> __rt_fp_status_addr

[Called By]

- >> __rt_lib_init

__fplib_config_pureend_doubles (Thumb, 0 bytes, Stack size unknown bytes, fpinit.o(x$fpl$fpinit), UNUSED)

### Local Symbols

TI2_Config (Thumb, 98 bytes, Stack size 16 bytes, main.o(.text), UNUSED)

[Called By]

- >> TIM_TIxExternalClockConfig
- >> TIM_PWMIConfig
- >> TIM_ICInit

TI1_Config (Thumb, 84 bytes, Stack size 12 bytes, main.o(.text), UNUSED)

[Called By]

- >> TIM_TIxExternalClockConfig
- >> TIM_PWMIConfig
- >> TIM_ICInit

### Undefined Global Symbols
