valeb/Projekt/Codewarrior/Testsoftware/Bewegungsmelder/Sources/Version.txt

Version 2.0     Revision vom 21. Oktober 2011

Erste Basis-Software

Version 2.1     Revision vom 22. Oktober 2011

Erste Basis-Software
