valeb/Projekt/Codewarrior/Testsoftware/RFID-MC522 - Kopie/Ú¦¦ÕÁîþöÁÕ¡ÉÕ¦äÚóæµ¿íÕØùÞÁäµûÖ/RC522_STM32/project 3.0.1 MFRC522/out/project.htm

# Static Call Graph for image .\out\project.axf

#<CALLGRAPH># ARM Linker, 4.1 [Build 481]: Last Updated: Sat Sep 29 17:07:38 2012

### Maximum Stack Usage = 236 bytes + Unknown(Cycles, Untraceable Function Pointers)

### Call chain for Maximum Stack Depth:

main ⇒ Store ⇒ ReadData ⇒ PcdAuthState ⇒ PcdComMF522 ⇒ ClearBitMask ⇒ ReadRawRC

### Mutually Recursive functions

- NMI_Handler ⇒ NMI_Handler
- HardFault_Handler ⇒ HardFault_Handler
- MemManage_Handler ⇒ MemManage_Handler
- BusFault_Handler ⇒ BusFault_Handler
- UsageFault_Handler ⇒ UsageFault_Handler
- SVC_Handler ⇒ SVC_Handler
- DebugMon_Handler ⇒ DebugMon_Handler
- PendSV_Handler ⇒ PendSV_Handler
- SysTick_Handler ⇒ SysTick_Handler
- ADC1_2_IRQHandler ⇒ ADC1_2_IRQHandler

### Function Pointers

- Reset_Handler from startup_stm32f10x_hd.o(.text) referenced from startup_stm32f10x_hd.o(RESET)
- NMI_Handler from startup_stm32f10x_hd.o(.text) referenced from startup_stm32f10x_hd.o(RESET)
- HardFault_Handler from startup_stm32f10x_hd.o(.text) referenced from startup_stm32f10x_hd.o(RESET)
- MemManage_Handler from startup_stm32f10x_hd.o(.text) referenced from startup_stm32f10x_hd.o(RESET)
- BusFault_Handler from startup_stm32f10x_hd.o(.text) referenced from startup_stm32f10x_hd.o(RESET)
- UsageFault_Handler from startup_stm32f10x_hd.o(.text) referenced from startup_stm32f10x_hd.o(RESET)
- SVC_Handler from startup_stm32f10x_hd.o(.text) referenced from startup_stm32f10x_hd.o(RESET)
- DebugMon_Handler from startup_stm32f10x_hd.o(.text) referenced from startup_stm32f10x_hd.o(RESET)
- PendSV_Handler from startup_stm32f10x_hd.o(.text) referenced from startup_stm32f10x_hd.o(RESET)
- SysTick_Handler from startup_stm32f10x_hd.o(.text) referenced from startup_stm32f10x_hd.o(RESET)
- WWDG_IRQHandler from startup_stm32f10x_hd.o(.text) referenced from startup_stm32f10x_hd.o(RESET)
- PVD_IRQHandler from startup_stm32f10x_hd.o(.text) referenced from startup_stm32f10x_hd.o(RESET)
- TAMPER_IRQHandler from startup_stm32f10x_hd.o(.text) referenced from startup_stm32f10x_hd.o(RESET)
- RTC_IRQHandler from startup_stm32f10x_hd.o(.text) referenced from startup_stm32f10x_hd.o(RESET)
- FLASH_IRQHandler from startup_stm32f10x_hd.o(.text) referenced from startup_stm32f10x_hd.o(RESET)
- RCC_IRQHandler from startup_stm32f10x_hd.o(.text) referenced from startup_stm32f10x_hd.o(RESET)
- EXTI0_IRQHandler from startup_stm32f10x_hd.o(.text) referenced from startup_stm32f10x_hd.o(RESET)
- EXTI1_IRQHandler from startup_stm32f10x_hd.o(.text) referenced from startup_stm32f10x_hd.o(RESET)
- EXTI2_IRQHandler from startup_stm32f10x_hd.o(.text) referenced from startup_stm32f10x_hd.o(RESET)
- EXTI3_IRQHandler from startup_stm32f10x_hd.o(.text) referenced from startup_stm32f10x_hd.o(RESET)
- EXTI4_IRQHandler from startup_stm32f10x_hd.o(.text) referenced from startup_stm32f10x_hd.o(RESET)
- DMA1_Channel1_IRQHandler from startup_stm32f10x_hd.o(.text) referenced from startup_stm32f10x_hd.o(RESET)
- DMA1_Channel2_IRQHandler from startup_stm32f10x_hd.o(.text) referenced from startup_stm32f10x_hd.o(RESET)
- DMA1_Channel3_IRQHandler from startup_stm32f10x_hd.o(.text) referenced from startup_stm32f10x_hd.o(RESET)
- DMA1_Channel4_IRQHandler from startup_stm32f10x_hd.o(.text) referenced from startup_stm32f10x_hd.o(RESET)
- DMA1_Channel5_IRQHandler from startup_stm32f10x_hd.o(.text) referenced from startup_stm32f10x_hd.o(RESET)
- DMA1_Channel6_IRQHandler from startup_stm32f10x_hd.o(.text) referenced from startup_stm32f10x_hd.o(RESET)
- DMA1_Channel7_IRQHandler from startup_stm32f10x_hd.o(.text) referenced from startup_stm32f10x_hd.o(RESET)
- ADC1_2_IRQHandler from startup_stm32f10x_hd.o(.text) referenced from startup_stm32f10x_hd.o(RESET)
- USB_HP_CAN1_TX_IRQHandler from startup_stm32f10x_hd.o(.text) referenced from startup_stm32f10x_hd.o(RESET)
- USB_LP_CAN1_RX0_IRQHandler from startup_stm32f10x_hd.o(.text) referenced from startup_stm32f10x_hd.o(RESET)
- CAN1_RX1_IRQHandler from startup_stm32f10x_hd.o(.text) referenced from startup_stm32f10x_hd.o(RESET)
- CAN1_SCE_IRQHandler from startup_stm32f10x_hd.o(.text) referenced from startup_stm32f10x_hd.o(RESET)
- EXTI9_5_IRQHandler from startup_stm32f10x_hd.o(.text) referenced from startup_stm32f10x_hd.o(RESET)
- TIM1_BRK_IRQHandler from startup_stm32f10x_hd.o(.text) referenced from startup_stm32f10x_hd.o(RESET)
- TIM1_UP_IRQHandler from startup_stm32f10x_hd.o(.text) referenced from startup_stm32f10x_hd.o(RESET)
- TIM1_TRG_COM_IRQHandler from startup_stm32f10x_hd.o(.text) referenced from startup_stm32f10x_hd.o(RESET)
- TIM1_CC_IRQHandler from startup_stm32f10x_hd.o(.text) referenced from startup_stm32f10x_hd.o(RESET)
- TIM2_IRQHandler from startup_stm32f10x_hd.o(.text) referenced from startup_stm32f10x_hd.o(RESET)
- TIM3_IRQHandler from startup_stm32f10x_hd.o(.text) referenced from startup_stm32f10x_hd.o(RESET)
- TIM4_IRQHandler from startup_stm32f10x_hd.o(.text) referenced from startup_stm32f10x_hd.o(RESET)
- I2C1_EV_IRQHandler from startup_stm32f10x_hd.o(.text) referenced from startup_stm32f10x_hd.o(RESET)
- I2C1_ER_IRQHandler from startup_stm32f10x_hd.o(.text) referenced from startup_stm32f10x_hd.o(RESET)
- I2C2_EV_IRQHandler from startup_stm32f10x_hd.o(.text) referenced from startup_stm32f10x_hd.o(RESET)
- I2C2_ER_IRQHandler from startup_stm32f10x_hd.o(.text) referenced from startup_stm32f10x_hd.o(RESET)
- SPI1_IRQHandler from startup_stm32f10x_hd.o(.text) referenced from startup_stm32f10x_hd.o(RESET)
- SPI2_IRQHandler from startup_stm32f10x_hd.o(.text) referenced from startup_stm32f10x_hd.o(RESET)
- USART1_IRQHandler from init_sys.o(.text) referenced from startup_stm32f10x_hd.o(RESET)
- USART2_IRQHandler from startup_stm32f10x_hd.o(.text) referenced from startup_stm32f10x_hd.o(RESET)
- USART3_IRQHandler from startup_stm32f10x_hd.o(.text) referenced from startup_stm32f10x_hd.o(RESET)
- EXTI15_10_IRQHandler from startup_stm32f10x_hd.o(.text) referenced from startup_stm32f10x_hd.o(RESET)
- RTCAlarm_IRQHandler from startup_stm32f10x_hd.o(.text) referenced from startup_stm32f10x_hd.o(RESET)
- USBWakeUp_IRQHandler from startup_stm32f10x_hd.o(.text) referenced from startup_stm32f10x_hd.o(RESET)
- TIM8_BRK_IRQHandler from startup_stm32f10x_hd.o(.text) referenced from startup_stm32f10x_hd.o(RESET)
- TIM8_UP_IRQHandler from startup_stm32f10x_hd.o(.text) referenced from startup_stm32f10x_hd.o(RESET)
- TIM8_TRG_COM_IRQHandler from startup_stm32f10x_hd.o(.text) referenced from startup_stm32f10x_hd.o(RESET)
- TIM8_CC_IRQHandler from startup_stm32f10x_hd.o(.text) referenced from startup_stm32f10x_hd.o(RESET)
- ADC3_IRQHandler from startup_stm32f10x_hd.o(.text) referenced from startup_stm32f10x_hd.o(RESET)
- FSMC_IRQHandler from startup_stm32f10x_hd.o(.text) referenced from startup_stm32f10x_hd.o(RESET)
- SDIO_IRQHandler from startup_stm32f10x_hd.o(.text) referenced from startup_stm32f10x_hd.o(RESET)
- TIM5_IRQHandler from startup_stm32f10x_hd.o(.text) referenced from startup_stm32f10x_hd.o(RESET)
- SPI3_IRQHandler from startup_stm32f10x_hd.o(.text) referenced from startup_stm32f10x_hd.o(RESET)
- UART4_IRQHandler from startup_stm32f10x_hd.o(.text) referenced from startup_stm32f10x_hd.o(RESET)
- UART5_IRQHandler from startup_stm32f10x_hd.o(.text) referenced from startup_stm32f10x_hd.o(RESET)
- TIM6_IRQHandler from startup_stm32f10x_hd.o(.text) referenced from startup_stm32f10x_hd.o(RESET)
- TIM7_IRQHandler from startup_stm32f10x_hd.o(.text) referenced from startup_stm32f10x_hd.o(RESET)
- DMA2_Channel1_IRQHandler from startup_stm32f10x_hd.o(.text) referenced from startup_stm32f10x_hd.o(RESET)
- DMA2_Channel2_IRQHandler from startup_stm32f10x_hd.o(.text) referenced from startup_stm32f10x_hd.o(RESET)
- DMA2_Channel3_IRQHandler from startup_stm32f10x_hd.o(.text) referenced from startup_stm32f10x_hd.o(RESET)
- DMA2_Channel4_5_IRQHandler from startup_stm32f10x_hd.o(.text) referenced from startup_stm32f10x_hd.o(RESET)
- main from project.o(.text) referenced from entry7.o(.ARM.Collect$$$$00000007)
- SystemInit_ExtMemCtl from startup_stm32f10x_hd.o(.text) referenced from startup_stm32f10x_hd.o(.text)
- __main from entry.o(.ARM.Collect$$$$00000000) referenced from startup_stm32f10x_hd.o(.text)
- fputc from retarget.o(.text) referenced from printf8.o(i.__0printf$8)

### Global Symbols

__main (Thumb, 0 bytes, Stack size unknown bytes, entry.o(.ARM.Collect$$$$00000000))
[Address Reference Count : 1]

- startup_stm32f10x_hd.o(.text)

_main_stk (Thumb, 0 bytes, Stack size unknown bytes, entry2.o(.ARM.Collect$$$$00000001))

_main_scatterload (Thumb, 0 bytes, Stack size unknown bytes, entry5.o(.ARM.Collect$$$$00000004))

[Calls]

- >> __scatterload

__main_after_scatterload (Thumb, 0 bytes, Stack size unknown bytes, entry5.o(.ARM.Collect$$$$00000004))

[Called By]

- >> __scatterload

_main_init (Thumb, 0 bytes, Stack size unknown bytes, entry7.o(.ARM.Collect$$$$00000007))

SystemInit_ExtMemCtl (Thumb, 2 bytes, Stack size 0 bytes, startup_stm32f10x_hd.o(.text))
[Address Reference Count : 1]

- startup_stm32f10x_hd.o(.text)

Reset_Handler (Thumb, 14 bytes, Stack size 0 bytes, startup_stm32f10x_hd.o(.text))
[Address Reference Count : 1]

- startup_stm32f10x_hd.o(RESET)

NMI_Handler (Thumb, 2 bytes, Stack size 0 bytes, startup_stm32f10x_hd.o(.text))

[Calls]

- >> NMI_Handler

[Called By]

- >> NMI_Handler

[Address Reference Count : 1]

- startup_stm32f10x_hd.o(RESET)

HardFault_Handler (Thumb, 2 bytes, Stack size 0 bytes, startup_stm32f10x_hd.o(.text))

[Calls]

- >> HardFault_Handler

[Called By]

- >> HardFault_Handler

[Address Reference Count : 1]

- startup_stm32f10x_hd.o(RESET)

MemManage_Handler (Thumb, 2 bytes, Stack size 0 bytes, startup_stm32f10x_hd.o(.text))

[Calls]

- >> MemManage_Handler

[Called By]

- >> MemManage_Handler

[Address Reference Count : 1]

- startup_stm32f10x_hd.o(RESET)

BusFault_Handler (Thumb, 2 bytes, Stack size 0 bytes, startup_stm32f10x_hd.o(.text))

[Calls]

- >> BusFault_Handler

[Called By]

- >> BusFault_Handler

[Address Reference Count : 1]

- startup_stm32f10x_hd.o(RESET)

UsageFault_Handler (Thumb, 2 bytes, Stack size 0 bytes, startup_stm32f10x_hd.o(.text))

[Calls]

- >> UsageFault_Handler

[Called By]

- >> UsageFault_Handler

[Address Reference Count : 1]

- startup_stm32f10x_hd.o(RESET)

SVC_Handler (Thumb, 2 bytes, Stack size 0 bytes, startup_stm32f10x_hd.o(.text))

[Calls]

- >> SVC_Handler

[Called By]

- >> SVC_Handler

[Address Reference Count : 1]

- startup_stm32f10x_hd.o(RESET)

DebugMon_Handler (Thumb, 2 bytes, Stack size 0 bytes, startup_stm32f10x_hd.o(.text))

[Calls]

- >> DebugMon_Handler

[Called By]

- >> DebugMon_Handler

[Address Reference Count : 1]

- startup_stm32f10x_hd.o(RESET)

PendSV_Handler (Thumb, 2 bytes, Stack size 0 bytes, startup_stm32f10x_hd.o(.text))

[Calls]

- >> PendSV_Handler

[Called By]

- >> PendSV_Handler

[Address Reference Count : 1]

- startup_stm32f10x_hd.o(RESET)

SysTick_Handler (Thumb, 2 bytes, Stack size 0 bytes, startup_stm32f10x_hd.o(.text))

[Calls]

- >> SysTick_Handler

[Called By]

- >> SysTick_Handler

[Address Reference Count : 1]

- startup_stm32f10x_hd.o(RESET)

ADC1_2_IRQHandler (Thumb, 0 bytes, Stack size 0 bytes, startup_stm32f10x_hd.o(.text))

[Calls]

- >> ADC1_2_IRQHandler

[Called By]

- >> ADC1_2_IRQHandler

[Address Reference Count : 1]

- startup_stm32f10x_hd.o(RESET)

ADC3_IRQHandler (Thumb, 0 bytes, Stack size 0 bytes, startup_stm32f10x_hd.o(.text))
[Address Reference Count : 1]

- startup_stm32f10x_hd.o(RESET)

CAN1_RX1_IRQHandler (Thumb, 0 bytes, Stack size 0 bytes, startup_stm32f10x_hd.o(.text))
[Address Reference Count : 1]

- startup_stm32f10x_hd.o(RESET)

CAN1_SCE_IRQHandler (Thumb, 0 bytes, Stack size 0 bytes, startup_stm32f10x_hd.o(.text))
[Address Reference Count : 1]

- startup_stm32f10x_hd.o(RESET)

DMA1_Channel1_IRQHandler (Thumb, 0 bytes, Stack size 0 bytes, startup_stm32f10x_hd.o(.text))
[Address Reference Count : 1]

- startup_stm32f10x_hd.o(RESET)

DMA1_Channel2_IRQHandler (Thumb, 0 bytes, Stack size 0 bytes, startup_stm32f10x_hd.o(.text))
[Address Reference Count : 1]

- startup_stm32f10x_hd.o(RESET)

DMA1_Channel3_IRQHandler (Thumb, 0 bytes, Stack size 0 bytes, startup_stm32f10x_hd.o(.text))
[Address Reference Count : 1]

- startup_stm32f10x_hd.o(RESET)

DMA1_Channel4_IRQHandler (Thumb, 0 bytes, Stack size 0 bytes, startup_stm32f10x_hd.o(.text))
[Address Reference Count : 1]

- startup_stm32f10x_hd.o(RESET)

DMA1_Channel5_IRQHandler (Thumb, 0 bytes, Stack size 0 bytes, startup_stm32f10x_hd.o(.text))
[Address Reference Count : 1]

- startup_stm32f10x_hd.o(RESET)

DMA1_Channel6_IRQHandler (Thumb, 0 bytes, Stack size 0 bytes, startup_stm32f10x_hd.o(.text))
[Address Reference Count : 1]

- startup_stm32f10x_hd.o(RESET)

DMA1_Channel7_IRQHandler (Thumb, 0 bytes, Stack size 0 bytes, startup_stm32f10x_hd.o(.text))
[Address Reference Count : 1]

- startup_stm32f10x_hd.o(RESET)

DMA2_Channel1_IRQHandler (Thumb, 0 bytes, Stack size 0 bytes, startup_stm32f10x_hd.o(.text))
[Address Reference Count : 1]

- startup_stm32f10x_hd.o(RESET)

DMA2_Channel2_IRQHandler (Thumb, 0 bytes, Stack size 0 bytes, startup_stm32f10x_hd.o(.text))
[Address Reference Count : 1]

- startup_stm32f10x_hd.o(RESET)

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

TIM2_IRQHandler (Thumb, 0 bytes, Stack size 0 bytes, startup_stm32f10x_hd.o(.text))
[Address Reference Count : 1]

- startup_stm32f10x_hd.o(RESET)

TIM3_IRQHandler (Thumb, 0 bytes, Stack size 0 bytes, startup_stm32f10x_hd.o(.text))
[Address Reference Count : 1]

- startup_stm32f10x_hd.o(RESET)

TIM4_IRQHandler (Thumb, 0 bytes, Stack size 0 bytes, startup_stm32f10x_hd.o(.text))
[Address Reference Count : 1]

- startup_stm32f10x_hd.o(RESET)

TIM5_IRQHandler (Thumb, 0 bytes, Stack size 0 bytes, startup_stm32f10x_hd.o(.text))
[Address Reference Count : 1]

- startup_stm32f10x_hd.o(RESET)

TIM6_IRQHandler (Thumb, 0 bytes, Stack size 0 bytes, startup_stm32f10x_hd.o(.text))
[Address Reference Count : 1]

- startup_stm32f10x_hd.o(RESET)

TIM7_IRQHandler (Thumb, 0 bytes, Stack size 0 bytes, startup_stm32f10x_hd.o(.text))
[Address Reference Count : 1]

- startup_stm32f10x_hd.o(RESET)

TIM8_BRK_IRQHandler (Thumb, 0 bytes, Stack size 0 bytes, startup_stm32f10x_hd.o(.text))
[Address Reference Count : 1]

- startup_stm32f10x_hd.o(RESET)

TIM8_CC_IRQHandler (Thumb, 0 bytes, Stack size 0 bytes, startup_stm32f10x_hd.o(.text))
[Address Reference Count : 1]

- startup_stm32f10x_hd.o(RESET)

TIM8_TRG_COM_IRQHandler (Thumb, 0 bytes, Stack size 0 bytes, startup_stm32f10x_hd.o(.text))
[Address Reference Count : 1]

- startup_stm32f10x_hd.o(RESET)

TIM8_UP_IRQHandler (Thumb, 0 bytes, Stack size 0 bytes, startup_stm32f10x_hd.o(.text))
[Address Reference Count : 1]

- startup_stm32f10x_hd.o(RESET)

UART4_IRQHandler (Thumb, 0 bytes, Stack size 0 bytes, startup_stm32f10x_hd.o(.text))
[Address Reference Count : 1]

- startup_stm32f10x_hd.o(RESET)

UART5_IRQHandler (Thumb, 0 bytes, Stack size 0 bytes, startup_stm32f10x_hd.o(.text))
[Address Reference Count : 1]

- startup_stm32f10x_hd.o(RESET)

USART2_IRQHandler (Thumb, 0 bytes, Stack size 0 bytes, startup_stm32f10x_hd.o(.text))
[Address Reference Count : 1]

- startup_stm32f10x_hd.o(RESET)

USART3_IRQHandler (Thumb, 0 bytes, Stack size 0 bytes, startup_stm32f10x_hd.o(.text))
[Address Reference Count : 1]

- startup_stm32f10x_hd.o(RESET)

USBWakeUp_IRQHandler (Thumb, 0 bytes, Stack size 0 bytes, startup_stm32f10x_hd.o(.text))
[Address Reference Count : 1]

- startup_stm32f10x_hd.o(RESET)

USB_HP_CAN1_TX_IRQHandler (Thumb, 0 bytes, Stack size 0 bytes, startup_stm32f10x_hd.o(.text))
[Address Reference Count : 1]

- startup_stm32f10x_hd.o(RESET)

USB_LP_CAN1_RX0_IRQHandler (Thumb, 0 bytes, Stack size 0 bytes, startup_stm32f10x_hd.o(.text))
[Address Reference Count : 1]

- startup_stm32f10x_hd.o(RESET)

WWDG_IRQHandler (Thumb, 0 bytes, Stack size 0 bytes, startup_stm32f10x_hd.o(.text))
[Address Reference Count : 1]

- startup_stm32f10x_hd.o(RESET)

fputc (Thumb, 14 bytes, Stack size 16 bytes, retarget.o(.text))

[Stack]

- Max Depth = 16
- Call Chain = fputc

[Calls]

- >> SendChar

[Address Reference Count : 1]

- printf8.o(i.__0printf$8)

fgetc (Thumb, 16 bytes, Stack size 16 bytes, retarget.o(.text), UNUSED)

[Calls]

- >> SendChar
- >> GetKey

_ttywrch (Thumb, 12 bytes, Stack size 8 bytes, retarget.o(.text), UNUSED)

[Calls]

- >> SendChar

ferror (Thumb, 8 bytes, Stack size 0 bytes, retarget.o(.text), UNUSED)

_sys_exit (Thumb, 4 bytes, Stack size 0 bytes, retarget.o(.text), UNUSED)

NVIC_PriorityGroupConfig (Thumb, 10 bytes, Stack size 0 bytes, misc.o(.text))

[Called By]

- >> NVIC_Configuration

NVIC_Init (Thumb, 118 bytes, Stack size 16 bytes, misc.o(.text))

[Stack]

- Max Depth = 16
- Call Chain = NVIC_Init

[Called By]

- >> NVIC_Configuration

NVIC_SetVectorTable (Thumb, 12 bytes, Stack size 0 bytes, misc.o(.text), UNUSED)

NVIC_SystemLPConfig (Thumb, 38 bytes, Stack size 0 bytes, misc.o(.text), UNUSED)

SysTick_CLKSourceConfig (Thumb, 40 bytes, Stack size 0 bytes, misc.o(.text), UNUSED)

WriteData (Thumb, 74 bytes, Stack size 32 bytes, project.o(.text))

[Stack]

- Max Depth = 156
- Call Chain = WriteData ⇒ PcdAuthState ⇒ PcdComMF522 ⇒ ClearBitMask ⇒ ReadRawRC

[Calls]

- >> PcdWrite
- >> PcdAuthState

[Called By]

- >> main
- >> Store

power (Thumb, 22 bytes, Stack size 8 bytes, project.o(.text))

[Stack]

- Max Depth = 8
- Call Chain = power

[Called By]

- >> Store
- >> PutNum

PutNum (Thumb, 140 bytes, Stack size 56 bytes, project.o(.text))

[Stack]

- Max Depth = 116
- Call Chain = PutNum ⇒ DisplayString ⇒ LCD_SetRegion

[Calls]

- >> LCD_SetRegion
- >> DisplayString
- >> power

[Called By]

- >> Store

ReadData (Thumb, 74 bytes, Stack size 32 bytes, project.o(.text))

[Stack]

- Max Depth = 156
- Call Chain = ReadData ⇒ PcdAuthState ⇒ PcdComMF522 ⇒ ClearBitMask ⇒ ReadRawRC

[Calls]

- >> PcdRead
- >> PcdAuthState

[Called By]

- >> main
- >> Store

Store (Thumb, 452 bytes, Stack size 56 bytes, project.o(.text))

[Stack]

- Max Depth = 212
- Call Chain = Store ⇒ ReadData ⇒ PcdAuthState ⇒ PcdComMF522 ⇒ ClearBitMask ⇒ ReadRawRC

[Calls]

- >> LCD_Fill
- >> DisplayString
- >> ReadData
- >> PutNum
- >> power
- >> WriteData

[Called By]

- >> main

ShowID (Thumb, 212 bytes, Stack size 48 bytes, project.o(.text))

[Stack]

- Max Depth = 108
- Call Chain = ShowID ⇒ DisplayString ⇒ LCD_SetRegion

[Calls]

- >> DisplayString

[Called By]

- >> main

main (Thumb, 522 bytes, Stack size 24 bytes, project.o(.text))

[Stack]

- Max Depth = 236
- Call Chain = main ⇒ Store ⇒ ReadData ⇒ PcdAuthState ⇒ PcdComMF522 ⇒ ClearBitMask ⇒ ReadRawRC

[Calls]

- >> __2printf
- >> UART_Init
- >> RCC_Configuration
- >> PcdSelect
- >> PcdRequest
- >> PcdHalt
- >> PcdAnticoll
- >> NVIC_Configuration
- >> LCD_Init
- >> LCD_Clear
- >> InitRc522
- >> GPIO_Configuration
- >> ShowID
- >> Store
- >> ReadData
- >> WriteData

[Address Reference Count : 1]

- entry7.o(.ARM.Collect$$$$00000007)

delay_us (Thumb, 46 bytes, Stack size 0 bytes, init_sys.o(.text), UNUSED)

delay_ms (Thumb, 48 bytes, Stack size 0 bytes, init_sys.o(.text), UNUSED)

MY_NVIC_SetVectorTable (Thumb, 12 bytes, Stack size 0 bytes, init_sys.o(.text))

[Called By]

- >> MyRCC_DeInit

MyRCC_DeInit (Thumb, 90 bytes, Stack size 4 bytes, init_sys.o(.text))

[Stack]

- Max Depth = 4
- Call Chain = MyRCC_DeInit

[Calls]

- >> MY_NVIC_SetVectorTable

[Called By]

- >> RCC_Configuration

RCC_Configuration (Thumb, 130 bytes, Stack size 12 bytes, init_sys.o(.text))

[Stack]

- Max Depth = 16
- Call Chain = RCC_Configuration ⇒ MyRCC_DeInit

[Calls]

- >> MyRCC_DeInit

[Called By]

- >> main

NVIC_Configuration (Thumb, 42 bytes, Stack size 8 bytes, init_sys.o(.text))

[Stack]

- Max Depth = 24
- Call Chain = NVIC_Configuration ⇒ NVIC_Init

[Calls]

- >> NVIC_Init
- >> NVIC_PriorityGroupConfig

[Called By]

- >> main

USART1_IRQHandler (Thumb, 74 bytes, Stack size 0 bytes, init_sys.o(.text))
[Address Reference Count : 1]

- startup_stm32f10x_hd.o(RESET)

GPIO_Configuration (Thumb, 40 bytes, Stack size 0 bytes, init_sys.o(.text))

[Called By]

- >> main

UART_Init (Thumb, 212 bytes, Stack size 40 bytes, init_sys.o(.text))

[Stack]

- Max Depth = 60
- Call Chain = UART_Init ⇒ __aeabi_frsub ⇒ __aeabi_fadd ⇒ _float_epilogue

[Calls]

- >> __aeabi_ui2f
- >> __aeabi_frsub
- >> __aeabi_fmul
- >> __aeabi_fdiv
- >> __aeabi_f2uiz

[Called By]

- >> main

SendChar (Thumb, 22 bytes, Stack size 0 bytes, init_sys.o(.text))

[Called By]

- >> _ttywrch
- >> fgetc
- >> fputc

GetKey (Thumb, 22 bytes, Stack size 0 bytes, init_sys.o(.text), UNUSED)

[Called By]

- >> fgetc

delay_ns (Thumb, 18 bytes, Stack size 0 bytes, rc522.o(.text))

[Called By]

- >> PcdReset
- >> M500PcdConfigISOType

SPIWriteByte (Thumb, 38 bytes, Stack size 0 bytes, rc522.o(.text))

[Called By]

- >> ReadRawRC
- >> WriteRawRC

SPI2_Init (Thumb, 218 bytes, Stack size 0 bytes, rc522.o(.text))

[Called By]

- >> InitRc522

WriteRawRC (Thumb, 42 bytes, Stack size 8 bytes, rc522.o(.text))

[Stack]

- Max Depth = 8
- Call Chain = WriteRawRC

[Calls]

- >> SPIWriteByte

[Called By]

- >> CalulateCRC
- >> PcdComMF522
- >> PcdReset
- >> M500PcdConfigISOType
- >> ClearBitMask
- >> SetBitMask
- >> PcdRequest
- >> PcdAnticoll

ReadRawRC (Thumb, 50 bytes, Stack size 8 bytes, rc522.o(.text))

[Stack]

- Max Depth = 8
- Call Chain = ReadRawRC

[Calls]

- >> SPIWriteByte

[Called By]

- >> CalulateCRC
- >> PcdComMF522
- >> ClearBitMask
- >> PcdAntennaOn
- >> SetBitMask
- >> PcdAuthState

SetBitMask (Thumb, 28 bytes, Stack size 16 bytes, rc522.o(.text))

[Stack]

- Max Depth = 24
- Call Chain = SetBitMask ⇒ ReadRawRC

[Calls]

- >> ReadRawRC
- >> WriteRawRC

[Called By]

- >> CalulateCRC
- >> PcdComMF522
- >> PcdAntennaOn
- >> PcdRequest
- >> PcdAnticoll

PcdAntennaOn (Thumb, 26 bytes, Stack size 8 bytes, rc522.o(.text))

[Stack]

- Max Depth = 32
- Call Chain = PcdAntennaOn ⇒ SetBitMask ⇒ ReadRawRC

[Calls]

- >> SetBitMask
- >> ReadRawRC

[Called By]

- >> M500PcdConfigISOType
- >> InitRc522

ClearBitMask (Thumb, 28 bytes, Stack size 16 bytes, rc522.o(.text))

[Stack]

- Max Depth = 24
- Call Chain = ClearBitMask ⇒ ReadRawRC

[Calls]

- >> ReadRawRC
- >> WriteRawRC

[Called By]

- >> CalulateCRC
- >> PcdComMF522
- >> PcdAntennaOff
- >> M500PcdConfigISOType
- >> PcdSelect
- >> PcdRequest
- >> PcdAnticoll

M500PcdConfigISOType (Thumb, 94 bytes, Stack size 8 bytes, rc522.o(.text))

[Stack]

- Max Depth = 40
- Call Chain = M500PcdConfigISOType ⇒ PcdAntennaOn ⇒ SetBitMask ⇒ ReadRawRC

[Calls]

- >> ClearBitMask
- >> PcdAntennaOn
- >> WriteRawRC
- >> delay_ns

[Called By]

- >> InitRc522

PcdAntennaOff (Thumb, 12 bytes, Stack size 4 bytes, rc522.o(.text))

[Stack]

- Max Depth = 28
- Call Chain = PcdAntennaOff ⇒ ClearBitMask ⇒ ReadRawRC

[Calls]

- >> ClearBitMask

[Called By]

- >> InitRc522

PcdReset (Thumb, 118 bytes, Stack size 4 bytes, rc522.o(.text))

[Stack]

- Max Depth = 12
- Call Chain = PcdReset ⇒ WriteRawRC

[Calls]

- >> WriteRawRC
- >> delay_ns

[Called By]

- >> InitRc522

InitRc522 (Thumb, 26 bytes, Stack size 4 bytes, rc522.o(.text))

[Stack]

- Max Depth = 44
- Call Chain = InitRc522 ⇒ M500PcdConfigISOType ⇒ PcdAntennaOn ⇒ SetBitMask ⇒ ReadRawRC

[Calls]

- >> PcdReset
- >> PcdAntennaOff
- >> M500PcdConfigISOType
- >> PcdAntennaOn
- >> SPI2_Init

[Called By]

- >> main

PcdComMF522 (Thumb, 312 bytes, Stack size 48 bytes, rc522.o(.text))

[Stack]

- Max Depth = 72
- Call Chain = PcdComMF522 ⇒ ClearBitMask ⇒ ReadRawRC

[Calls]

- >> ClearBitMask
- >> SetBitMask
- >> ReadRawRC
- >> WriteRawRC

[Called By]

- >> PcdWrite
- >> PcdSelect
- >> PcdRequest
- >> PcdRead
- >> PcdHalt
- >> PcdAuthState
- >> PcdAnticoll

PcdRequest (Thumb, 128 bytes, Stack size 44 bytes, rc522.o(.text))

[Stack]

- Max Depth = 116
- Call Chain = PcdRequest ⇒ PcdComMF522 ⇒ ClearBitMask ⇒ ReadRawRC

[Calls]

- >> PcdComMF522
- >> ClearBitMask
- >> SetBitMask
- >> WriteRawRC

[Called By]

- >> main

PcdAnticoll (Thumb, 112 bytes, Stack size 48 bytes, rc522.o(.text))

[Stack]

- Max Depth = 120
- Call Chain = PcdAnticoll ⇒ PcdComMF522 ⇒ ClearBitMask ⇒ ReadRawRC

[Calls]

- >> PcdComMF522
- >> ClearBitMask
- >> SetBitMask
- >> WriteRawRC

[Called By]

- >> main

CalulateCRC (Thumb, 106 bytes, Stack size 24 bytes, rc522.o(.text))

[Stack]

- Max Depth = 48
- Call Chain = CalulateCRC ⇒ ClearBitMask ⇒ ReadRawRC

[Calls]

- >> ClearBitMask
- >> SetBitMask
- >> ReadRawRC
- >> WriteRawRC

[Called By]

- >> PcdWrite
- >> PcdSelect
- >> PcdRead
- >> PcdHalt

PcdSelect (Thumb, 116 bytes, Stack size 44 bytes, rc522.o(.text))

[Stack]

- Max Depth = 116
- Call Chain = PcdSelect ⇒ PcdComMF522 ⇒ ClearBitMask ⇒ ReadRawRC

[Calls]

- >> CalulateCRC
- >> PcdComMF522
- >> ClearBitMask

[Called By]

- >> main

PcdAuthState (Thumb, 86 bytes, Stack size 52 bytes, rc522.o(.text))

[Stack]

- Max Depth = 124
- Call Chain = PcdAuthState ⇒ PcdComMF522 ⇒ ClearBitMask ⇒ ReadRawRC

[Calls]

- >> PcdComMF522
- >> ReadRawRC

[Called By]

- >> ReadData
- >> WriteData

PcdRead (Thumb, 86 bytes, Stack size 48 bytes, rc522.o(.text))

[Stack]

- Max Depth = 120
- Call Chain = PcdRead ⇒ PcdComMF522 ⇒ ClearBitMask ⇒ ReadRawRC

[Calls]

- >> CalulateCRC
- >> PcdComMF522

[Called By]

- >> ReadData

PcdWrite (Thumb, 150 bytes, Stack size 48 bytes, rc522.o(.text))

[Stack]

- Max Depth = 120
- Call Chain = PcdWrite ⇒ PcdComMF522 ⇒ ClearBitMask ⇒ ReadRawRC

[Calls]

- >> CalulateCRC
- >> PcdComMF522

[Called By]

- >> WriteData

PcdHalt (Thumb, 52 bytes, Stack size 36 bytes, rc522.o(.text))

[Stack]

- Max Depth = 108
- Call Chain = PcdHalt ⇒ PcdComMF522 ⇒ ClearBitMask ⇒ ReadRawRC

[Calls]

- >> CalulateCRC
- >> PcdComMF522

[Called By]

- >> main

LCD_ReadReg (Thumb, 14 bytes, Stack size 0 bytes, lcd_ili9320.o(.text), UNUSED)

[Called By]

- >> LCD_BgrMode
- >> LCD_SetAddrIncMode

LCD_WriteData (Thumb, 6 bytes, Stack size 0 bytes, lcd_ili9320.o(.text), UNUSED)

[Called By]

- >> Show_Bmp16bit
- >> LCD_AddrInc
- >> LCD_BulkReadData

LCD_Reset (Thumb, 36 bytes, Stack size 8 bytes, lcd_ili9320.o(.text))

[Stack]

- Max Depth = 8
- Call Chain = LCD_Reset

[Calls]

- >> LCD_DelayMs

[Called By]

- >> LCD_PowerOn

LCD_BlukWriteDataStart (Thumb, 10 bytes, Stack size 0 bytes, lcd_ili9320.o(.text), UNUSED)

LCD_BulkReadDataStart (Thumb, 10 bytes, Stack size 0 bytes, lcd_ili9320.o(.text), UNUSED)

LCD_BulkWriteData (Thumb, 6 bytes, Stack size 0 bytes, lcd_ili9320.o(.text), UNUSED)

LCD_BulkReadData (Thumb, 22 bytes, Stack size 8 bytes, lcd_ili9320.o(.text), UNUSED)

[Calls]

- >> LCD_WriteData
- >> LCD_ReadData

LCD_SetXY (Thumb, 30 bytes, Stack size 16 bytes, lcd_ili9320.o(.text), UNUSED)

[Calls]

- >> LCD_WriteReg
- >> LCD_WriteIndex

[Called By]

- >> Show_Bmp16bit

LCD_SetRegion (Thumb, 138 bytes, Stack size 16 bytes, lcd_ili9320.o(.text))

[Stack]

- Max Depth = 16
- Call Chain = LCD_SetRegion

[Called By]

- >> Show_Bmp16bit
- >> PutChar
- >> LCD_Fill
- >> LCD_Clear
- >> DisplayString
- >> PutNum

LCD_SetAddrIncMode (Thumb, 30 bytes, Stack size 16 bytes, lcd_ili9320.o(.text), UNUSED)

[Calls]

- >> LCD_ReadReg
- >> LCD_WriteReg

LCD_BgrMode (Thumb, 34 bytes, Stack size 16 bytes, lcd_ili9320.o(.text), UNUSED)

[Calls]

- >> LCD_ReadReg
- >> LCD_WriteReg

LCD_AddrInc (Thumb, 38 bytes, Stack size 8 bytes, lcd_ili9320.o(.text), UNUSED)

[Calls]

- >> LCD_WriteData
- >> LCD_ReadData

LCD_DrawPoint (Thumb, 32 bytes, Stack size 8 bytes, lcd_ili9320.o(.text))

[Stack]

- Max Depth = 8
- Call Chain = LCD_DrawPoint

[Called By]

- >> PutChar
- >> Draw_Circle
- >> LCD_DrawLine
- >> DisplayString

LCD_ReadPoint (Thumb, 38 bytes, Stack size 8 bytes, lcd_ili9320.o(.text), UNUSED)

LCD_DrawLine (Thumb, 176 bytes, Stack size 64 bytes, lcd_ili9320.o(.text), UNUSED)

[Calls]

- >> LCD_DrawPoint

Draw_Circle (Thumb, 198 bytes, Stack size 32 bytes, lcd_ili9320.o(.text), UNUSED)

[Calls]

- >> LCD_DrawPoint

LCD_Init (Thumb, 40 bytes, Stack size 8 bytes, lcd_ili9320.o(.text))

[Stack]

- Max Depth = 24
- Call Chain = LCD_Init ⇒ LCD_PowerOn ⇒ LCD_Reset

[Calls]

- >> LCD_Configuration
- >> LCD_FSMC_Init
- >> LCD_PowerOn
- >> LCD_DelayMs

[Called By]

- >> main

LCD_DeInit (Thumb, 8 bytes, Stack size 8 bytes, lcd_ili9320.o(.text), UNUSED)

[Calls]

- >> LCD_PowerOff

LCD_BGR2RGB (Thumb, 26 bytes, Stack size 12 bytes, lcd_ili9320.o(.text), UNUSED)

LCD_Fill (Thumb, 68 bytes, Stack size 32 bytes, lcd_ili9320.o(.text))

[Stack]

- Max Depth = 48
- Call Chain = LCD_Fill ⇒ LCD_SetRegion

[Calls]

- >> LCD_SetRegion

[Called By]

- >> Store

LCD_Clear (Thumb, 40 bytes, Stack size 16 bytes, lcd_ili9320.o(.text))

[Stack]

- Max Depth = 32
- Call Chain = LCD_Clear ⇒ LCD_SetRegion

[Calls]

- >> LCD_SetRegion

[Called By]

- >> main

PutChar (Thumb, 126 bytes, Stack size 40 bytes, lcd_ili9320.o(.text), UNUSED)

[Calls]

- >> LCD_DrawPoint
- >> LCD_SetRegion

DisplayString (Thumb, 174 bytes, Stack size 44 bytes, lcd_ili9320.o(.text))

[Stack]

- Max Depth = 60
- Call Chain = DisplayString ⇒ LCD_SetRegion

[Calls]

- >> LCD_DrawPoint
- >> LCD_SetRegion

[Called By]

- >> ShowID
- >> Store
- >> PutNum

Show_Bmp16bit (Thumb, 110 bytes, Stack size 48 bytes, lcd_ili9320.o(.text), UNUSED)

[Calls]

- >> LCD_SetXY
- >> LCD_WriteData
- >> LCD_SetRegion

__aeabi_fadd (Thumb, 164 bytes, Stack size 16 bytes, fadd.o(.text))

[Stack]

- Max Depth = 20
- Call Chain = __aeabi_fadd ⇒ _float_epilogue

[Calls]

- >> _float_round
- >> _float_epilogue

[Called By]

- >> __aeabi_frsub
- >> __aeabi_fsub

__aeabi_fsub (Thumb, 6 bytes, Stack size 0 bytes, fadd.o(.text), UNUSED)

[Calls]

- >> __aeabi_fadd

__aeabi_frsub (Thumb, 6 bytes, Stack size 0 bytes, fadd.o(.text))

[Stack]

- Max Depth = 20
- Call Chain = __aeabi_frsub ⇒ __aeabi_fadd ⇒ _float_epilogue

[Calls]

- >> __aeabi_fadd

[Called By]

- >> UART_Init

__aeabi_fmul (Thumb, 108 bytes, Stack size 8 bytes, fmul.o(.text))

[Stack]

- Max Depth = 8
- Call Chain = __aeabi_fmul

[Called By]

- >> UART_Init

__aeabi_fdiv (Thumb, 128 bytes, Stack size 8 bytes, fdiv.o(.text))

[Stack]

- Max Depth = 8
- Call Chain = __aeabi_fdiv

[Calls]

- >> _float_round

[Called By]

- >> UART_Init

__aeabi_ui2f (Thumb, 10 bytes, Stack size 0 bytes, ffltui.o(.text))

[Stack]

- Max Depth = 4
- Call Chain = __aeabi_ui2f ⇒ _float_epilogue

[Calls]

- >> _float_epilogue

[Called By]

- >> UART_Init

__aeabi_f2uiz (Thumb, 40 bytes, Stack size 0 bytes, ffixui.o(.text))

[Called By]

- >> UART_Init

__aeabi_uldivmod (Thumb, 102 bytes, Stack size 40 bytes, uldiv.o(.text), UNUSED)

[Calls]

- >> __aeabi_llsr
- >> __aeabi_llsl

[Called By]

- >> _printf_core

__I$use$fp (Thumb, 0 bytes, Stack size 0 bytes, iusefp.o(.text), UNUSED)

_float_round (Thumb, 18 bytes, Stack size 0 bytes, fepilogue.o(.text))

[Called By]

- >> __aeabi_fdiv
- >> __aeabi_fadd

_float_epilogue (Thumb, 94 bytes, Stack size 4 bytes, fepilogue.o(.text))

[Stack]

- Max Depth = 4
- Call Chain = _float_epilogue

[Called By]

- >> __aeabi_ui2f
- >> __aeabi_fadd

__scatterload (Thumb, 28 bytes, Stack size 0 bytes, init.o(.text))

[Calls]

- >> __main_after_scatterload

[Called By]

- >> _main_scatterload

__scatterload_rt2 (Thumb, 0 bytes, Stack size 0 bytes, init.o(.text), UNUSED)

__aeabi_llsl (Thumb, 30 bytes, Stack size 0 bytes, llshl.o(.text), UNUSED)

[Called By]

- >> __aeabi_uldivmod

_ll_shift_l (Thumb, 0 bytes, Stack size 0 bytes, llshl.o(.text), UNUSED)

__aeabi_llsr (Thumb, 32 bytes, Stack size 0 bytes, llushr.o(.text), UNUSED)

[Called By]

- >> __aeabi_uldivmod

_ll_ushift_r (Thumb, 0 bytes, Stack size 0 bytes, llushr.o(.text), UNUSED)

__0printf$8 (Thumb, 22 bytes, Stack size 24 bytes, printf8.o(i.__0printf$8), UNUSED)

[Calls]

- >> _printf_core

__1printf$8 (Thumb, 0 bytes, Stack size 24 bytes, printf8.o(i.__0printf$8), UNUSED)

__2printf (Thumb, 0 bytes, Stack size 24 bytes, printf8.o(i.__0printf$8))

[Stack]

- Max Depth = 24
- Call Chain = __2printf

[Called By]

- >> main

__scatterload_copy (Thumb, 14 bytes, Stack size unknown bytes, handlers.o(i.__scatterload_copy), UNUSED)

__scatterload_null (Thumb, 2 bytes, Stack size unknown bytes, handlers.o(i.__scatterload_null), UNUSED)

__scatterload_zeroinit (Thumb, 14 bytes, Stack size unknown bytes, handlers.o(i.__scatterload_zeroinit), UNUSED)

### Local Symbols

LCD_DelayMs (Thumb, 22 bytes, Stack size 0 bytes, lcd_ili9320.o(.text))

[Called By]

- >> LCD_Reset
- >> LCD_PowerOn
- >> LCD_Init

LCD_WriteIndex (Thumb, 8 bytes, Stack size 0 bytes, lcd_ili9320.o(.text), UNUSED)

[Called By]

- >> LCD_SetXY

LCD_WriteReg (Thumb, 12 bytes, Stack size 0 bytes, lcd_ili9320.o(.text))

[Called By]

- >> LCD_BgrMode
- >> LCD_SetAddrIncMode
- >> LCD_SetXY
- >> LCD_PowerOn

LCD_ReadData (Thumb, 6 bytes, Stack size 0 bytes, lcd_ili9320.o(.text), UNUSED)

[Called By]

- >> LCD_AddrInc
- >> LCD_BulkReadData

LCD_PowerOn (Thumb, 502 bytes, Stack size 8 bytes, lcd_ili9320.o(.text))

[Stack]

- Max Depth = 16
- Call Chain = LCD_PowerOn ⇒ LCD_Reset

[Calls]

- >> LCD_Reset
- >> LCD_WriteReg
- >> LCD_DelayMs

[Called By]

- >> LCD_Init

LCD_PowerOff (Thumb, 2 bytes, Stack size 0 bytes, lcd_ili9320.o(.text), UNUSED)

[Called By]

- >> LCD_DeInit

LCD_FSMC_Init (Thumb, 50 bytes, Stack size 0 bytes, lcd_ili9320.o(.text))

[Called By]

- >> LCD_Init

LCD_Configuration (Thumb, 180 bytes, Stack size 0 bytes, lcd_ili9320.o(.text))

[Called By]

- >> LCD_Init

_printf_core (Thumb, 1064 bytes, Stack size 104 bytes, printf8.o(i._printf_core), UNUSED)

[Calls]

- >> _printf_pre_padding
- >> _printf_post_padding
- >> __aeabi_uldivmod

[Called By]

- >> __0printf$8

_printf_post_padding (Thumb, 38 bytes, Stack size 24 bytes, printf8.o(i._printf_post_padding), UNUSED)

[Called By]

- >> _printf_core

_printf_pre_padding (Thumb, 46 bytes, Stack size 24 bytes, printf8.o(i._printf_pre_padding), UNUSED)

[Called By]

- >> _printf_core

### Undefined Global Symbols
