valeb/Projekt/Dokumentation/Bottom.pdf

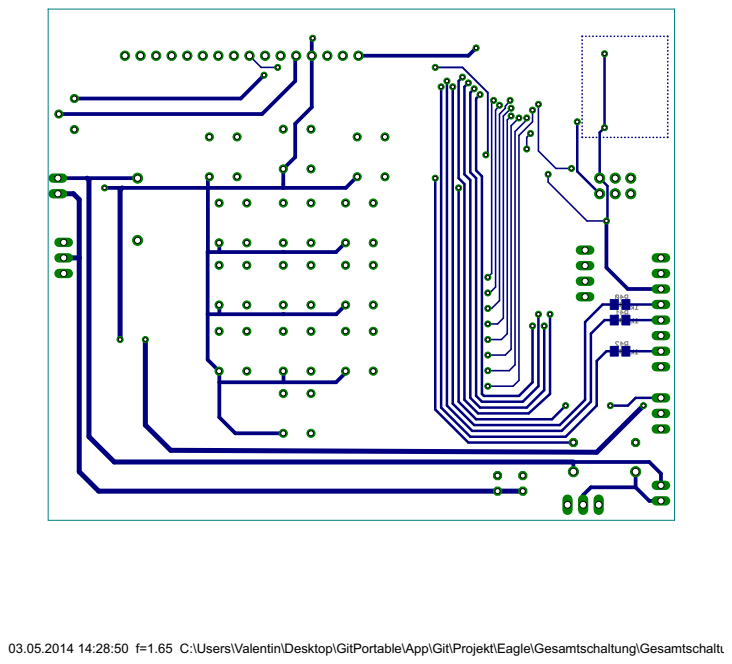
[picture p47: page 1]

03.05.2014 14:28:50 f=1.65 C:\Users\Valentin\Desktop\GitPortable\App\Git\Projekt\Eagle\Gesamtschaltung\Gesamtschaltung.brd
