valeb/Projekt/Dokumentation/tInfo.pdf

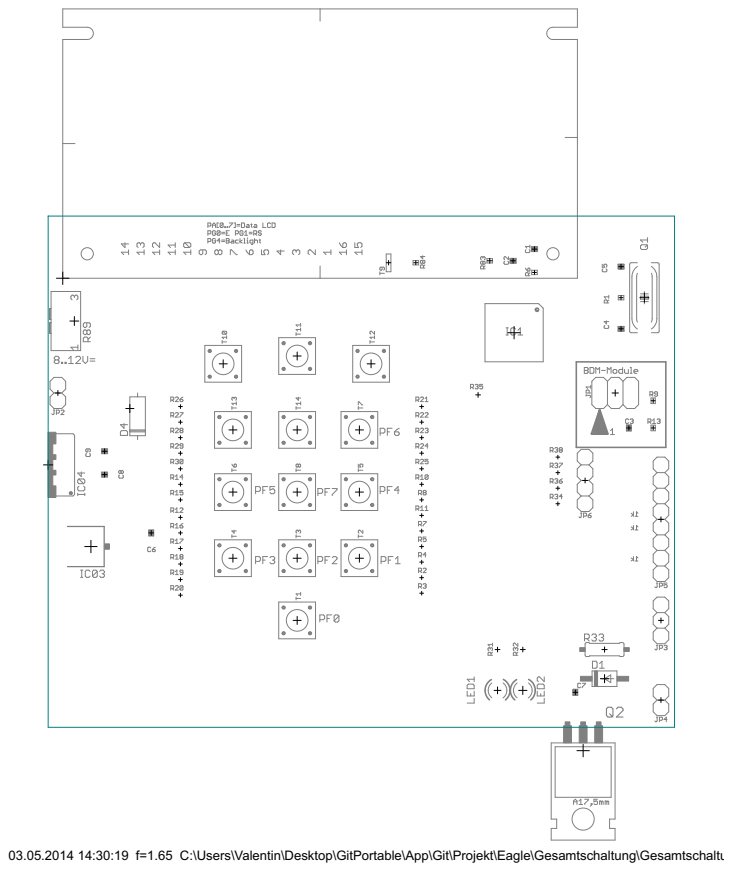
[picture p48: page 1]

03.05.2014 14:30:19 f=1.65 C:\Users\Valentin\Desktop\GitPortable\App\Git\Projekt\Eagle\Gesamtschaltung\Gesamtschaltung.brd
