valeb/Projekt/Dokumentation/Top.pdf

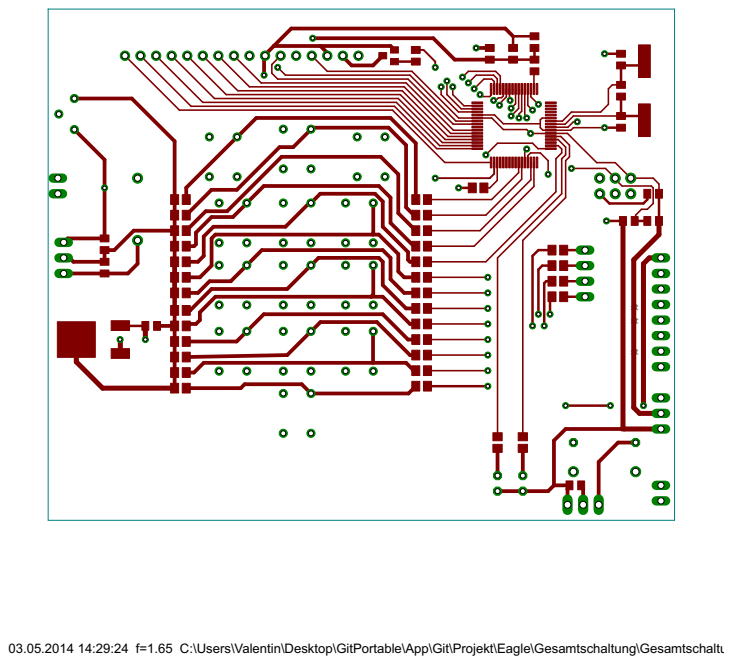
[picture p49: page 1]

03.05.2014 14:29:24 f=1.65 C:\Users\Valentin\Desktop\GitPortable\App\Git\Projekt\Eagle\Gesamtschaltung\Gesamtschaltung.brd
