valeb/Projekt/Datenblätter/RFID-MC522/Ú¦¦ÕÁîþöÁÕ¡ÉÕ¦äÚóæµ¿íÕØùÞÁäµûÖ/MFRC522_STC_NO12864/PROTEL/MFRC522_ANT.pdf

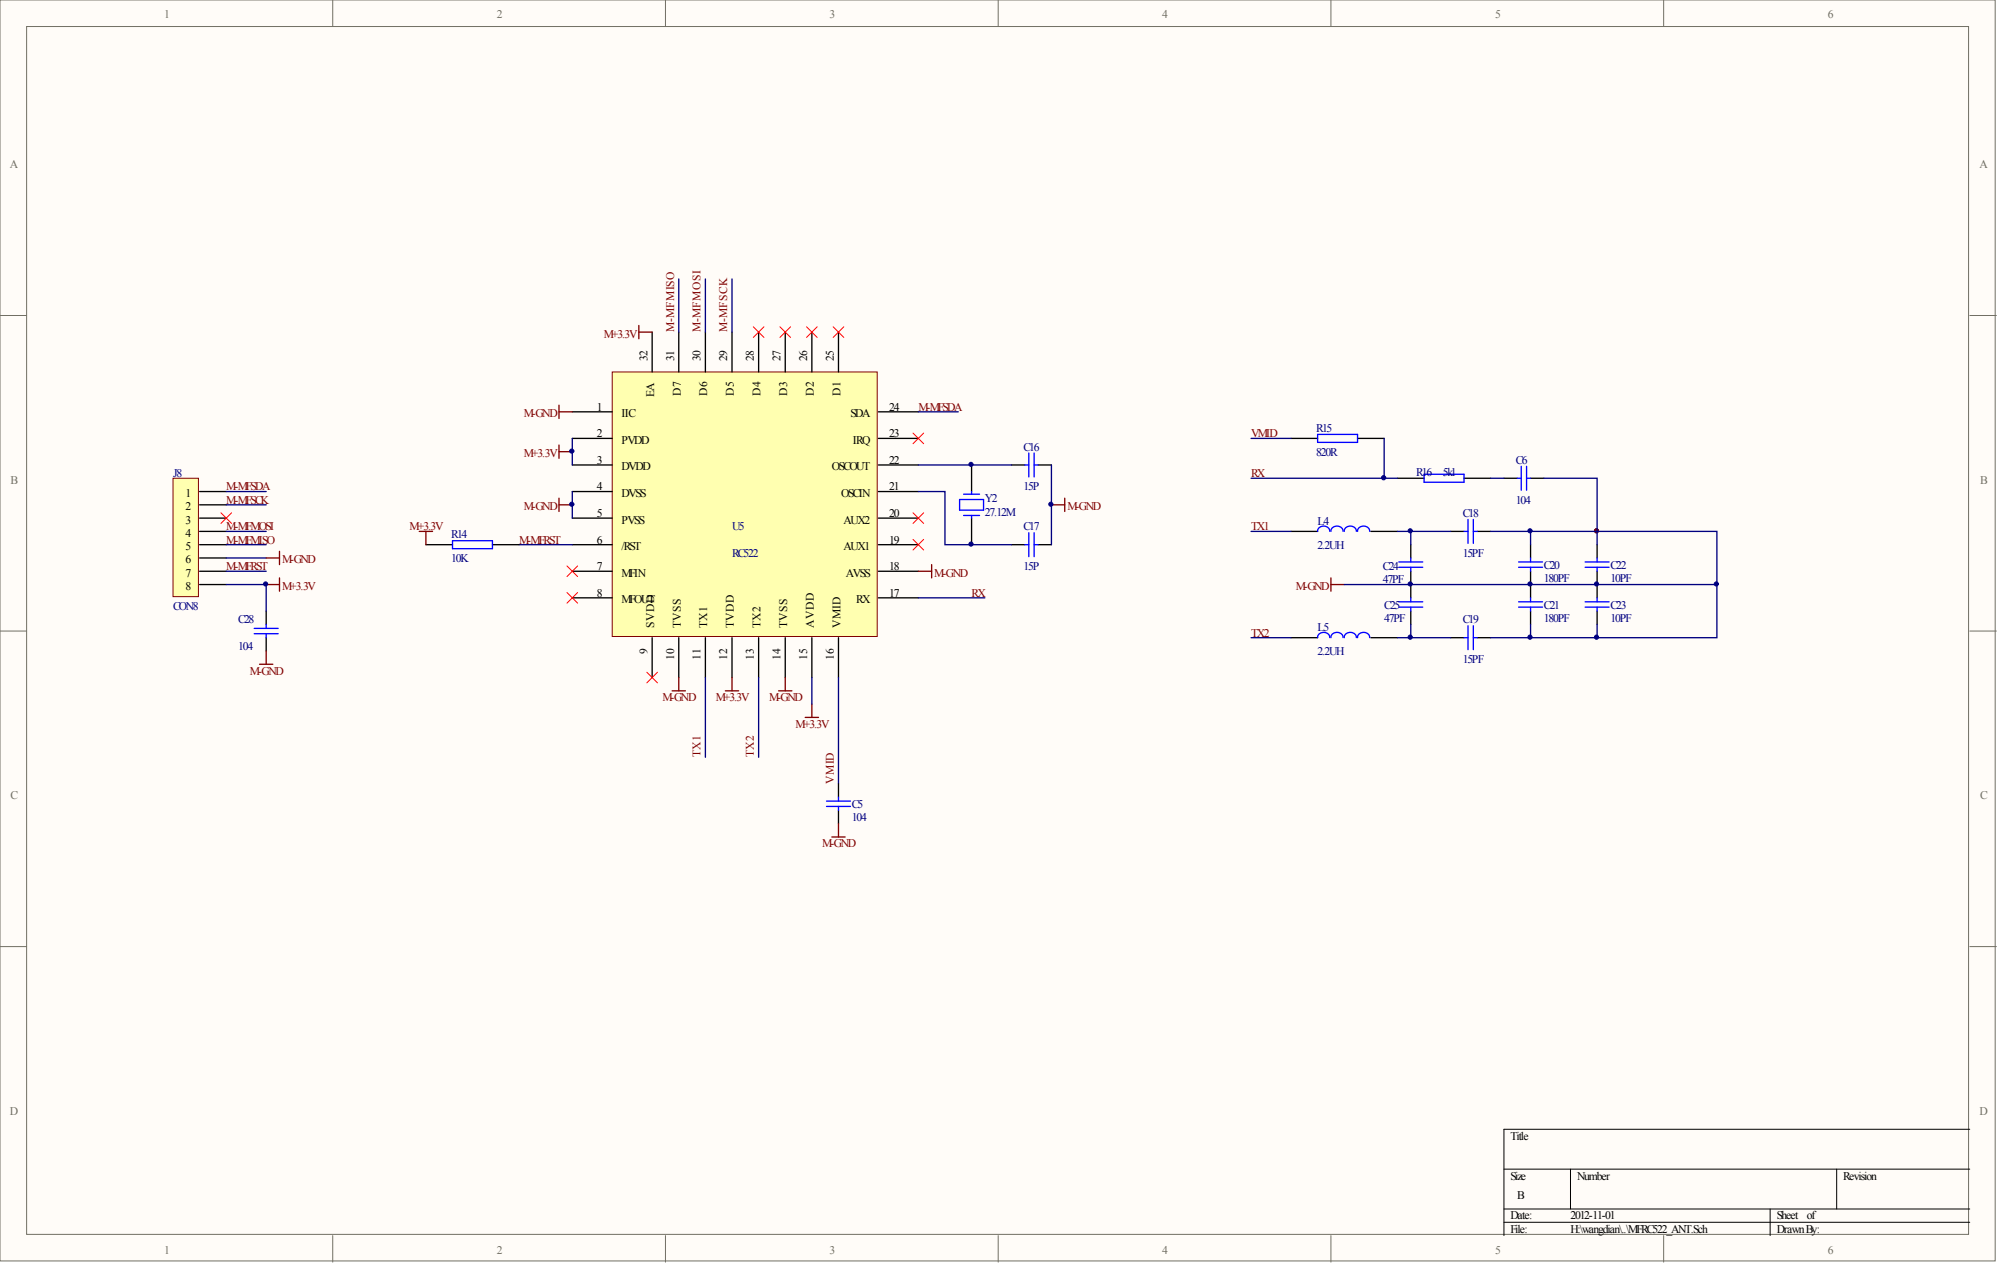
[picture p50: page 1]
