valeb/Projekt/Datenblätter/RFID-MC522/Ú¦¦ÕÁîþöÁÕ¡ÉÕ¦äÚóæµ¿íÕØùÞÁäµûÖ/MFRC522_STC_NO12864/PROTEL/MFRC522_STC.pdf

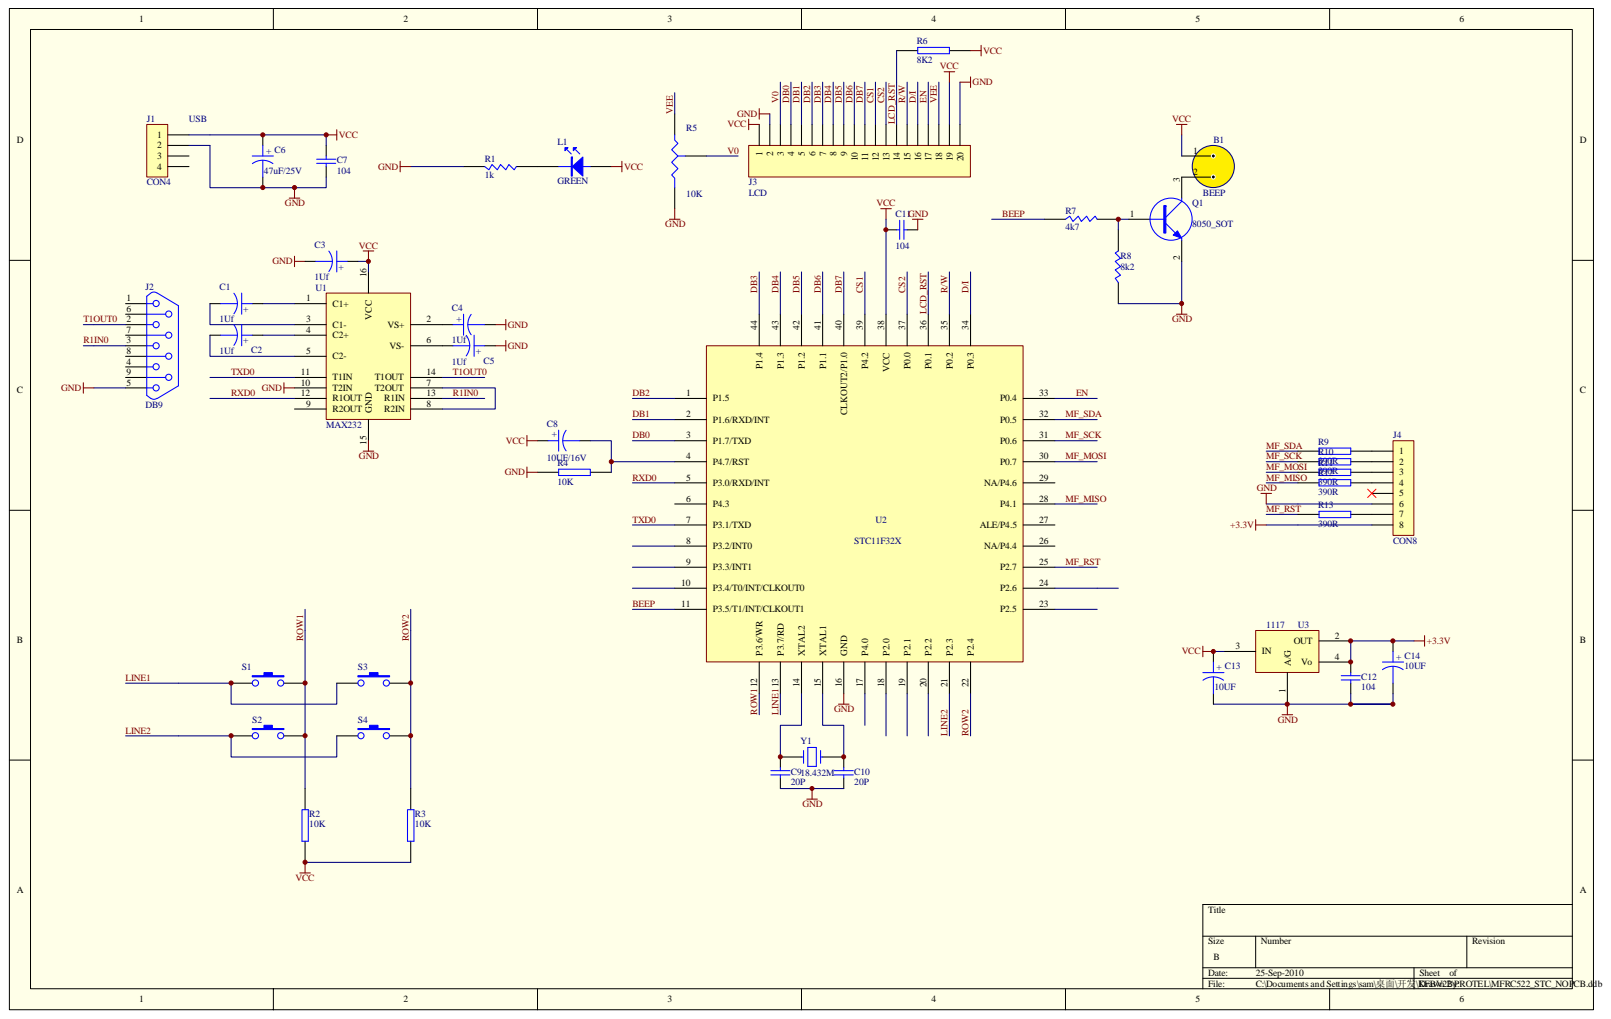
[picture p51: page 1]

Size B | Number | Revision

Date: 25-Sep-2010 | Sheet of
File: C:\Documents and Settings\sam\桌面\开发\KFBV22\PROTEL\MFRC522_STC_NOPCB.ddb Drawn By:
