valeb/Projekt/Eagle/Gesamtschaltung/Gesamtschaltung.brd

## EAGLE design Eagle/Gesamtschaltung/Gesamtschaltung.brd (2014-05-08)

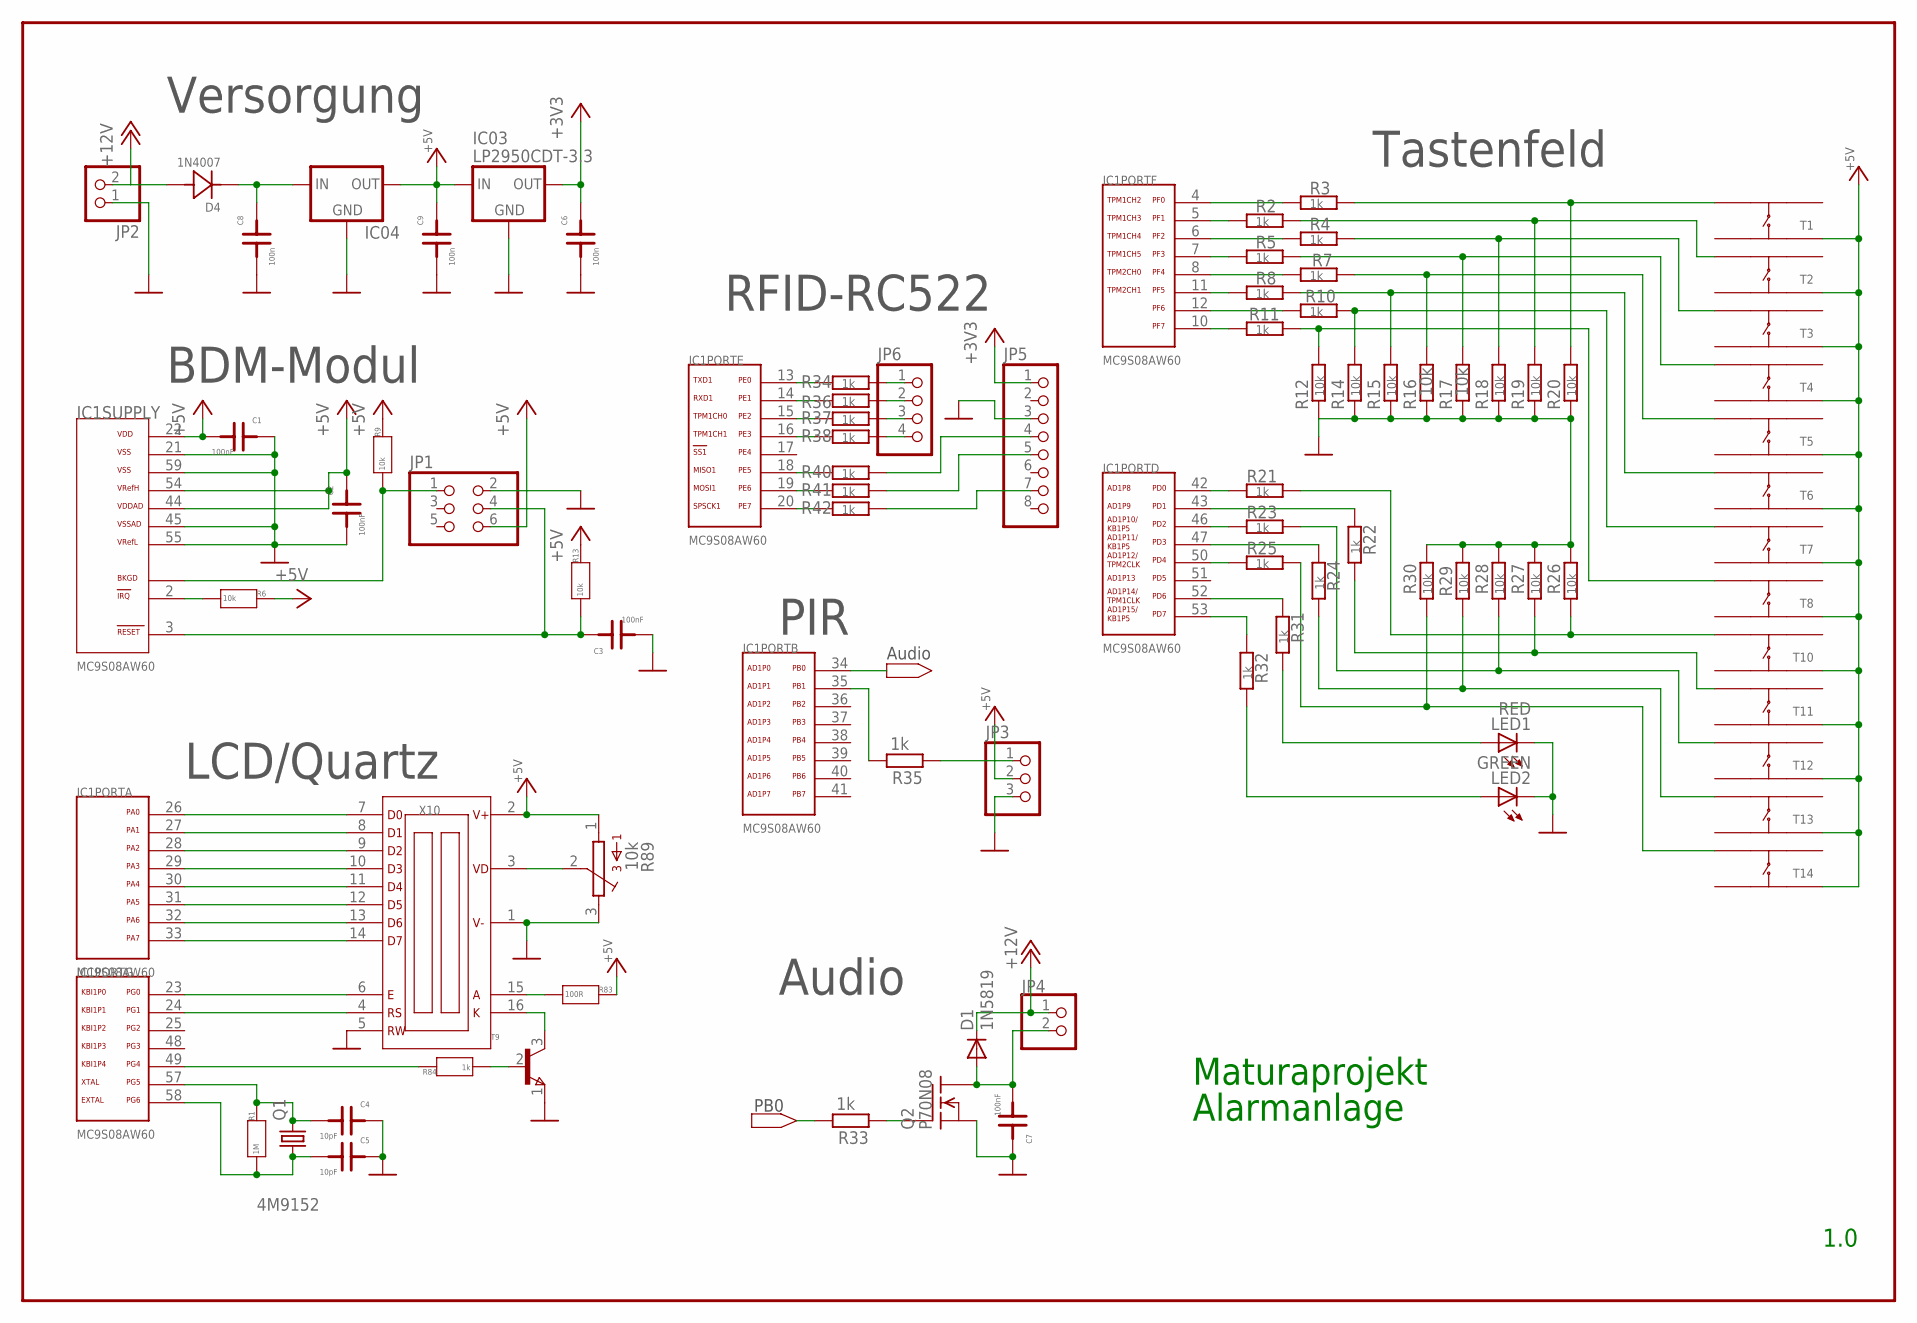
[picture p52: schematic Gesamtschaltung.sch]

Parts:
C1, C2, C3, C7: 100nF; 0805F
C4, C5: 10pF; 0805F
C6, C8, C9: 100n; 0805F
D1: 1N5819; DO41-10
D4: 1N4007; D400BH
IC1: MC9S08AW60; LQFP64
IC03: LP2950CDT-3.3; DPACK
IC04: 78XXS
JP1: PINHD-2X3; 2X03
JP2, JP4: PINHD-1X2; 1X02
JP3: PINHD-1X3; 1X03
JP5: PINHD-1X8; 1X08
JP6: PINHD-1X4; 1X04
LED1: RED; LED3MM
LED2: GREEN; LED3MM
Q1: 4M9152; HC49UP
Q2: P70N08; TO220
R1: 1M; 0805
R2, R3, R4, R5, R7, R8, R10, R11, R21, R22, R23, R24, R25, R34, R35, R36, R37, R38, R40, R41, R42: 1k; M0805
R6, R9, R13: 10k; 0805
R12, R14, R15, R16, R17, R18, R19, R20, R26, R27, R28, R29, R30: 10k; M0805
R31, R32: 1k; R0805
R33: 1k; 0207/10
R83: 100R; 0805
R84: 1k; 0805
R89: 10k; S63X
T1, T2, T3, T4, T5, T6, T7, T8, T10, T11, T12, T13, T14: TASTERTHT; TASTE_THT
T9: BC817; SOT-23
X10: FDCC1602E

Connections:
+3V3: C6.2, IC03.3 (OUT), JP5.1
+5V: C1.1, C2.2, C9.2, IC1.22 (VDD), IC1.44 (VDDAD), IC1.54 (VREFH), IC03.1 (IN), IC04.OUT, JP1.6, JP3.2, R6.2, R9.2, R13.2, R83.2, R89.1, T1.A1, T2.A1, T3.A1, T4.A1, T5.A1, T6.A1, T7.A1, T8.A1, T10.A1, T11.A1, T12.A1, T13.A1, T14.A1, X10.2 (V+)
+12V: D1.C, D4.A, JP2.2, JP4.1
BKGD: IC1.56 (BKGD), JP1.1, R9.1
D0: IC1.26 (PA0), X10.7 (D0)
D1: IC1.27 (PA1), X10.8 (D1)
D2: IC1.28 (PA2), X10.9 (D2)
D3: IC1.29 (PA3), X10.10 (D3)
GND: C1.2, C2.1, C3.1, C4.2, C5.2, C6.1, C7.2, C8.1, C9.1, IC1.21 (VSS), IC1.45 (VSSAD), IC1.55 (VREFL), IC1.59 (VSS2), IC03.4 (GND), IC04.GND, JP1.2, JP2.1, JP3.3, JP5.3, LED1.K (C), LED2.K (C), Q2.3 (S), R12.1, R14.1, R15.1, R16.1, R17.1, R18.1, R19.1, R20.1, R26.2, R27.2, R28.2, R29.2, R30.2, R89.3, T9.1 (E), X10.1 (V-), X10.5 (RW)
IRQ: IC1.2 (IRQ/), R6.1
LCD_LED: IC1.49 (PG4), R84.2
unnamed: C8.2, D4.K, IC04.IN
unnamed: R3.2, R20.2, T1.B2
unnamed: R2.2, R19.2, T2.B2
unnamed: IC1.42 (PD0), R21.1
unnamed: R4.2, R18.2, T3.B2
unnamed: R5.2, R17.2, T4.B2
unnamed: R7.2, R16.2, T5.B2
unnamed: IC1.46 (PD2), R23.1
unnamed: IC1.50 (PD4), R25.1
unnamed: R21.2, R26.1, T10.B2
unnamed: R8.2, R15.2, T6.B2
unnamed: R10.2, R14.2, T7.B2
unnamed: R11.2, R12.2, T8.B2
unnamed: IC1.5 (PF1), R2.1
unnamed: IC1.6 (PF2), R4.1
unnamed: C4.1, IC1.57 (PG5), Q1.2, R1.2
unnamed: IC1.43 (PD1), R22.1
unnamed: IC1.47 (PD3), R24.1
unnamed: R22.2, R27.1, T11.B2
unnamed: IC1.53 (PD7), R32.1
unnamed: IC1.7 (PF3), R5.1
unnamed: C5.1, IC1.58 (PG6), Q1.1, R1.1
unnamed: IC1.8 (PF4), R7.1
unnamed: IC1.11 (PF5), R8.1
unnamed: IC1.12 (PF6), R10.1
unnamed: IC1.10 (PF7), R11.1
unnamed: IC1.4 (PF0), R3.1
unnamed: R24.2, R29.1, T13.B2
unnamed: IC1.52 (PD6), R31.1
unnamed: R23.2, R28.1, T12.B2
unnamed: R25.2, R30.1, T14.B2
unnamed: IC1.13 (PE0), R34.1
unnamed: LED2.A, R32.2
unnamed: LED1.A, R31.2
unnamed: JP5.7, R42.2
unnamed: IC1.34 (PB0), R33.2
unnamed: JP3.1, R35.1
unnamed: JP5.5, R41.2
unnamed: JP5.4, R40.2
unnamed: Q2.1 (G), R33.1
unnamed: IC1.35 (PB1), R35.2
unnamed: IC1.14 (PE1), R36.1
unnamed: IC1.15 (PE2), R37.1
unnamed: IC1.16 (PE3), R38.1
unnamed: JP6.4, R38.2
unnamed: C7.1, D1.A, JP4.2, Q2.2 (D)
unnamed: IC1.18 (PE5), R40.1
unnamed: IC1.19 (PE6), R41.1
unnamed: IC1.30 (PA4), X10.11 (D4)
unnamed: IC1.31 (PA5), X10.12 (D5)
unnamed: IC1.32 (PA6), X10.13 (D6)
unnamed: IC1.33 (PA7), X10.14 (D7)
unnamed: IC1.20 (PE7), R42.1
unnamed: JP6.3, R37.2
unnamed: IC1.23 (PG0), X10.6 (E)
unnamed: JP6.2, R36.2
unnamed: JP6.1, R34.2
unnamed: IC1.24 (PG1), X10.4 (RS)
unnamed: R89.2, X10.3 (VD)
unnamed: R83.1, X10.15 (A)
unnamed: T9.3 (C), X10.16 (K)
unnamed: R84.1, T9.2 (B)
RESET: C3.2, IC1.3 (RST/), JP1.4, R13.1

Notes on the sheet:
Maturaprojekt
Alarmanlage
1.0
Tastenfeld
Versorgung
BDM-Modul
LCD/Quartz
PIR
RFID-RC522
Audio
PB0

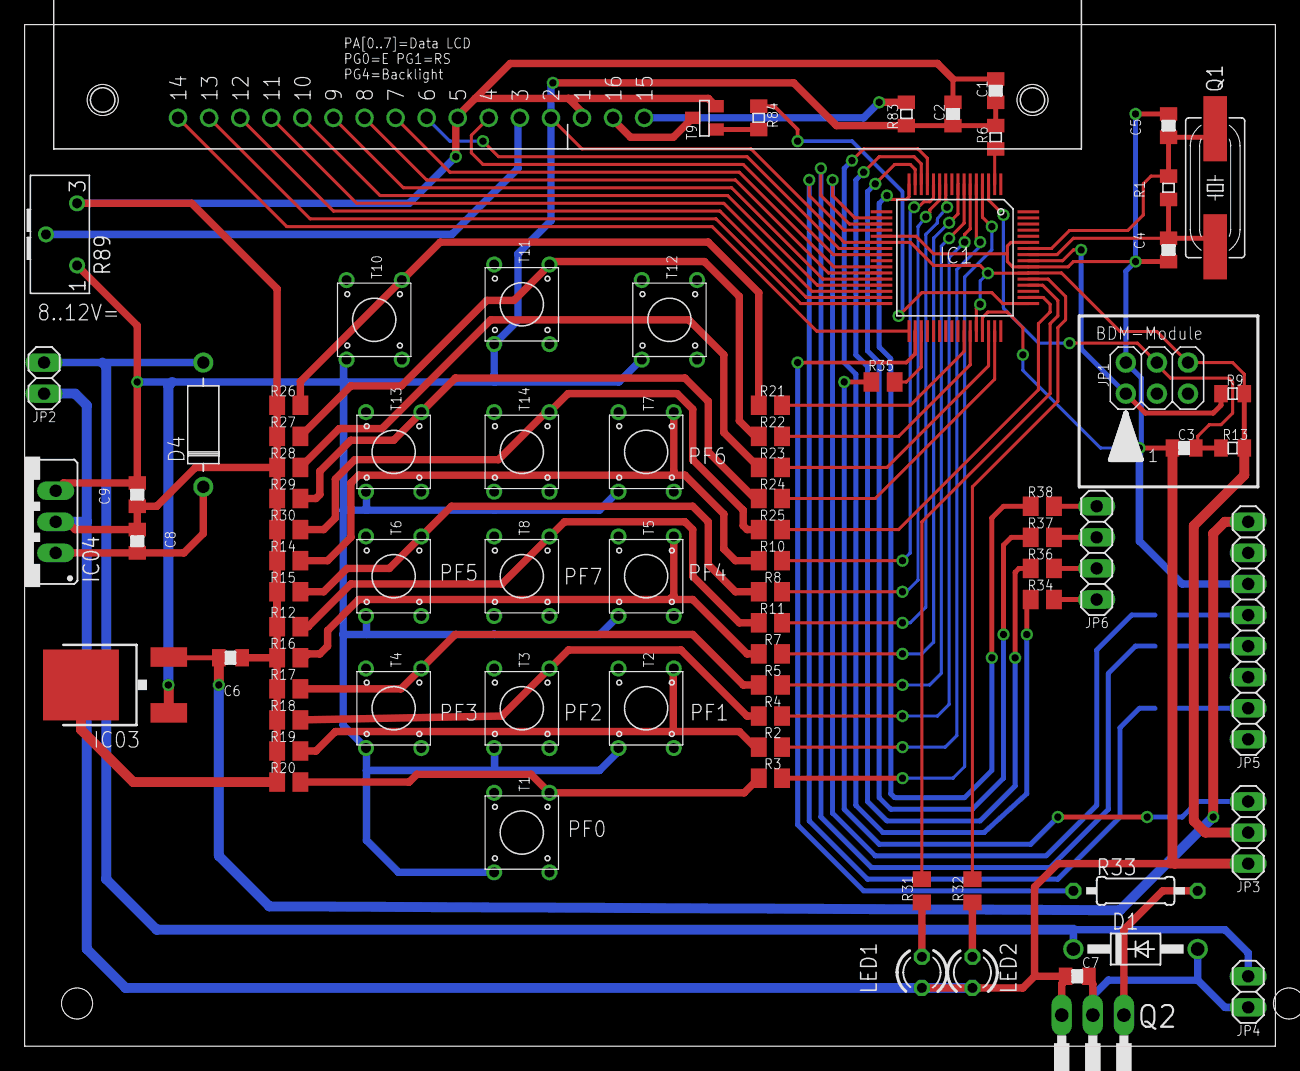
[picture p53: board Gesamtschaltung.brd from above]

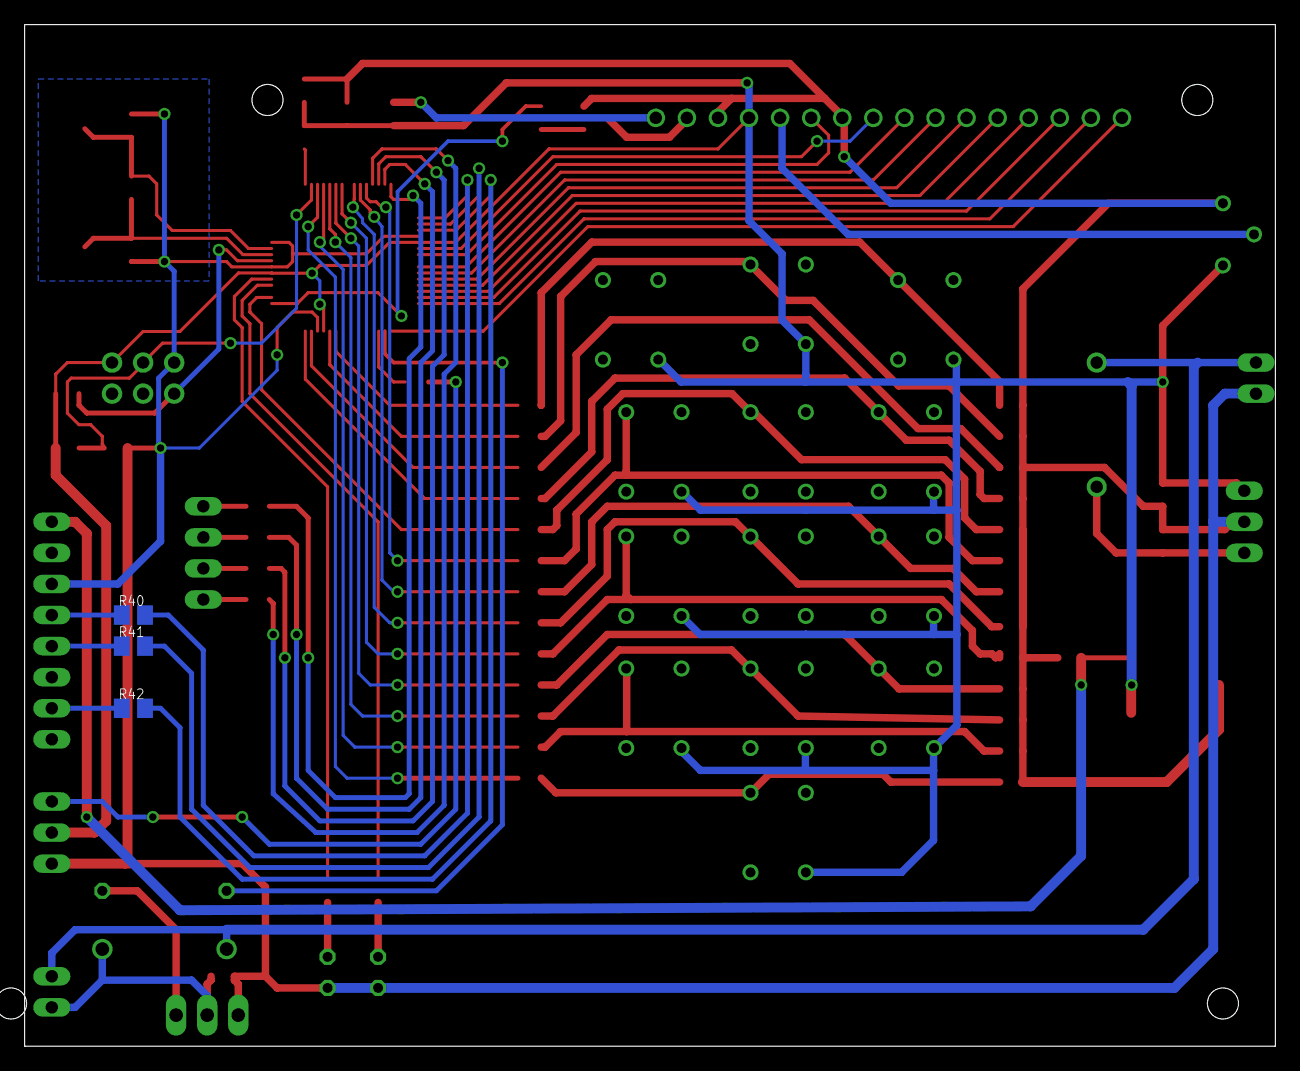
[picture p54: board Gesamtschaltung.brd from below]

Board: 2 copper layers, 102.2 x 83.5 mm, 83 parts (3 on the bottom side), 74 nets.
