valeb/Projekt/Eagle/Board Fertig/Alarmanlage_V40.brd

## EAGLE design Eagle/Board Fertig/Alarmanlage_V40.brd (2014-05-02, an earlier design)

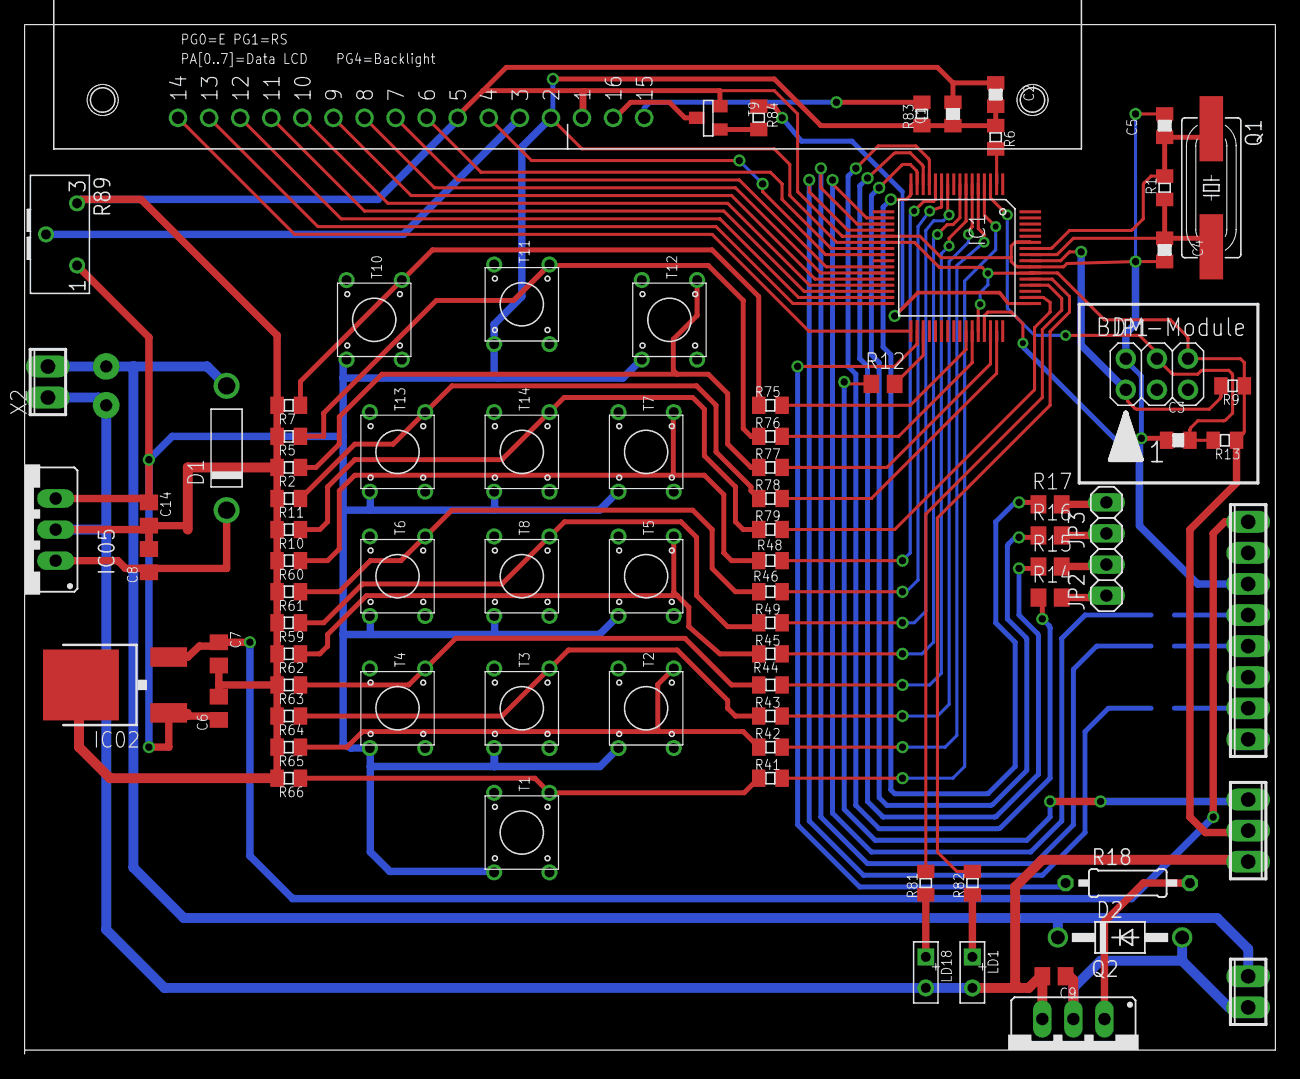
[picture p55: board Alarmanlage_V40.brd from above]

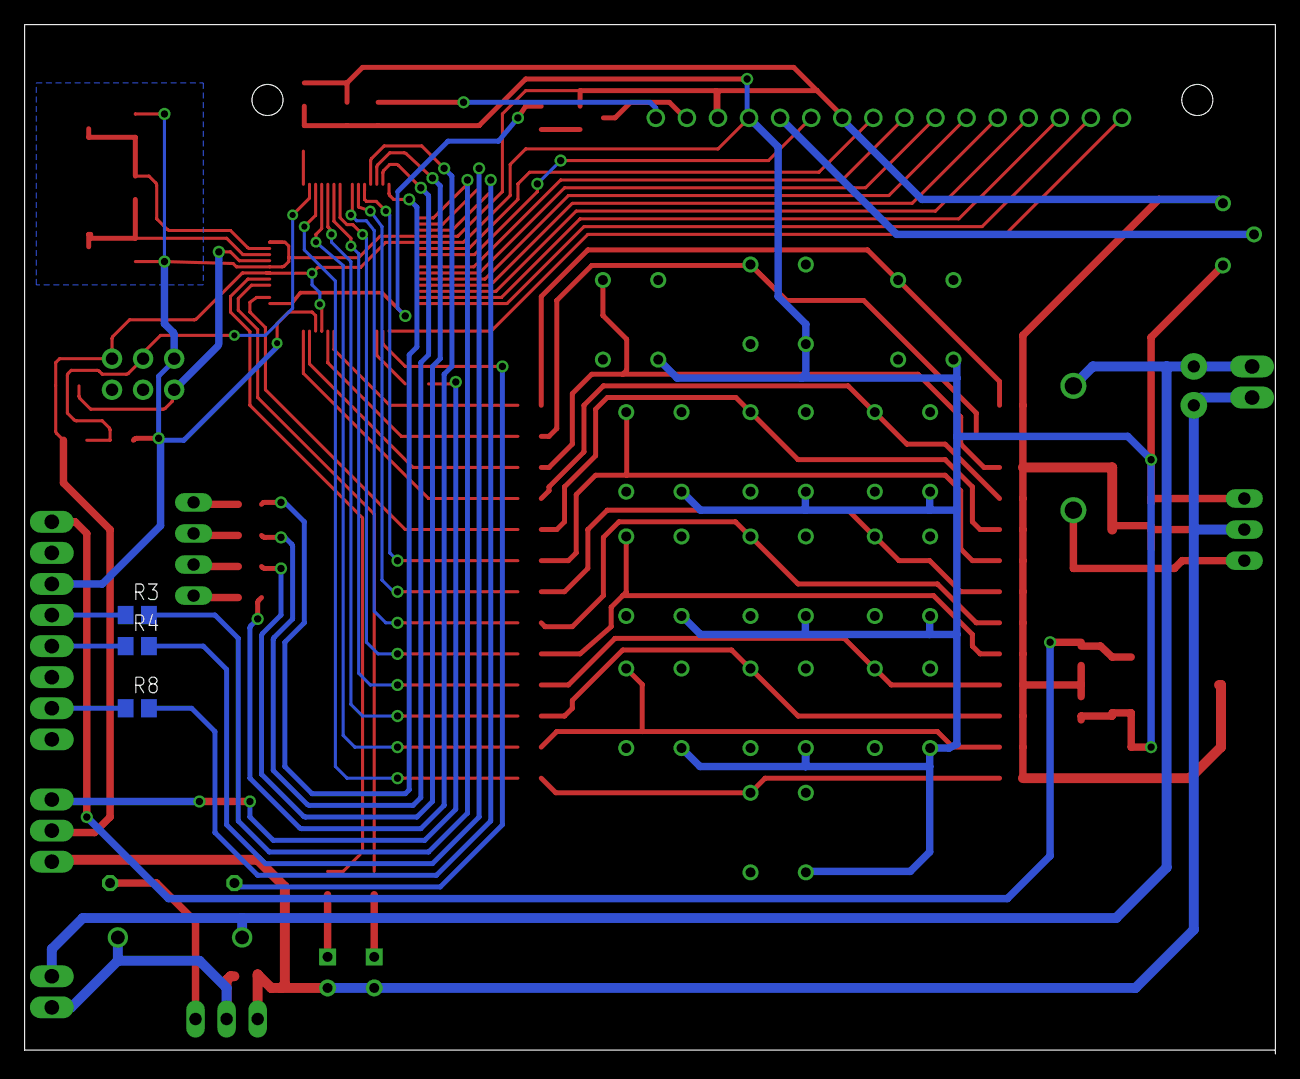
[picture p56: board Alarmanlage_V40.brd from below]

Board: 2 copper layers, 102.2 x 83.8 mm, 85 parts (3 on the bottom side), 74 nets.

Parts:
C1, C2, C3: 100nF; 0805F
C4, C5: 10pF; 0805F
C6, C8: 330nF; C0805
C7, C9, C14: 100nF; C0805
D1: 1N4007; DO201
D2: 1N4004; DO41-10
IC1: MC9S08AW60; LQFP64
IC02: 3.3V; DPACK
IC05: 5V; TO-220_V
JP1: 2X03
JP2, JP3: 1X02
LD1: GREEN; LED2X5MM
LD18: RED; LED2X5MM
Q1: 4M9152; HC49UP
Q2: P5N50D; TO-220_V
R1: 1M; 0805
R2, R5, R6, R7, R9, R10, R11, R13, R59, R60, R61, R62, R63, R64, R65, R66: 10k; 0805
R3, R4, R8: R0805
R12, R14, R15, R16, R17: 1k; R0805
R18: 0207/10
R41, R42, R43, R44, R45, R46, R48, R49, R75, R76, R77, R78, R79, R81, R82, R84: 1k; 0805
R83: 100R; 0805
R89: 10k; S63X
T1, T2, T3, T4, T5, T6, T7, T8, T10, T11, T12, T13, T14: TASTE_THT
T9: SOT-23
X1: 8POL254
X2, X3: 2POL254
X4: 3POL254
X10: FDCC1602E

Connections:
+3V3: C7.1, IC02.3, X1.8
+5V: C1.1, C2.2, C6.1, C14.1, IC1.22, IC1.44, IC1.54, IC02.1, IC05.OUT, JP1.6, R6.2, R9.2, R13.2, R83.2, R89.1, T1.A1, T2.A1, T3.A1, T4.A1, T5.A1, T6.A1, T7.A1, T8.A1, T10.A1, T11.A1, T12.A1, T13.A1, T14.A1, X4.2, X10.2
+12V: D1.A, D2.C, X2.2, X3.2
BKGD: IC1.56, JP1.1, R9.1
D0: IC1.26, X10.7
D1: IC1.27, X10.8
D2: IC1.28, X10.9
D3: IC1.29, X10.10
GND: C1.2, C2.1, C3.1, C4.2, C5.2, C6.2, C7.2, C8.2, C9.2, C14.2, IC1.21, IC1.45, IC1.55, IC1.59, IC02.4, IC05.GND, JP1.2, LD1.1, LD18.1, Q2.OUT, R2.1, R5.1, R7.1, R10.1, R11.1, R59.1, R60.1, R61.1, R62.1, R63.1, R64.1, R65.1, R66.1, R89.3, T9.1, X1.6, X2.1, X4.3, X10.1, X10.5
IRQ: IC1.2, R6.1
LCD_LED: IC1.49, R84.2
unnamed: R3.2, X1.5
unnamed: C8.1, D1.K, IC05.IN
unnamed: IC1.20, R8.1
unnamed: IC1.42, R75.1
unnamed: IC1.19, R4.1
unnamed: IC1.18, R3.1
unnamed: IC1.43, R76.1
unnamed: IC1.46, R77.1
unnamed: IC1.47, R78.1
unnamed: R49.2, R59.2, T8.B2
unnamed: IC1.50, R79.1
unnamed: R7.2, R75.2, T10.B2
unnamed: R4.2, X1.4
unnamed: C4.1, IC1.57, Q1.2, R1.2
unnamed: IC1.52, R81.1
unnamed: IC1.53, R82.1
unnamed: R8.2, X1.2
unnamed: R5.2, R76.2, T11.B2
unnamed: IC1.12, R48.1
unnamed: C5.1, IC1.58, Q1.1, R1.1
unnamed: IC1.11, R46.1
unnamed: IC1.4, R41.1
unnamed: R12.2, X4.1
unnamed: LD1.2, R82.2
unnamed: IC1.13, R14.2
unnamed: C9.1, D2.A, Q2.GND, X3.1
unnamed: R11.2, R78.2, T13.B2
unnamed: LD18.2, R81.2
unnamed: IC1.35, R12.1
unnamed: IC1.14, R15.2
unnamed: R10.2, R79.2, T14.B2
unnamed: IC1.15, R16.2
unnamed: R45.2, R62.2, T5.B2
unnamed: IC1.34, R18.1
unnamed: R48.2, R60.2, T7.B2
unnamed: IC1.16, R17.2
unnamed: JP2.1, R14.1
unnamed: JP2.2, R15.1
unnamed: JP3.1, R16.1
unnamed: IC1.10, R49.1
unnamed: JP3.2, R17.1
unnamed: Q2.IN, R18.2
unnamed: IC1.5, R42.1
unnamed: IC1.6, R43.1
unnamed: IC1.7, R44.1
unnamed: IC1.8, R45.1
unnamed: IC1.30, X10.11
unnamed: IC1.31, X10.12
unnamed: IC1.32, X10.13
unnamed: IC1.33, X10.14
unnamed: IC1.23, X10.6
unnamed: IC1.24, X10.4
unnamed: R89.2, X10.3
unnamed: R46.2, R61.2, T6.B2
unnamed: R44.2, R63.2, T4.B2
unnamed: R43.2, R64.2, T3.B2
unnamed: R42.2, R65.2, T2.B2
unnamed: R41.2, R66.2, T1.B2
unnamed: R2.2, R77.2, T12.B2
unnamed: R83.1, X10.15
unnamed: T9.3, X10.16
unnamed: R84.1, T9.2
RESET: C3.2, IC1.3, JP1.4, R13.1
