valeb/Projekt/Eagle/Gesamtschaltung/Demoboard_Reste.brd

## EAGLE design Eagle/Gesamtschaltung/Demoboard_Reste.brd (2014-04-27)

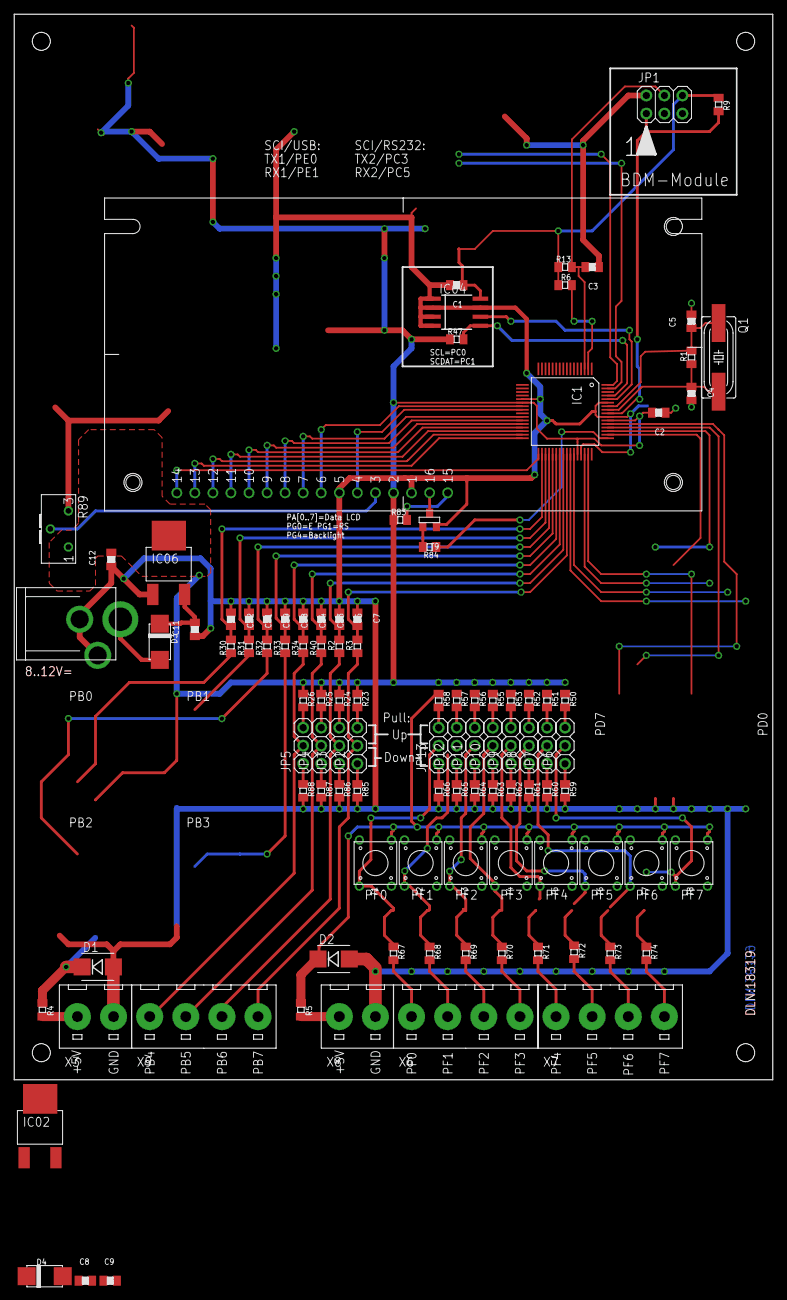
[picture p57: board Demoboard_Reste.brd from above]

Board: 2 copper layers, 106.7 x 149.9 mm, 105 parts (0 on the bottom side), 81 nets.

Parts:
C1, C2, C3: 100nF; 0805F
C4, C5: 10pF; 0805F
C6, C7, C13, C14, C18, C19, C21, C22: 10nF; 0805F
C8, C9, C11, C12: 1µF; 0805F
D1, D2: SA5.0CA; SMB
D3, D4: 1N4007; MELF_B
IC1: MC9S08AW60; LQFP64
IC02, IC06: LM1117-5.0; DPAK
IC04: 24LC256; SO-08M
JP1: 2X03
JP2, JP3, JP4, JP5, JP6, JP7, JP8, JP9, JP10, JP11, JP12, JP13: 1X03
Q1: 4M9152; HC49UP
R1: 1M; 0805
R2, R3, R6, R9, R13, R23, R24, R25, R26, R30, R31, R32, R33, R34, R40, R50, R51, R52, R53, R55, R56, R57, R58, R59, R60, R61, R62, R63, R64, R65, R66, R85, R86, R87, R88: 10k; 0805
R4, R5: 27R; 0805
R47: 680R; 0805
R67, R68, R69, R70, R71, R72, R73, R74, R83: 100R; 0805
R84: 1k; 0805
R89: 10k; S63X
T1, T2, T3, T4, T5, T6, T7, T8: TASTE_THT
T9: SOT-23
X3, X8: KLEMME2
X4: SPP
X6, X7, X9: KLEMME4
X10: FDCC1602E

Connections:
+5V: C1.1, C2.2, C9.2, C12.2, D1.C, D2.C, IC1.22, IC1.44, IC1.54, IC02.4, IC04.8, IC06.4, JP1.6, R4.2, R5.2, R6.2, R9.2, R13.2, R23.2, R24.2, R25.2, R26.2, R47.2, R83.2, R89.1, T1.A1, T2.A1, T3.A1, T4.A1, T5.A1, T6.A1, T7.A1, T8.A1, X10.2
ADCPB0: C22.2, IC1.34, R30.1
ADCPB1: C21.2, IC1.35, R31.1
ADCPB2: C19.2, IC1.36, R32.1
ADCPB3: C18.2, IC1.37, R33.1
ADCPB4: C14.2, IC1.38, R34.1
ADCPB5: C13.2, IC1.39, R40.1
ADCPB6: C6.2, IC1.40, R2.1
ADCPB7: C7.2, IC1.41, R3.1
ANA4: JP5.2, R34.2, X9.1
ANA5: JP4.2, R40.2, X9.2
ANA6: JP3.2, R2.2, X9.3
ANA7: JP2.2, R3.2, X9.4
BKGD: IC1.56, JP1.1, R9.1
D0: IC1.26, X10.7
D1: IC1.27, X10.8
D2: IC1.28, X10.9
D3: IC1.29, X10.10
GND: C1.2, C2.1, C3.1, C4.2, C5.2, C6.1, C7.1, C8.1, C9.1, C11.1, C12.1, C13.1, C14.1, C18.1, C19.1, C21.1, C22.1, D1.A, D2.A, IC1.21, IC1.45, IC1.55, IC1.59, IC02.1, IC04.1, IC04.2, IC04.3, IC04.4, IC04.7, IC06.1, JP1.2, R59.1, R60.1, R61.1, R62.1, R63.1, R64.1, R65.1, R66.1, R85.1, R86.1, R87.1, R88.1, R89.3, T9.1, X3.2, X4.1, X4.3, X8.2, X10.1, X10.5
IRQ: IC1.2, R6.1
LCD_LED: IC1.49, R84.2
unnamed: C8.2, D4.K, IC02.3
unnamed: JP13.3, R58.1
unnamed: JP12.3, R57.1
unnamed: R69.2, T3.B2
unnamed: C4.1, IC1.57, Q1.2, R1.2
unnamed: C5.1, IC1.58, Q1.1, R1.1
unnamed: JP11.3, R56.1
unnamed: R71.2, T5.B2
unnamed: R72.2, T6.B2
unnamed: R73.2, T7.B2
unnamed: JP10.3, R55.1
unnamed: JP9.3, R53.1
unnamed: JP8.3, R52.1
unnamed: JP7.3, R51.1
unnamed: R5.1, X8.1
unnamed: IC1.30, X10.11
unnamed: IC1.31, X10.12
unnamed: IC1.32, X10.13
unnamed: IC1.33, X10.14
unnamed: R4.1, X3.1
unnamed: R67.2, T1.B2
unnamed: IC1.23, X10.6
unnamed: R68.2, T2.B2
unnamed: JP6.3, R50.1
unnamed: IC1.24, X10.4
unnamed: R70.2, T4.B2
unnamed: R89.2, X10.3
unnamed: JP6.1, R59.2
unnamed: JP7.1, R60.2
unnamed: JP8.1, R61.2
unnamed: JP9.1, R62.2
unnamed: R74.2, T8.B2
unnamed: JP10.1, R63.2
unnamed: JP11.1, R64.2
unnamed: JP12.1, R65.2
unnamed: JP13.1, R66.2
unnamed: C11.2, D3.K, IC06.3
unnamed: D3.A, X4.2
unnamed: R83.1, X10.15
unnamed: T9.3, X10.16
unnamed: R84.1, T9.2
unnamed: JP5.3, R26.1
unnamed: JP4.3, R25.1
unnamed: JP3.3, R24.1
unnamed: JP2.3, R23.1
unnamed: JP2.1, R85.2
unnamed: JP3.1, R86.2
unnamed: JP4.1, R87.2
unnamed: JP5.1, R88.2
PF0: R67.1, X6.1
PF1: R68.1, X6.2
PF2: R69.1, X6.3
PF3: R70.1, X6.4
PF4: R71.1, X7.1
PF5: R72.1, X7.2
PF6: R73.1, X7.3
PF7: R74.1, X7.4
RESET: C3.2, IC1.3, JP1.4, R13.1
SCL: IC1.60, IC04.6
SDA: IC1.61, IC04.5, R47.1
