valeb/Projekt/Datenblätter/RFID-MC522/Ú¦¦ÕÁîþöÁÕ¡ÉÕ¦äÚóæµ¿íÕØùÞÁäµûÖ/RC522_STM32/project 3.0.1 MFRC522/project.c

#include "Init_SYS.h"
#include "rc522.h"
#include "Lcd.h"

/*******************************
*连线说明：
*1--SS  <----->PB0
*2--SCK <----->PB13
*3--MOSI<----->PB15
*4--MISO<----->PB14
*5--悬空
*6--GND <----->GND
*7--RST <----->PB1
*8--VCC <----->VCC
************************************/

/************************************
各文件功能说明：
startup..s	系统的启动文件，无需考虑
retarget.c	c语言的一些函数
misc.c		包含一些中断的配置函数
project		主函数
initsys		主要是系统初始化函数
rc522		射频卡的一些操作函数
lcdili9320	lcd液晶屏的函数
*/


/*全局变量*/
unsigned char CT[2];//卡类型
unsigned char SN[4]; //卡号
u8 KEY[6]={0xff,0xff,0xff,0xff,0xff,0xff};
/*函数声明*/
void ShowID(u16 x,u16 y, u8 *p, u16 charColor, u16 bkColor);	 //显示卡的卡号，以十六进制显示
void PutNum(u16 x,u16 y, u32 n1,u8 n0, u16 charColor, u16 bkColor);	//显示余额函数
void Store(u8 *p,u8 store,u8 cash);//最重要的一个函数
u8 ReadData(u8   addr,u8 *pKey,u8 *pSnr,u8 *dataout);
u8 WriteData(u8   addr,u8 *pKey,u8 *pSnr,u8 *datain);

main()
{	
	unsigned char status;
	u8 Data[16];
	u8 i;
	u8 k;//读写错误重试次数

	RCC_Configuration(); //ARM时钟初始化
	NVIC_Configuration();//中断初始化
	GPIO_Configuration();//led初始化
	UART_Init(72,115200);//串口初始化
	printf("usart is ok\n");//串口输出数据，提示单片机及串口工作正常
	LCD_Init();					//液晶屏初始化
	LCD_Clear(WHITE);			//液晶屏清屏

	InitRc522();				//初始化射频卡模块

	GPIOC->BSRR=0X06;//led0 on
	while(1)													 
	{		
		
		if(!(USART_RX_STA&0x80))//串口发送的数据全部保存在USART_RX_BUF中，利用中断实现，每次数据完成后USART_RX_STA最高位置1
		{
			status = PcdRequest(PICC_REQALL,CT);/*扫描卡*/
			status = PcdAnticoll(SN);/*防冲撞*/
			if (status==MI_OK)
			{
				GPIOC->BRR=0x06;   //三个led全部点亮
				ShowID(0,100,SN,BLUE,WHITE); //在液晶屏上显示卡的ID号
				//printf("ID:%02x %02x %02x %02x\n",sn[0],sn[1],sn[2],sn[3]);//发送卡号
			}	
			else
			{
				GPIOC->BSRR=0X06;//只点亮led0
			}
		}
		else
		{
			status=0x02;//设置初始值
			k=5;		 //设置重复次数，有事读卡一次并不能成功
			do
		    {
				status=PcdRequest(PICC_REQALL,CT);/*扫描卡*/
				k--;						      
		    }while(status!=MI_OK && k>0);

			status=0x02;//
			k=5;
			do
		    {
				status=PcdAnticoll(SN);/*防冲撞*/
				k--;						      
		    }while(status!=MI_OK && k>0);

			status=0x02;//
			k=20;
			do
		    {
				status=PcdSelect(SN);//选卡
				k--;						      
		    }while(status!=MI_OK && k>0);

			if(status!=MI_OK)
			{
				printf("PcdSelect is wrong\n");
			}
			switch (USART_RX_BUF[0])
			{
				case 0xa0:  printf("ID:%02x %02x %02x %02x\n",SN[0],SN[1],SN[2],SN[3]);//发送卡号					  
							break;
				case 0xa1://读数据，一般不用，仅在测试以及对卡的特殊操作时使用
							status=ReadData(USART_RX_BUF[7],&USART_RX_BUF[1],SN,Data);
							if(status==MI_OK)
						    {
								printf("ReadData:");
								for(i=0;i<16;i++)
							    {
							      printf("%02x ",Data[i]);
							    }
								printf("\n\n");
							    PcdHalt();
							}
							else
							{
								printf("ReadData is wrong\n");
							}	
							break;
				case 0xa2://写数据，一般不用
							status=WriteData(USART_RX_BUF[7],&USART_RX_BUF[1],SN,&USART_RX_BUF[8]);
						    if(status!=MI_OK)
						    {
								printf("WriteData is wrong\n");						      
						    }
							else
							printf("WriteData is ok\n");
							break;
				case 0xa3://修改密码
							break;
				case '+' ://增加money
							Store(&USART_RX_BUF[1],1,1);
							break;
				case '-' ://减少money
							Store(&USART_RX_BUF[1],0,1);
							break;
				case '=' ://查看money
							Store(&USART_RX_BUF[1],1,0);
							break;
				default:
							break;
			}
			USART_RX_STA=0;//串口接收完成标志清零
		}
	}
}/*************************************
*函数功能：显示卡的卡号，以十六进制显示
*参数：x，y 坐标
*		p 卡号的地址
*		charcolor 字符的颜色
*		bkcolor   背景的颜色
***************************************/
void ShowID(u16 x,u16 y, u8 *p, u16 charColor, u16 bkColor)	 //显示卡的卡号，以十六进制显示
{
	u8 num[9];
	u8 i;

	for(i=0;i<4;i++)
	{
		num[i*2]=p[i]/16;
		num[i*2]>9?(num[i*2]+='7'):(num[i*2]+='0');
		num[i*2+1]=p[i]%16;
		num[i*2+1]>9?(num[i*2+1]+='7'):(num[i*2+1]+='0');
	}
	num[8]=0;

	DisplayString(x,y,"The Card ID is:",charColor,bkColor);
	DisplayString(x,y+16,num,charColor,bkColor);
}
/********************************
*函数功能：求p的n次幂
*/
int power(u8 p,u8 n)
{
	int pow=1;
	u8 i;
	for(i=0;i<n;i++)
	{
		pow*=p;	
	}
	return pow;
}
/******************************************
*函数功能：实现卡内金额的查询，充值以及扣费
*参数：	p    --金额
*		store--store为1，为充值，
*				store为0，为扣费
*		cash --cash为1，则为充值或扣费
*				cash为0，则查询余额
*******************************************/
void Store(u8 *p,u8 store,u8 cash)
{
	u8 data[16];
	u8 len=0;
	u8 i=0;
	u32 dec=0;
	u8 status;
	u8 tmp;

	status=ReadData(0x04,KEY,SN,data);
	dec=data[11];
	dec<<=8;
	dec+=data[12];
	dec<<=8;
	dec+=data[13];
	dec<<=8;
	dec+=data[14];

	if(!cash)
	{
		LCD_Fill(0,148,240,16,WHITE);
		DisplayString(0,148,"The Balance is:",RED,WHITE);
		PutNum(120,148,dec,data[15],RED,WHITE);
	}
	else
	{
		while(p[len]!='.')
		{
			len++;
		}

		if(store)
		{
			data[15]+=p[len+1]-'0';
			if(data[15]>9)
			{
				data[15]-=10;
				dec++;
			}
			while(len--)
			{
				dec+=(p[len]-'0')*power(10,i);
				i++;
					
			}
		}
		else
		{
			if(data[15]<p[len+1]-'0')
			{
				data[15]+=10;
				dec--;
			}
			data[15]-=p[len+1]-'0';
			
			while(len--)
			{
				if(dec<(p[len]-'0')*power(10,i))
				{
					DisplayString(0,164,"You do not have enough money!",RED,WHITE);
					goto End;	
				}
				dec-=(p[len]-'0')*power(10,i);
				i++;
					
			}
		}
	
		LCD_Fill(0,164,240,16,WHITE);
		DisplayString(0,164,"The Balance is:",RED,WHITE);
		PutNum(120,164,dec,data[15],RED,WHITE);
	
		data[14]=dec&0xff;
		data[13]=(dec>>8)&0xff;
		data[12]=(dec>>16)&0xff;
		data[11]=(dec>>24)&0xff;
	
End:	status=WriteData(0X04,KEY,SN,data);

	
	}
}

u8 ReadData(u8   addr,u8 *pKey,u8 *pSnr,u8 *dataout)
{
	u8 status,k;
	status=0x02;//
	k=5;
	do
    {
		status=PcdAuthState(PICC_AUTHENT1A,addr,pKey,pSnr);
		k--;
		//printf("AuthState is wrong\n");						      
    }while(status!=MI_OK && k>0);

	status=0x02;//
	k=5;
	do
    {
		status=PcdRead(addr,dataout);
		k--;
		//printf("ReadData is wrong\n");							      
    }while(status!=MI_OK && k>0);
	return status;
}
u8 WriteData(u8   addr,u8 *pKey,u8 *pSnr,u8 *datain)
{
	u8 status,k;
	status=0x02;//
	k=5;
	do
    {
		status=PcdAuthState(PICC_AUTHENT1A,addr,pKey,pSnr);
		k--;
		//printf("AuthState is wrong\n");						      
    }while(status!=MI_OK && k>0);

	status=0x02;//
	k=5;
	do
    {
		status=PcdWrite(addr,datain);
		k--;
		//printf("ReadData is wrong\n");							      
    }while(status!=MI_OK && k>0);
	return status;
}
void PutNum(u16 x,u16 y, u32 n1,u8 n0, u16 charColor, u16 bkColor)
{
	u8 tmp[13];
	u8 i;

	LCD_SetRegion(0,0,239,319,FALSE);
	tmp[0]=n1/1000000000+'0';
	for(i=1;i<10;i++)
	{
		tmp[i]=n1/(1000000000/power(10,i))%10+'0';
	}
	tmp[10]='.';
	tmp[11]=n0+'0';
	tmp[12]=0;
	DisplayString(x,y,tmp,charColor,bkColor);


	
}
