valeb/Projekt/Datenblätter/RFID-MC522/Ú¦¦ÕÁîþöÁÕ¡ÉÕ¦äÚóæµ¿íÕØùÞÁäµûÖ/RC522_STM32/project 3.0.1 MFRC522/user/Lcd_font.h

// 8x16 ASCII
unsigned char const ascii_8x16[1536] = {
0x00,0x00,0x00,0x00,0x00,0x00,0x00,0x00,0x00,0x00,0x00,0x00,0x00,0x00,0x00,0x00,
0x00,0x00,0x18,0x3C,0x3C,0x3C,0x18,0x18,0x18,0x00,0x18,0x18,0x00,0x00,0x00,0x00,
0x00,0x66,0x66,0x66,0x24,0x00,0x00,0x00,0x00,0x00,0x00,0x00,0x00,0x00,0x00,0x00,
0x00,0x00,0x00,0x6C,0x6C,0xFE,0x6C,0x6C,0x6C,0xFE,0x6C,0x6C,0x00,0x00,0x00,0x00,
0x18,0x18,0x7C,0xC6,0xC2,0xC0,0x7C,0x06,0x86,0xC6,0x7C,0x18,0x18,0x00,0x00,0x00,
0x00,0x00,0x00,0x00,0xC2,0xC6,0x0C,0x18,0x30,0x60,0xC6,0x86,0x00,0x00,0x00,0x00,
0x00,0x00,0x38,0x6C,0x6C,0x38,0x76,0xDC,0xCC,0xCC,0xCC,0x76,0x00,0x00,0x00,0x00,
0x00,0x30,0x30,0x30,0x60,0x00,0x00,0x00,0x00,0x00,0x00,0x00,0x00,0x00,0x00,0x00,
0x00,0x00,0x0C,0x18,0x30,0x30,0x30,0x30,0x30,0x30,0x18,0x0C,0x00,0x00,0x00,0x00,
0x00,0x00,0x30,0x18,0x0C,0x0C,0x0C,0x0C,0x0C,0x0C,0x18,0x30,0x00,0x00,0x00,0x00,
0x00,0x00,0x00,0x00,0x00,0x66,0x3C,0xFF,0x3C,0x66,0x00,0x00,0x00,0x00,0x00,0x00,
0x00,0x00,0x00,0x00,0x00,0x18,0x18,0x7E,0x18,0x18,0x00,0x00,0x00,0x00,0x00,0x00,
0x00,0x00,0x00,0x00,0x00,0x00,0x00,0x00,0x00,0x18,0x18,0x18,0x30,0x00,0x00,0x00,
0x00,0x00,0x00,0x00,0x00,0x00,0x00,0xFE,0x00,0x00,0x00,0x00,0x00,0x00,0x00,0x00,
0x00,0x00,0x00,0x00,0x00,0x00,0x00,0x00,0x00,0x00,0x18,0x18,0x00,0x00,0x00,0x00,
0x00,0x00,0x00,0x00,0x02,0x06,0x0C,0x18,0x30,0x60,0xC0,0x80,0x00,0x00,0x00,0x00,
0x00,0x00,0x7C,0xC6,0xC6,0xCE,0xD6,0xD6,0xE6,0xC6,0xC6,0x7C,0x00,0x00,0x00,0x00,
0x00,0x00,0x18,0x38,0x78,0x18,0x18,0x18,0x18,0x18,0x18,0x7E,0x00,0x00,0x00,0x00,
0x00,0x00,0x7C,0xC6,0x06,0x0C,0x18,0x30,0x60,0xC0,0xC6,0xFE,0x00,0x00,0x00,0x00,
0x00,0x00,0x7C,0xC6,0x06,0x06,0x3C,0x06,0x06,0x06,0xC6,0x7C,0x00,0x00,0x00,0x00,
0x00,0x00,0x0C,0x1C,0x3C,0x6C,0xCC,0xFE,0x0C,0x0C,0x0C,0x1E,0x00,0x00,0x00,0x00,
0x00,0x00,0xFE,0xC0,0xC0,0xC0,0xFC,0x0E,0x06,0x06,0xC6,0x7C,0x00,0x00,0x00,0x00,
0x00,0x00,0x38,0x60,0xC0,0xC0,0xFC,0xC6,0xC6,0xC6,0xC6,0x7C,0x00,0x00,0x00,0x00,
0x00,0x00,0xFE,0xC6,0x06,0x06,0x0C,0x18,0x30,0x30,0x30,0x30,0x00,0x00,0x00,0x00,
0x00,0x00,0x7C,0xC6,0xC6,0xC6,0x7C,0xC6,0xC6,0xC6,0xC6,0x7C,0x00,0x00,0x00,0x00,
0x00,0x00,0x7C,0xC6,0xC6,0xC6,0x7E,0x06,0x06,0x06,0x0C,0x78,0x00,0x00,0x00,0x00,
0x00,0x00,0x00,0x00,0x18,0x18,0x00,0x00,0x00,0x18,0x18,0x00,0x00,0x00,0x00,0x00,
0x00,0x00,0x00,0x00,0x18,0x18,0x00,0x00,0x00,0x18,0x18,0x30,0x00,0x00,0x00,0x00,
0x00,0x00,0x00,0x06,0x0C,0x18,0x30,0x60,0x30,0x18,0x0C,0x06,0x00,0x00,0x00,0x00,
0x00,0x00,0x00,0x00,0x00,0x00,0xFE,0x00,0x00,0xFE,0x00,0x00,0x00,0x00,0x00,0x00,
0x00,0x00,0x00,0x60,0x30,0x18,0x0C,0x06,0x0C,0x18,0x30,0x60,0x00,0x00,0x00,0x00,
0x00,0x00,0x7C,0xC6,0xC6,0x0C,0x18,0x18,0x18,0x00,0x18,0x18,0x00,0x00,0x00,0x00,
0x00,0x00,0x00,0x7C,0xC6,0xC6,0xDE,0xDE,0xDE,0xDC,0xC0,0x7C,0x00,0x00,0x00,0x00,
0x00,0x00,0x10,0x38,0x6C,0xC6,0xC6,0xFE,0xC6,0xC6,0xC6,0xC6,0x00,0x00,0x00,0x00,
0x00,0x00,0xFC,0x66,0x66,0x66,0x7C,0x66,0x66,0x66,0x66,0xFC,0x00,0x00,0x00,0x00,
0x00,0x00,0x3C,0x66,0xC2,0xC0,0xC0,0xC0,0xC0,0xC2,0x66,0x3C,0x00,0x00,0x00,0x00,
0x00,0x00,0xF8,0x6C,0x66,0x66,0x66,0x66,0x66,0x66,0x6C,0xF8,0x00,0x00,0x00,0x00,
0x00,0x00,0xFE,0x66,0x62,0x68,0x78,0x68,0x60,0x62,0x66,0xFE,0x00,0x00,0x00,0x00,
0x00,0x00,0xFE,0x66,0x62,0x68,0x78,0x68,0x60,0x60,0x60,0xF0,0x00,0x00,0x00,0x00,
0x00,0x00,0x3C,0x66,0xC2,0xC0,0xC0,0xDE,0xC6,0xC6,0x66,0x3A,0x00,0x00,0x00,0x00,
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
};
