valeb/Projekt/Datenblätter/RFID-MC522/Ú¦¦ÕÁîþöÁÕ¡ÉÕ¦äÚóæµ¿íÕØùÞÁäµûÖ/RC522_STM32/project 3.0.1 MFRC522/user/Init_SYS.c

#include "Init_SYS.h"

void delay_us(u32 Nus)
{ 
 SysTick->LOAD=9*Nus;       //时间加载      
 SysTick->CTRL|=0x01;            //开始倒数    
 while(!(SysTick->CTRL&(1<<16)));//等待时间到达 
 SysTick->CTRL=0X00000000;       //关闭计数器
 SysTick->VAL=0X00000000;        //清空计数器     
}
void delay_ms(u32 Nus)
{ 
 SysTick->LOAD=9000*Nus;       //时间加载      
 SysTick->CTRL|=0x01;            //开始倒数    
 while(!(SysTick->CTRL&(1<<16)));//等待时间到达 
 SysTick->CTRL=0X00000000;       //关闭计数器
 SysTick->VAL=0X00000000;        //清空计数器     
}
void MY_NVIC_SetVectorTable(u32 NVIC_VectTab, u32 Offset)	 
{ 
  	//检查参数合法性
	assert_param(IS_NVIC_VECTTAB(NVIC_VectTab));
	assert_param(IS_NVIC_OFFSET(Offset));  	 
	SCB->VTOR = NVIC_VectTab|(Offset & (u32)0x1FFFFF80);//设置NVIC的向量表偏移寄存器
	//用于标识向量表是在CODE区还是在RAM区
}
//设置NVIC分组
//NVIC_Group:NVIC分组 0~4 总共5组 
//CHECK OK
//091209/
void MyRCC_DeInit(void)
{										  					   
	RCC->APB1RSTR = 0x00000000;//复位结束			 
	RCC->APB2RSTR = 0x00000000; 
	  
  	RCC->AHBENR = 0x00000014;  //睡眠模式闪存和SRAM时钟使能.其他关闭.	  
  	RCC->APB2ENR = 0x00000000; //外设时钟关闭.			   
  	RCC->APB1ENR = 0x00000000;   
	RCC->CR |= 0x00000001;     //使能内部高速时钟HSION	 															 
	RCC->CFGR &= 0xF8FF0000;   //复位SW[1:0],HPRE[3:0],PPRE1[2:0],PPRE2[2:0],ADCPRE[1:0],MCO[2:0]					 
	RCC->CR &= 0xFEF6FFFF;     //复位HSEON,CSSON,PLLON
	RCC->CR &= 0xFFFBFFFF;     //复位HSEBYP	   	  
	RCC->CFGR &= 0xFF80FFFF;   //复位PLLSRC, PLLXTPRE, PLLMUL[3:0] and USBPRE 
	RCC->CIR = 0x00000000;     //关闭所有中断
	//配置向量表				  
#ifdef  VECT_TAB_RAM
	MY_NVIC_SetVectorTable(NVIC_VectTab_RAM, 0x0);
#else   
	MY_NVIC_SetVectorTable(NVIC_VectTab_FLASH, 0x0);
#endif
}


void RCC_Configuration()
{
	unsigned char temp=0;
	uint8_t PLL=9;//9倍频输出   
	MyRCC_DeInit();		  //复位并配置向量表
	RCC->CR|=0x00010000;  //外部高速时钟使能HSEON
	while(!(RCC->CR>>17));//等待外部时钟就绪
	RCC->CFGR=0X00000400; //APB1=DIV2;APB2=DIV1;AHB=DIV1;
	PLL-=2;//抵消2个单位
	RCC->CFGR|=PLL<<18;   //设置PLL值 2~16
	RCC->CFGR|=1<<16;	  //PLLSRC ON 
	FLASH->ACR|=0x32;	  //FLASH 2个延时周期

	RCC->CR|=0x01000000;  //PLLON
	while(!(RCC->CR>>25));//等待PLL锁定
	RCC->CFGR|=0x00000002;//PLL作为系统时钟	 
	while(temp!=0x02)     //等待PLL作为系统时钟设置成功
	{   
		temp=RCC->CFGR>>2;
		temp&=0x03;
	}    
}

void NVIC_Configuration(void)
{
  NVIC_InitTypeDef NVIC_InitStructure;

  /* Configure the NVIC Preemption Priority Bits */
  NVIC_PriorityGroupConfig(NVIC_PriorityGroup_1);


#ifdef USART1_IRQ
  NVIC_InitStructure.NVIC_IRQChannel = USART1_IRQn;
  NVIC_InitStructure.NVIC_IRQChannelPreemptionPriority = 1;
  NVIC_InitStructure.NVIC_IRQChannelSubPriority = 0;
  NVIC_InitStructure.NVIC_IRQChannelCmd = ENABLE;  
  NVIC_Init(&NVIC_InitStructure);
#endif
}

#ifdef USART1_IRQ   //如果使能了接收
//串口1中断服务程序
//注意,读取USARTx->SR能避免莫名其妙的错误   	
u8 USART_RX_BUF[64];     //接收缓冲,最大64个字节.
//接收状态
//bit7，接收完成标志
//bit6，接收到0x0d
//bit5~0，接收到的有效字节数目
u8 USART_RX_STA=0;       //接收状态标记	  
  
void USART1_IRQHandler(void)
{
	u8 res;

		    
		if(USART1->SR&(1<<5))//接收到数据
		{	 
			res=USART1->DR; 
		
			if(res==0x0d)	 //0X0D，在串口调试助手中设置自动添加附加位为0x0d
			{
				USART_RX_STA|=0x80;
				
			}
			else
			{
				USART_RX_BUF[USART_RX_STA&0X7F]=res;
				USART_RX_STA++;
				if((USART_RX_STA&0X7F)>63)USART_RX_STA=0;//接收数据错误,重新开始接收	  
			}		 
		}
		  		 									     
	  											 
} 
#endif
void GPIO_Configuration(void)
{  
  /* Enable GPIO_LED clock */
	RCC->APB2ENR|=1<<4;//使能GPIOC时钟
	//LED_init-------------------------------------------------------
	////配置管脚
	GPIOC->CRL&=0XFFFFF000;
	GPIOC->CRL|=0x00000333; 
  
}

void UART_Init(u32 pclk2,u32 bound)
{  	 
	float temp;
	u16 mantissa;
	u16 fraction;	   
	temp=(float)(pclk2*1000000)/(bound*16);//得到USARTDIV
	mantissa=temp;				 //得到整数部分
	fraction=(temp-mantissa)*16; //得到小数部分	 
    mantissa<<=4;
	mantissa+=fraction; 
	RCC->APB2ENR|=1<<2;   //使能PORTA口时钟  
	RCC->APB2ENR|=1<<14;  //使能串口时钟 
	GPIOA->CRH&=0XFFFFF00F; 
	GPIOA->CRH|=0X000008B0;//IO状态设置
		  
	RCC->APB2RSTR|=1<<14;   //复位串口1
	RCC->APB2RSTR&=~(1<<14);//停止复位	   	   
	//波特率设置
 	USART1->BRR=mantissa; // 波特率设置	 
	USART1->CR1|=0X200C;  //1位停止,无校验位.
#ifdef USART1_IRQ		  //如果使能了接收
	//使能接收中断
	USART1->CR1|=1<<8;    //PE中断使能
	USART1->CR1|=1<<5;    //接收缓冲区非空中断使能	    	
	
#endif

}


/*----------------------------------------------------------------------------
  从串口发送一个字节数据
  Write character to Serial Port.
 *----------------------------------------------------------------------------*/
int SendChar (int ch)  {

  //等待发送结束
  while (!(USART1->SR & 0X80));
  //将数据放入发送寄存器
  USART1->DR = (ch & 0x1FF);

  return (ch);
}

/*----------------------------------------------------------------------------
  从串口读取一个字节数据，直到读到数据才返回
  Read character to Serial Port.
 *----------------------------------------------------------------------------*/
int GetKey (void)  {

  //等待接收结束
  while (!(USART1->SR & 0X40));
  //从接受寄存器读取数据并返回
  return ((int)(USART1->DR & 0x1FF));
}
