valeb/Projekt/(commit log)

2013-09-27 Gantt-Diagramm erstellt
    [Gantt-Diagramm.xlsx]
2013-09-29 Gantt-Diagramm aktualisiert
    [Gantt-Diagramm.xlsx]
2013-11-03 Gantt-Diagramm beendet, Eagle begonnen (Auio und Versorgung, Bibliothek), Software begonnn
    [AW32_Demoboard_V11_DLN_18319.brd, AW32_Demoboard_V11_DLN_18319.sch, Demoboard_Reste.brd, Demoboard_Reste.sch, Gantt-Diagramm.ods, Lautsprecher.sch, Scm_V10.sch, Versorgung.sch]
2014-01-07 add Board-Fertig, add Testsoftware
    [Alarmanlage_V40.brd]
2014-01-07 changed Gantt-Diagramm
    [Gantt-Diagramm.ods]
2014-01-08 change Gant-Diagramm, add Board_fertig
2014-01-08 Board. Gantt, Software
    [Alarmanlage_V40.brd]
2014-01-12 mod SW_AW32_Alarmanlage_V10: add Passwort, add Bewegungsmelder, add Alarton; mod Gantt-Diagramm.ods
    [Gantt-Diagramm.ods]
2014-01-20 add Timerinterrupt.inc, mod Folders, mod Ganttdiagramm, del Ganttdiagramm.docx
    [Alarmanlage_V40.brd, Gantt-Diagramm.ods, Gantt-Diagramm.xlsx]
2014-01-29 add Frequenzen-Berechner, mod Alarm_Test
    [Berechner.ods]
2014-01-30 mod Timerinterrupt_V10
2014-02-02 finish Alarm_Testsoftware, mod Gesamtprogramm (add Timerinterrupt_V20.inc, mod Alarmton.inc), mod Ganttdiagramm
    [Berechner.ods, Gantt-Diagramm.ods]
2014-02-03 add Gesamtprogramm_V20, RealTime auf Timer 1 Channel 0
2014-02-09 add Testsoftware/Bewegungsmelder, mod Gesamtsoftware_V20: mod Bewegungsmelder.inc
    [Alarmanlage_V40.brd, Berechner.ods, Gantt-Diagramm.ods]
2014-02-23 mod Geamtwoftware_V20: add Tatenreutine, alle Tasten
    [STARTUP.OBJ, key.obj, main.obj, rc522.obj]
2014-03-06 Add Bilder-Ordner
    [Gantt-Diagramm.ods]
2014-03-06 add Version 3.0, include RFID, still doesnt work, fix Rechtschreibfehler
    [BDM_P&E_Multilink_CyclonePro.ini, HCS08_Full_Chip_Simulator.ini]
2014-03-21 mod Gesamtprogramm_V30: fix 'Can't find ASM-Layout', mod RFID_Test, still doesnt work properly
    [BDM_P&E_Multilink_CyclonePro.ini]
2014-03-27 mod RFID, add Dokumentation, add Befehlsliste, RFID still doesn't work
    [Gantt-Diagramm.ods]
2014-03-27 add Ports
    [Alarmanlage_V40.brd, Ports.ods]
2014-04-27 exp Dokumentation, 9 pages now
    [AdlerSTL.stl, Deckel.fcstd, Deckel_Bernard.stl, Deckel_Bernard_2.stl, Demoboard_Reste.brd, Gesamtschaltung.brd, Gesamtschaltung.sch, Huelle_Bernard_2.stl]
2014-05-02 add Board
    [Alarmanlage_V40.brd, Berechner.ods, Gantt-Diagramm.ods, Gesamtschaltung.brd, Gesamtschaltung.sch]
2014-05-04 edit Dokumentation, add diverse Bilder
    [Gesamtschaltung.brd, Gesamtschaltung.sch, STARTUP.OBJ, key.obj, main.obj, rc522.obj]
2014-05-08 add bilder Schaltung, add Bauteilliste, add Bild MosFet, extend Dokumentation
    [Bauteilliste.ods, Gesamtschaltung.brd, Gesamtschaltung.sch]
